chaBotsMX/chaBots-RCJ-IR-2026/Mechanical/Media/GurtV2.PNG

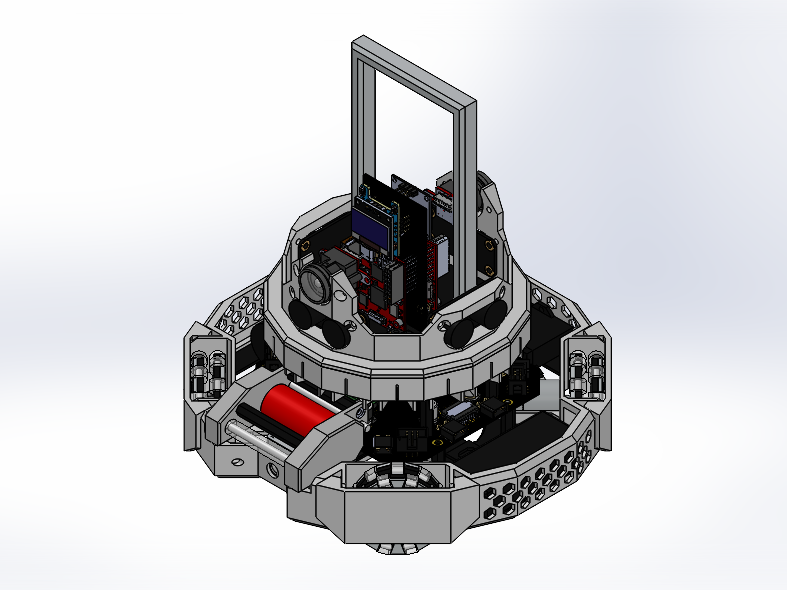
Mechanical/Media/GurtV2.PNG
