chaBotsMX/chaBots-RCJ-IR-2026/Mechanical/Media/GurtV1.PNG

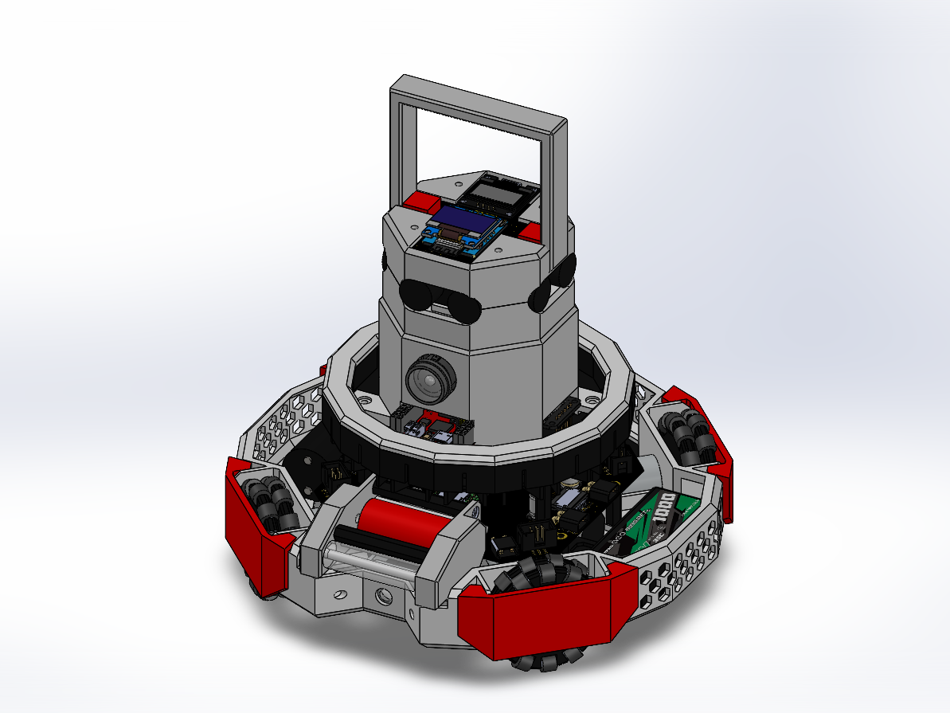
Mechanical/Media/GurtV1.PNG
