chaBotsMX/chaBots-RCJ-IR-2026/Electrical/Media/BallSensor16.png

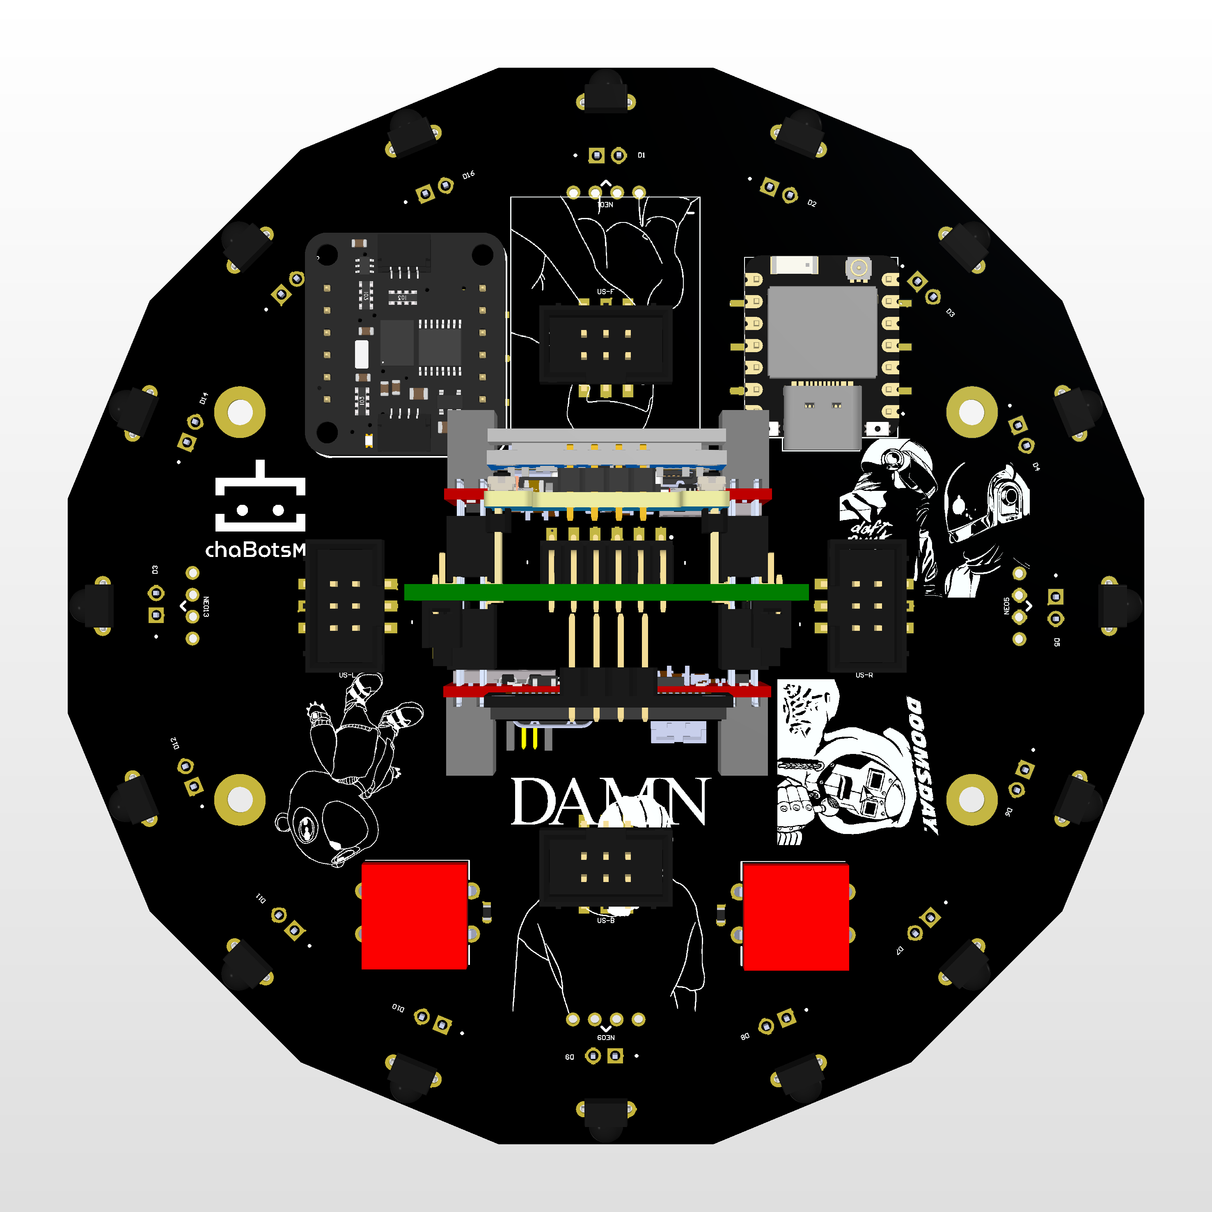
Electrical/Media/BallSensor16.png
