chaBotsMX/chaBots-RCJ-IR-2026/Electrical/Media/LightArray.png

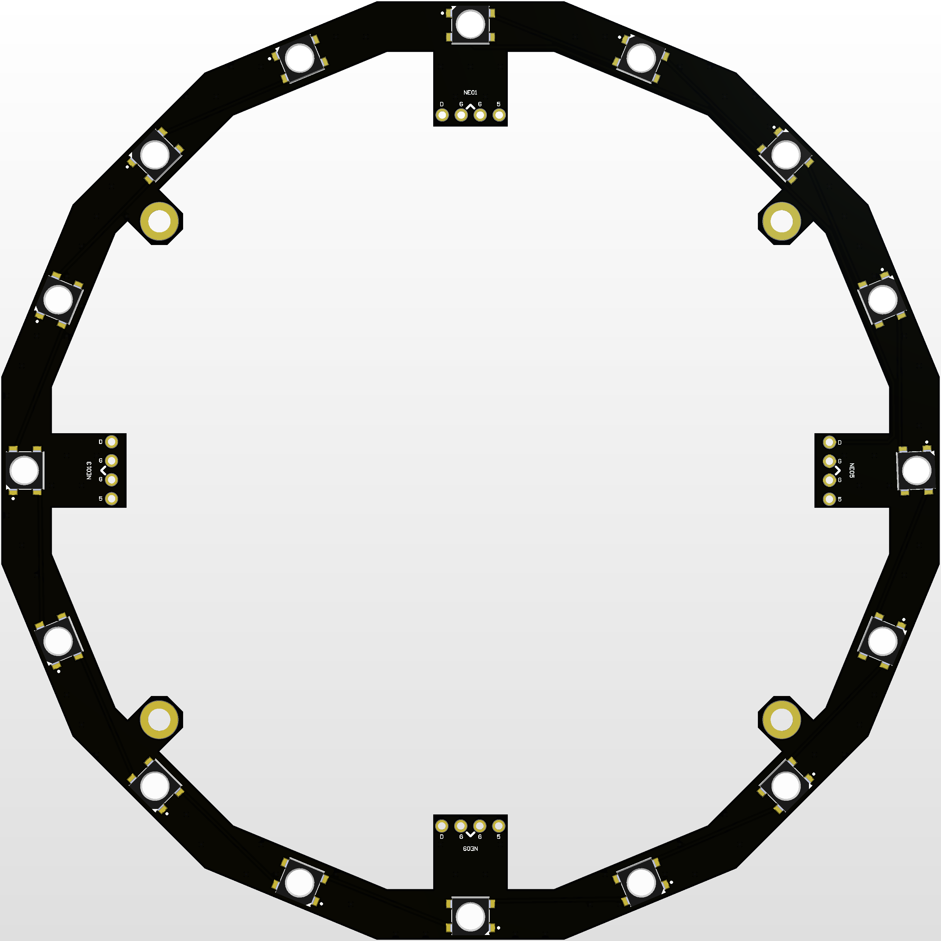
Electrical/Media/LightArray.png
