chaBotsMX/chaBots-RCJ-IR-2026/Electrical/Media/LightBarrier.png

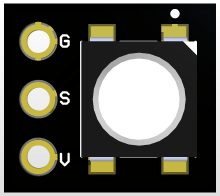
Electrical/Media/LightBarrier.png
