chaBotsMX/chaBots-RCJ-IR-2026/Electrical/Media/LineSensor32.png

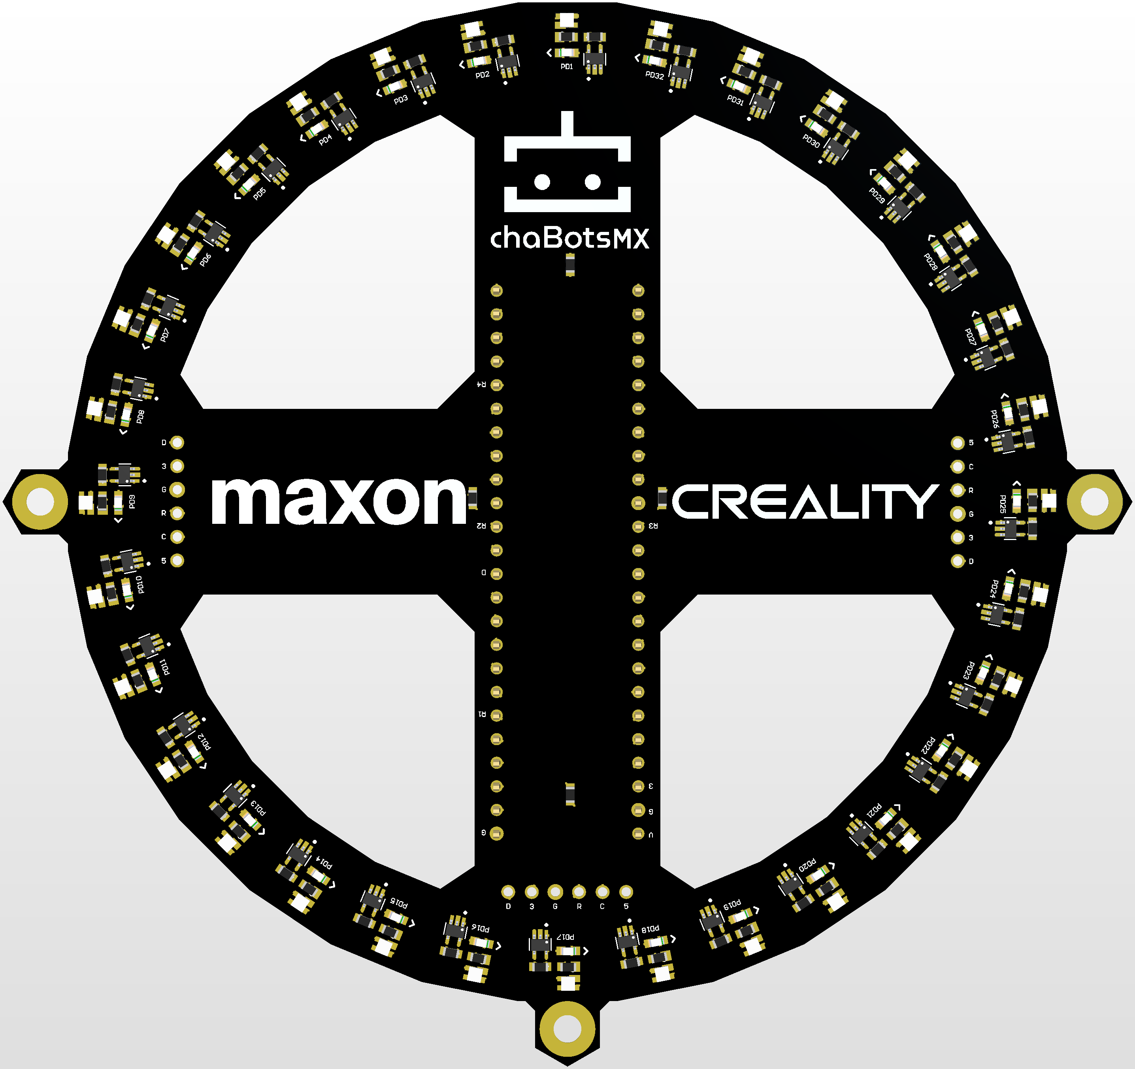
Electrical/Media/LineSensor32.png
