chaBotsMX/chaBots-RCJ-IR-2026/Electrical/Media/MainBoard-16.png

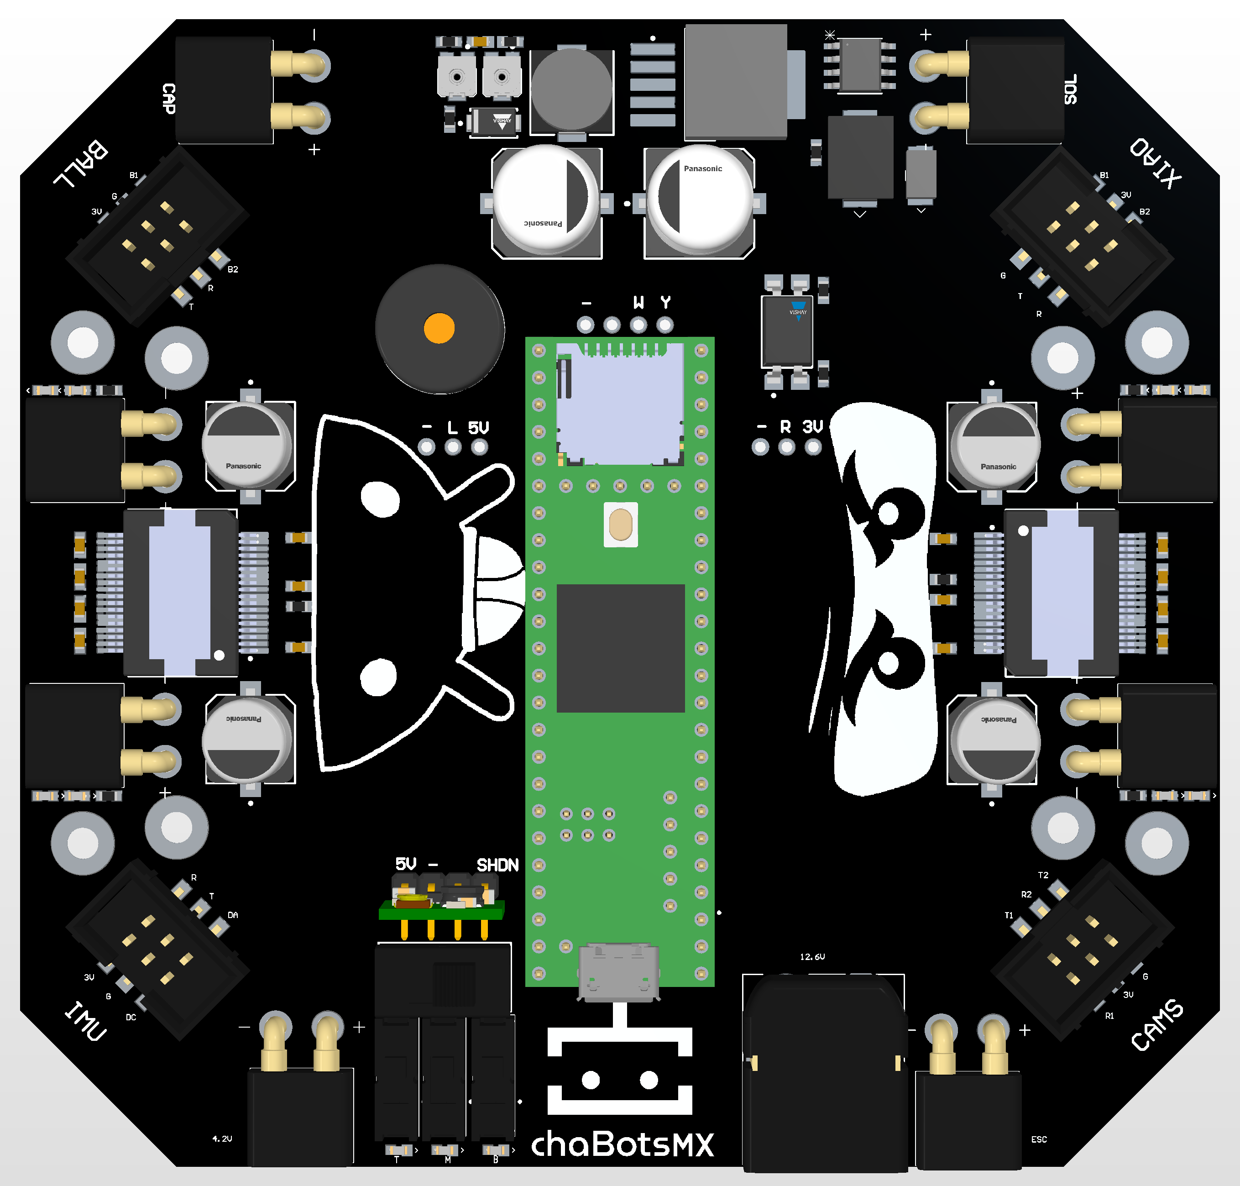
Electrical/Media/MainBoard-16.png
