chaBotsMX/chaBots-RCJ-IR-2026/Electrical/Media/OpenMVMount.png

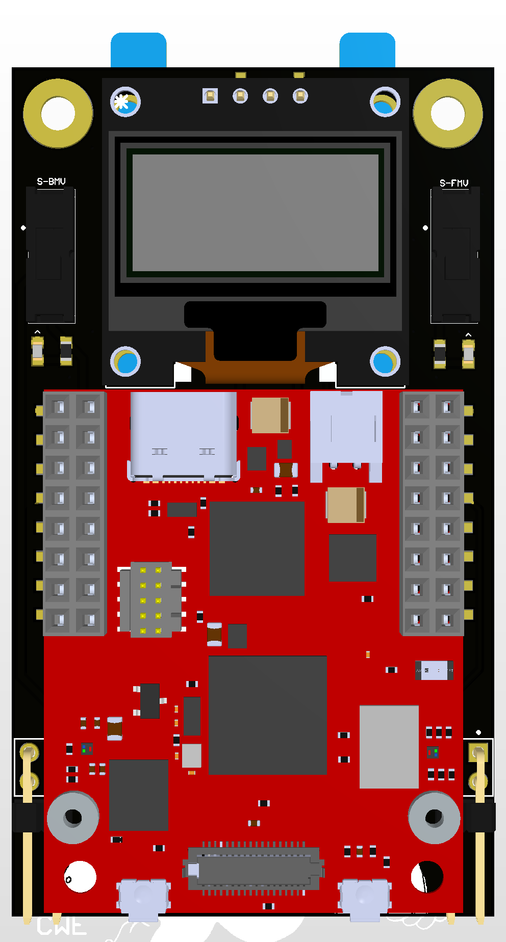
Electrical/Media/OpenMVMount.png
