chaBotsMX/chaBots-RCJ-IR-2026/Electrical/Media/SideLine.png

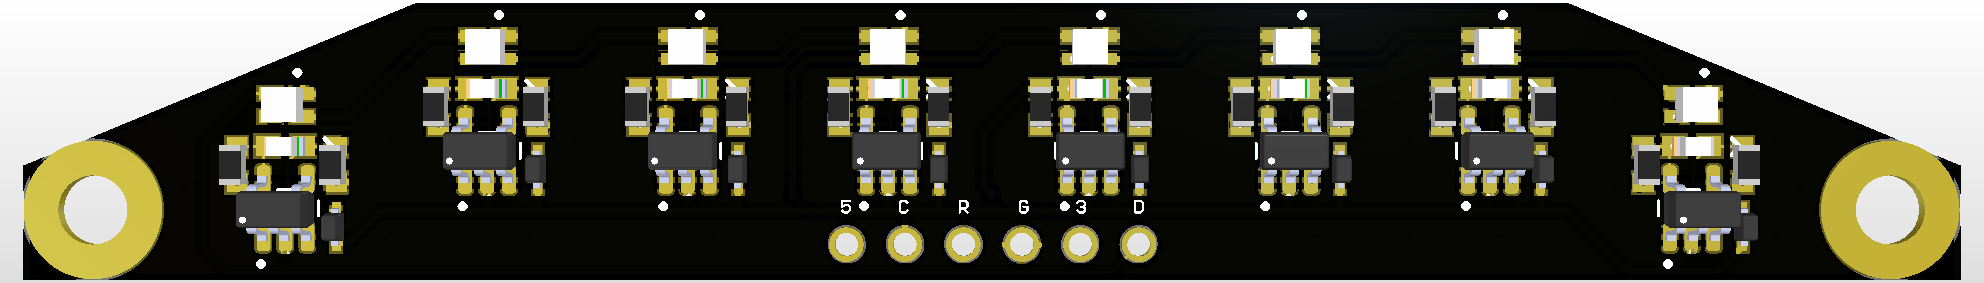
Electrical/Media/SideLine.png
