chaBotsMX/chaBots-RCJ-IR-2026/Mechanical/Media/45mm Wheel.PNG

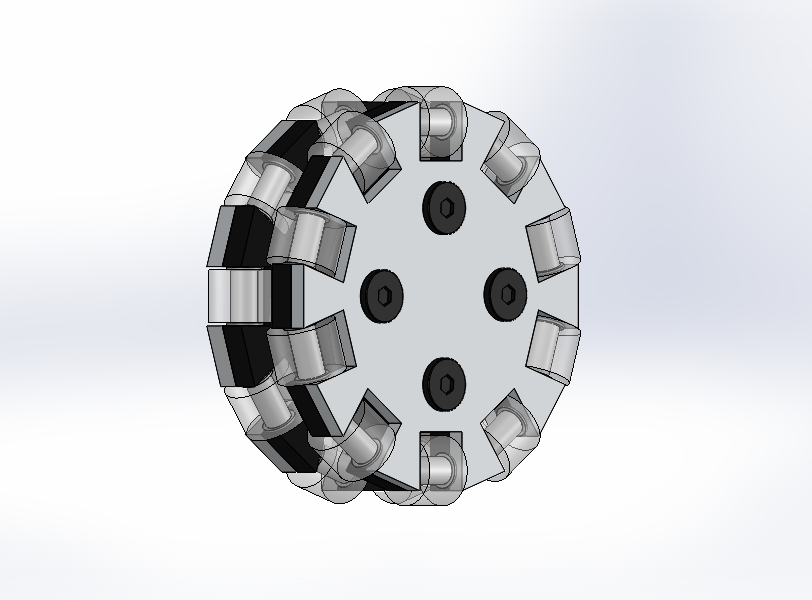
Mechanical/Media/45mm Wheel.PNG
