chaBotsMX/chaBots-RCJ-IR-2026/Mechanical/Media/Dribbler.PNG

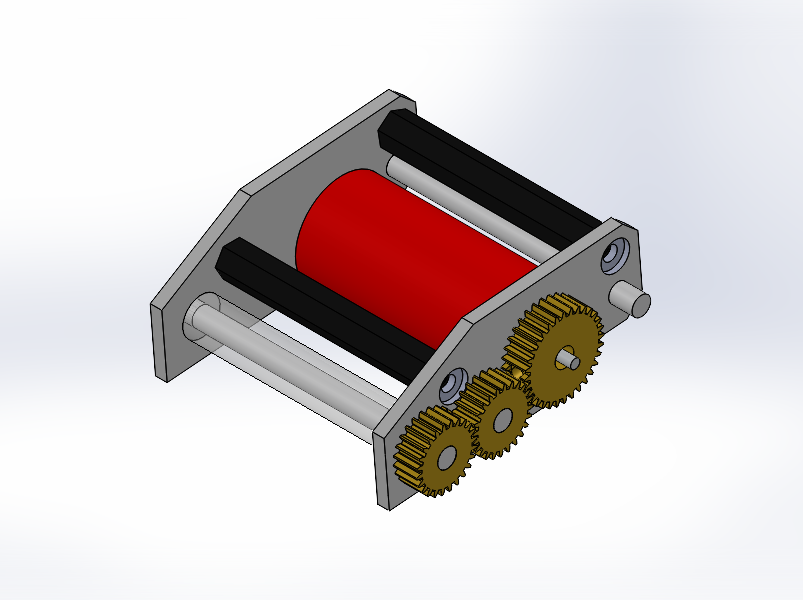
Mechanical/Media/Dribbler.PNG
