chaBotsMX/chaBots-RCJ-IR-2026/Mechanical/Dribbler/Dribbler.SLDASM

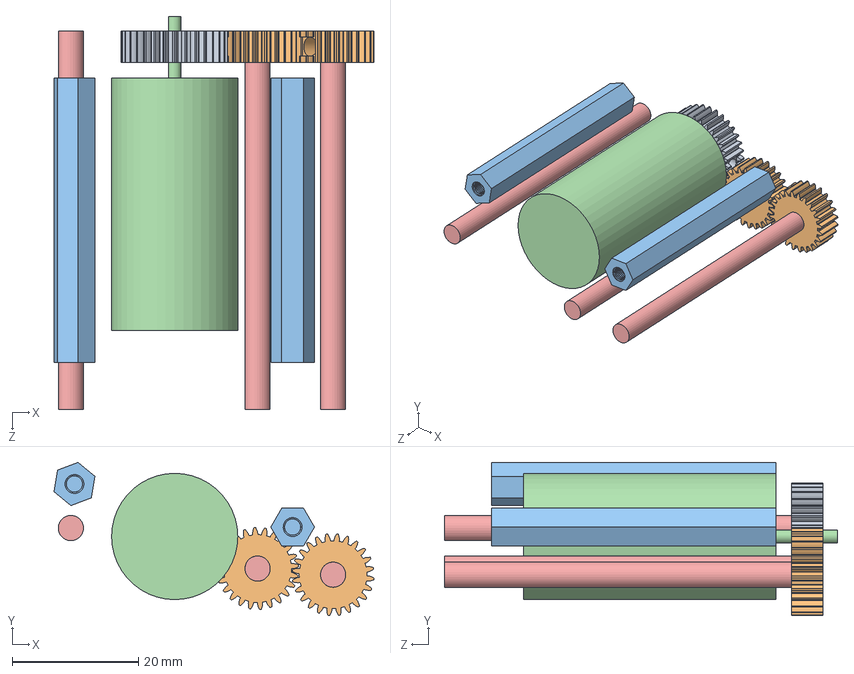
[picture p12: CAD file, 2026-05-15]
Mechanical/Dribbler/Dribbler.SLDASM
50.7 x 24.3 x 62.3 mm
dribbler-rod x 3
Standoff45mmM3 x 2
gear-small x 2
gear-big
