chaBotsMX/chaBots-RCJ-IR-2026/Mechanical/Wheel/wheel.SLDASM

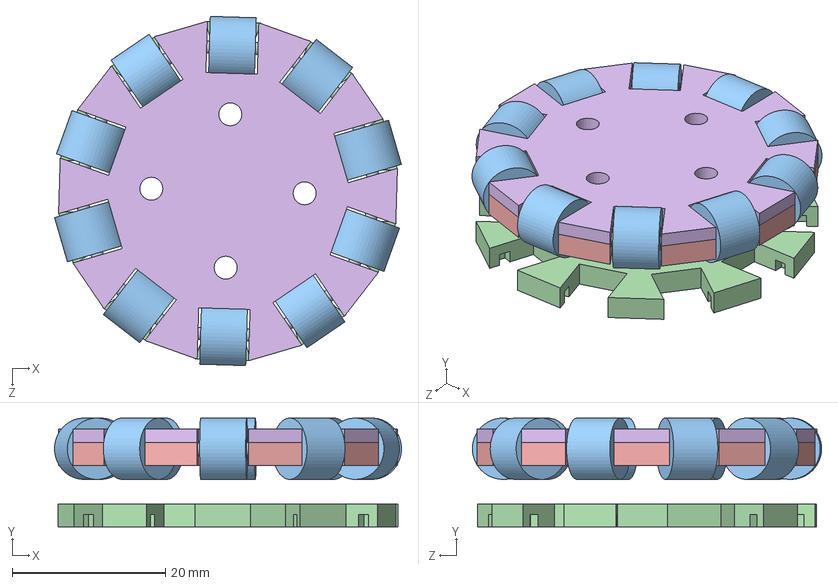
[picture p13: CAD file, 2026-05-15]
Mechanical/Wheel/wheel.SLDASM
45.2 x 14.2 x 45.5 mm
Wheel-10-Front
Wheel-10-Back
Wheel-10-Back-Back
SiliconeRoller8mm x 10
Sleeve x 10
DowelPin9mm-1.5mm x 10
