chaBotsMX/chaBots-RCJ-IR-2026/Mechanical/V2/main-pcb-shape.SLDPRT

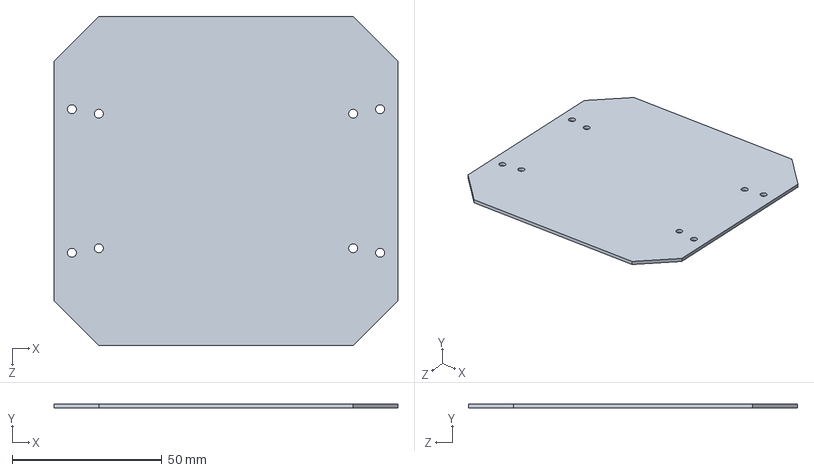
[picture p14: CAD file, 2026-05-15]
Mechanical/V2/main-pcb-shape.SLDPRT
115.0 x 1.50 x 110.0 mm
