chaBotsMX/chaBots-RCJ-IR-2026/Mechanical/Dribbler/gear-small.SLDPRT

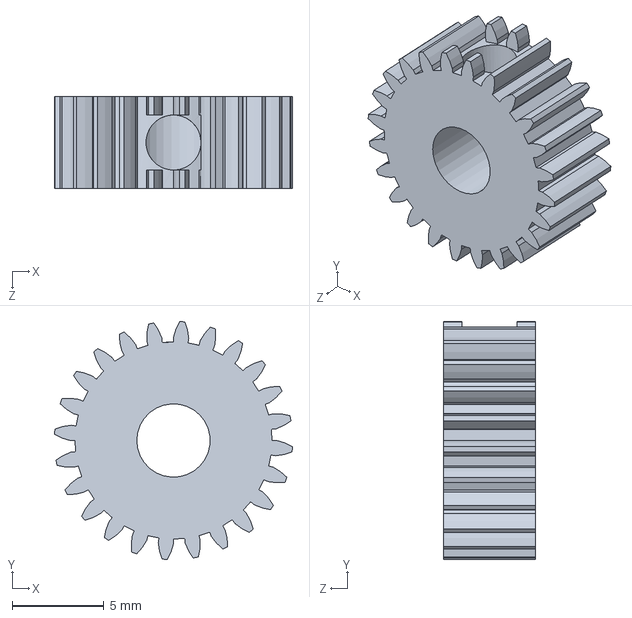
[picture p15: CAD file, 2026-05-15]
Mechanical/Dribbler/gear-small.SLDPRT
13.0 x 13.0 x 5.00 mm
