chaBotsMX/chaBots-RCJ-IR-2026/Mechanical/V2/wheel-guard.SLDPRT

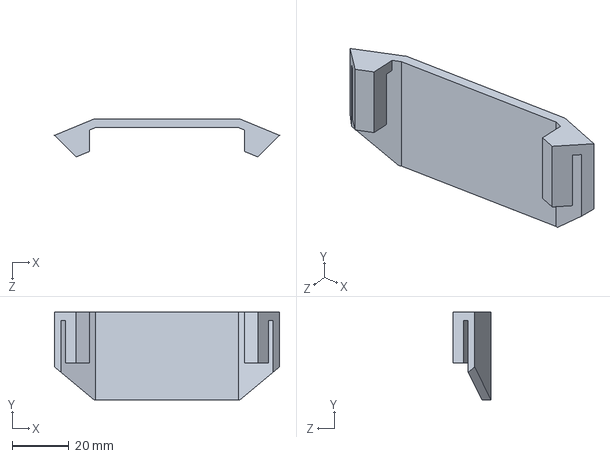
[picture p16: CAD file, 2026-05-15]
Mechanical/V2/wheel-guard.SLDPRT
79.6 x 31.0 x 13.4 mm
