chaBotsMX/chaBots-RCJ-IR-2026/Mechanical/Wheel/SiliconeRoller8mm.SLDPRT

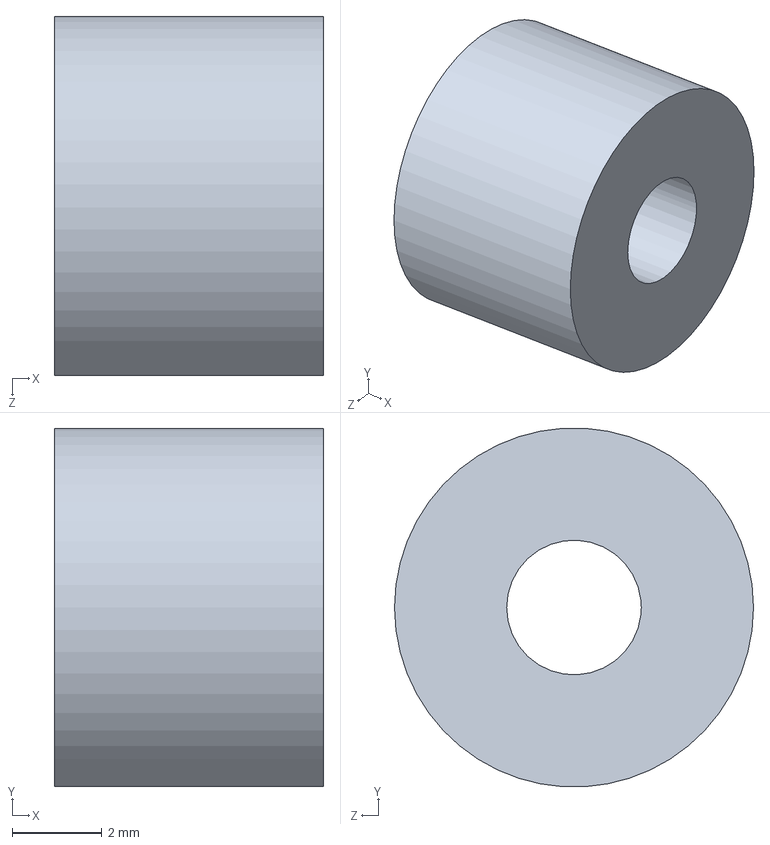
[picture p17: CAD file, 2026-05-15]
Mechanical/Wheel/SiliconeRoller8mm.SLDPRT
6.00 x 7.98 x 8.00 mm
