chaBotsMX/chaBots-RCJ-IR-2026/Mechanical/Dribbler/2040.SLDPRT

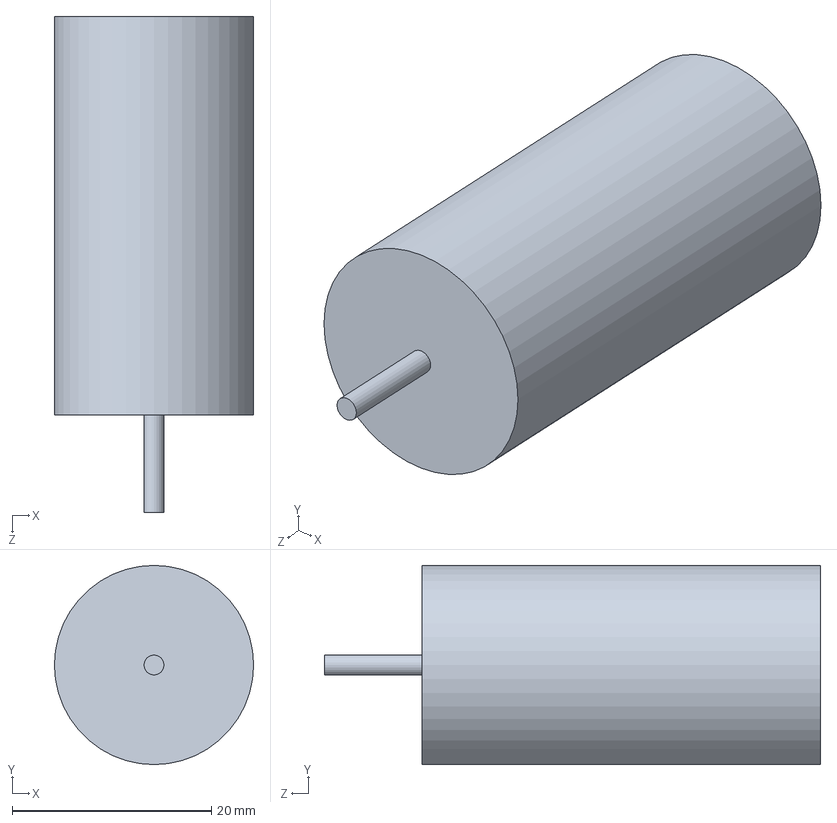
[picture p18: CAD file, 2026-05-15]
Mechanical/Dribbler/2040.SLDPRT
20.0 x 20.0 x 49.8 mm
