chaBotsMX/chaBots-RCJ-IR-2026/Mechanical/V2/3sLipo-1AH.SLDPRT

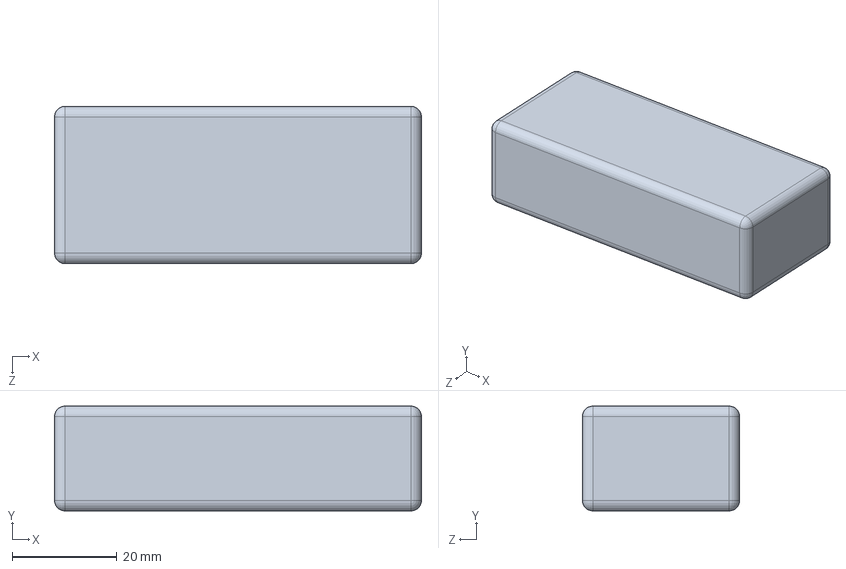
[picture p19: CAD file, 2026-05-15]
Mechanical/V2/3sLipo-1AH.SLDPRT
70.0 x 20.0 x 30.0 mm
