chaBotsMX/chaBots-RCJ-IR-2026/Mechanical/Wheel/wheel-front.SLDPRT

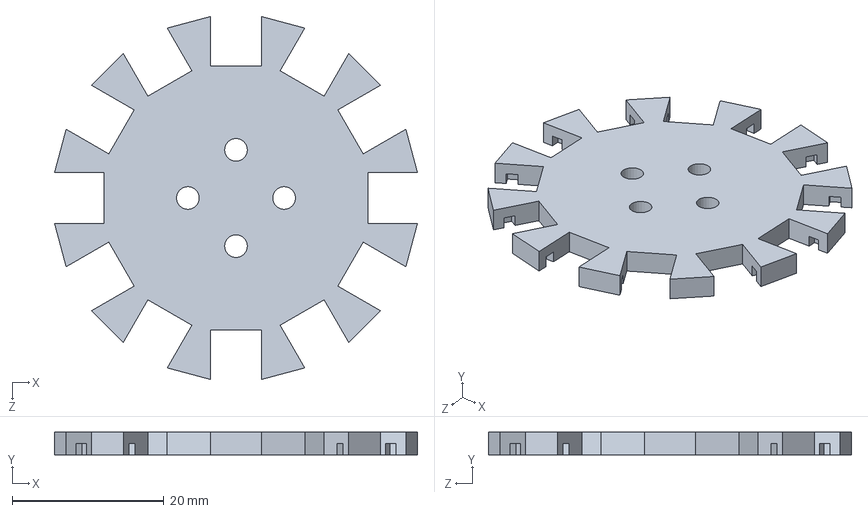
[picture p20: CAD file, 2026-05-15]
Mechanical/Wheel/wheel-front.SLDPRT
47.9 x 3.00 x 47.9 mm
