chaBotsMX/chaBots-RCJ-IR-2026/Mechanical/Dribbler/gear-big.SLDPRT

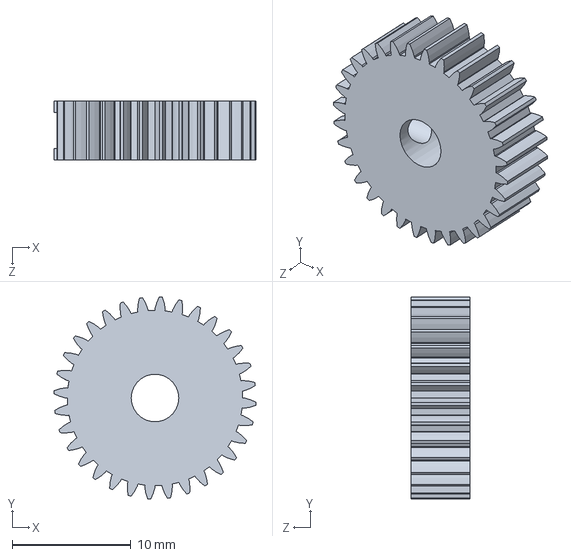
[picture p21: CAD file, 2026-05-15]
Mechanical/Dribbler/gear-big.SLDPRT
17.0 x 17.0 x 5.00 mm
