chaBotsMX/chaBots-RCJ-IR-2026/Mechanical/V2/ultrasonic-holder.SLDPRT

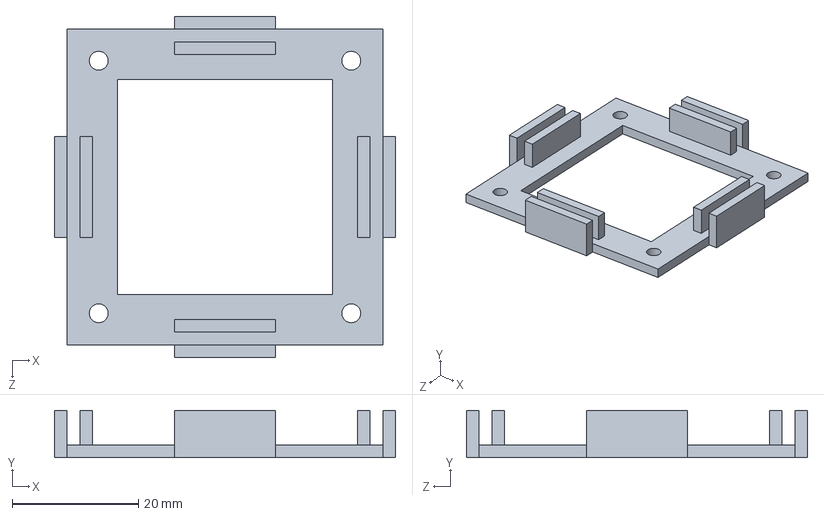
[picture p22: CAD file, 2026-05-15]
Mechanical/V2/ultrasonic-holder.SLDPRT
54.0 x 7.50 x 54.0 mm
