chaBotsMX/chaBots-RCJ-IR-2026/Mechanical/Wheel/Sleeve-.4.STL

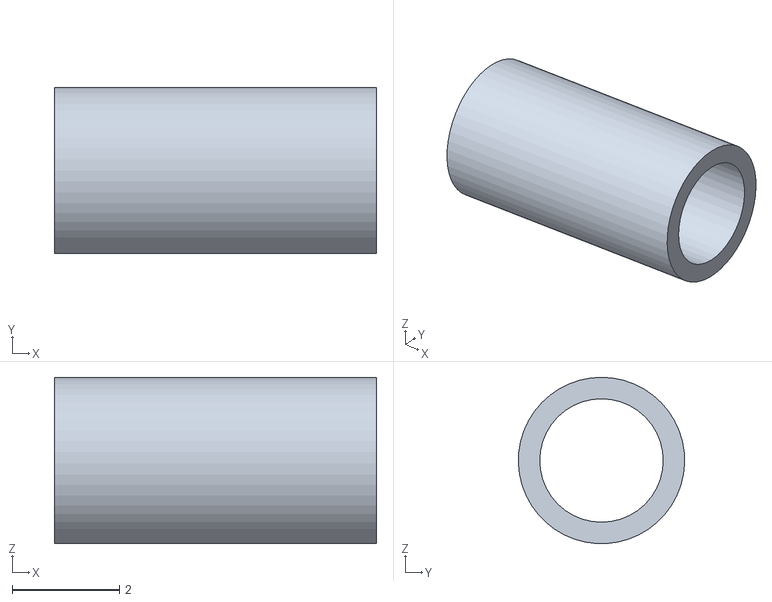
[picture p23: CAD file, 2026-05-15]
Mechanical/Wheel/Sleeve-.4.STL
6.00 x 3.10 x 3.10
