chaBotsMX/chaBots-RCJ-IR-2026/Mechanical/Dribbler/Standoff45mmM3.SLDPRT

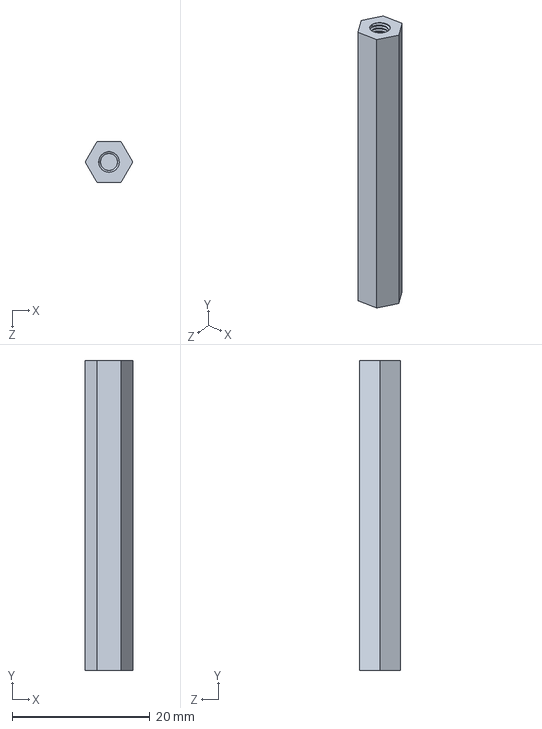
[picture p24: CAD file, 2026-05-15]
Mechanical/Dribbler/Standoff45mmM3.SLDPRT
6.93 x 45.0 x 6.00 mm
