chaBotsMX/chaBots-RCJ-IR-2026/Mechanical/V2/UltraSonicPCB.SLDPRT

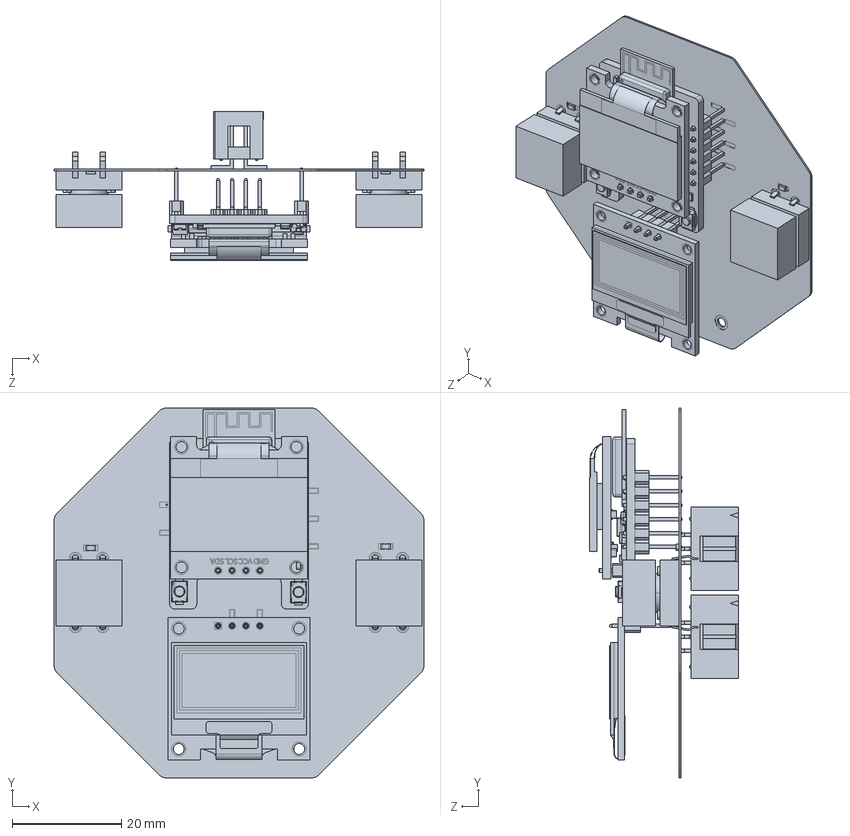
[picture p25: CAD file, 2026-05-15]
Mechanical/V2/UltraSonicPCB.SLDPRT
67.6 x 67.6 x 27.2 mm
