chaBotsMX/chaBots-RCJ-IR-2026/Mechanical/V2/Light-Diffuser-16.SLDPRT

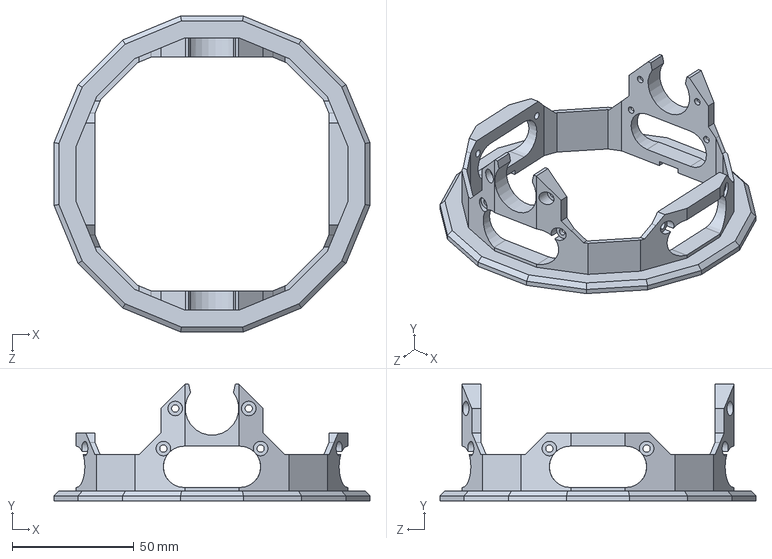
[picture p26: CAD file, 2026-05-15]
Mechanical/V2/Light-Diffuser-16.SLDPRT
130.0 x 48.0 x 130.0 mm
