chaBotsMX/chaBots-RCJ-IR-2026/Mechanical/Wheel/Wheel-10-Back-Back-Back.SLDPRT

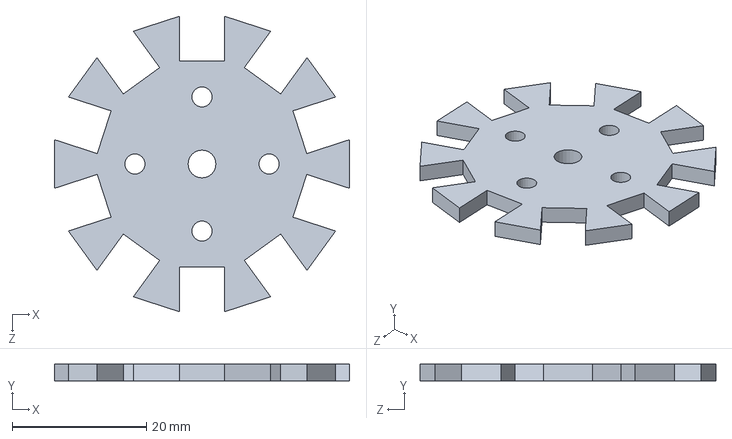
[picture p27: CAD file, 2026-05-15]
Mechanical/Wheel/Wheel-10-Back-Back-Back.SLDPRT
44.0 x 2.50 x 44.1 mm
