chaBotsMX/chaBots-RCJ-IR-2026/Mechanical/Dribbler/dribbler-rod.SLDPRT

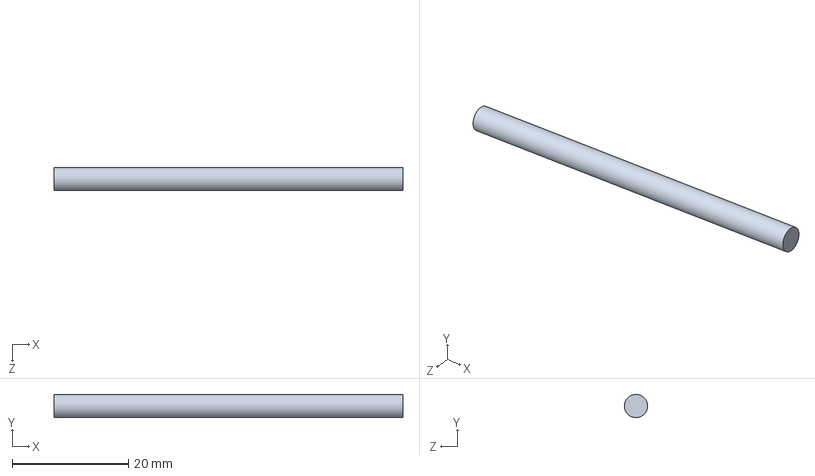
[picture p28: CAD file, 2026-05-15]
Mechanical/Dribbler/dribbler-rod.SLDPRT
60.0 x 3.99 x 4.00 mm
