chaBotsMX/chaBots-RCJ-IR-2026/Mechanical/V2/ChasisV1-16.SLDPRT

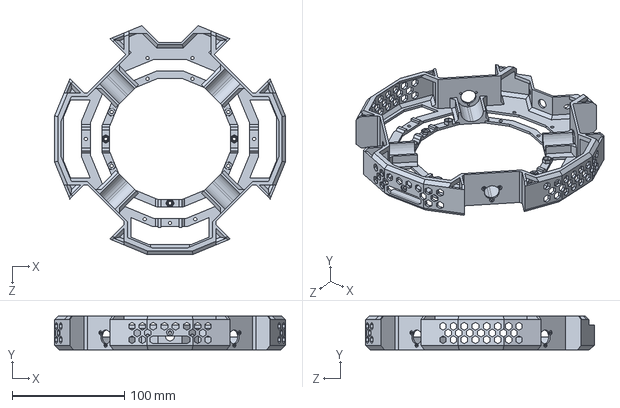
[picture p29: CAD file, 2026-05-15]
Mechanical/V2/ChasisV1-16.SLDPRT
206.0 x 30.0 x 204.1 mm
