chaBotsMX/chaBots-RCJ-IR-2026/Mechanical/Wheel/Sleeve.SLDPRT

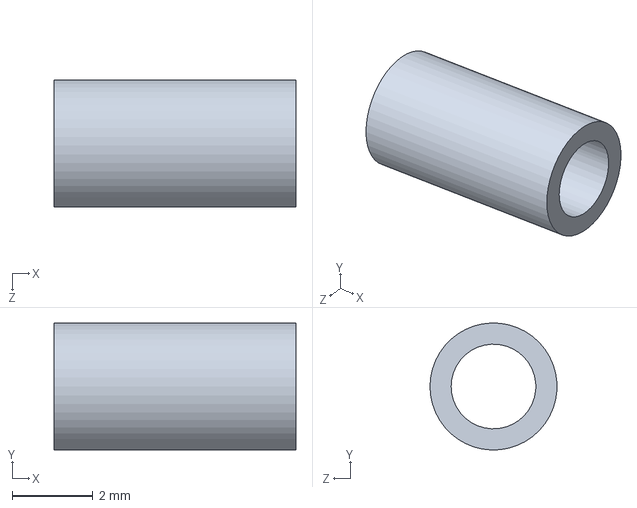
[picture p30: CAD file, 2026-05-15]
Mechanical/Wheel/Sleeve.SLDPRT
6.00 x 3.15 x 3.15 mm
