chaBotsMX/chaBots-RCJ-IR-2026/Mechanical/V2/BallSensor-PCB-16.SLDPRT

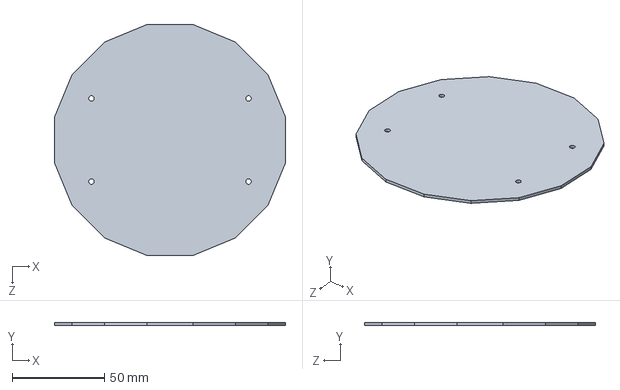
[picture p31: CAD file, 2026-05-15]
Mechanical/V2/BallSensor-PCB-16.SLDPRT
125.0 x 1.60 x 125.0 mm
