chaBotsMX/chaBots-RCJ-IR-2026/Mechanical/Wheel/Wheel-10-Back-Back.SLDPRT

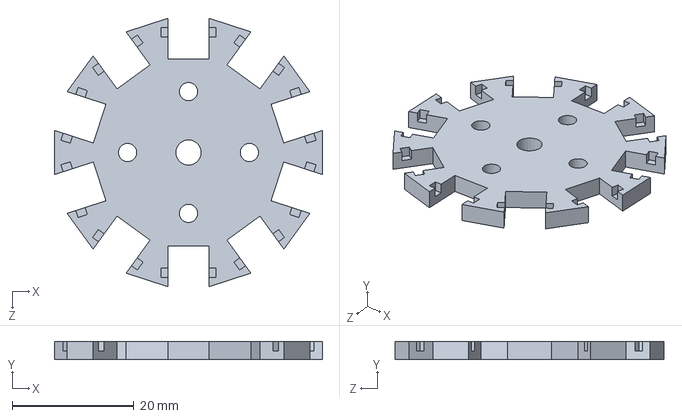
[picture p32: CAD file, 2026-05-15]
Mechanical/Wheel/Wheel-10-Back-Back.SLDPRT
44.0 x 3.00 x 44.1 mm
