chaBotsMX/chaBots-RCJ-IR-2026/Mechanical/V2/TopPCB.SLDPRT

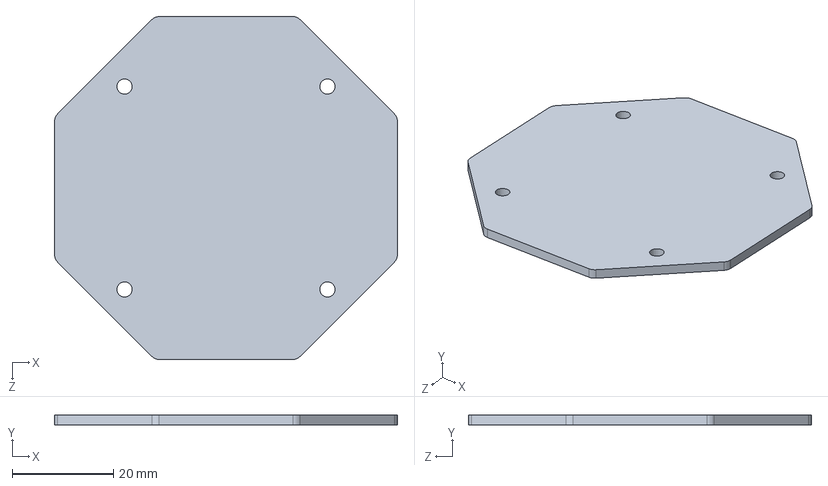
[picture p33: CAD file, 2026-05-15]
Mechanical/V2/TopPCB.SLDPRT
67.6 x 2.00 x 67.6 mm
