chaBotsMX/chaBots-RCJ-IR-2026/Mechanical/Wheel/Tornillo-8-M3.SLDPRT

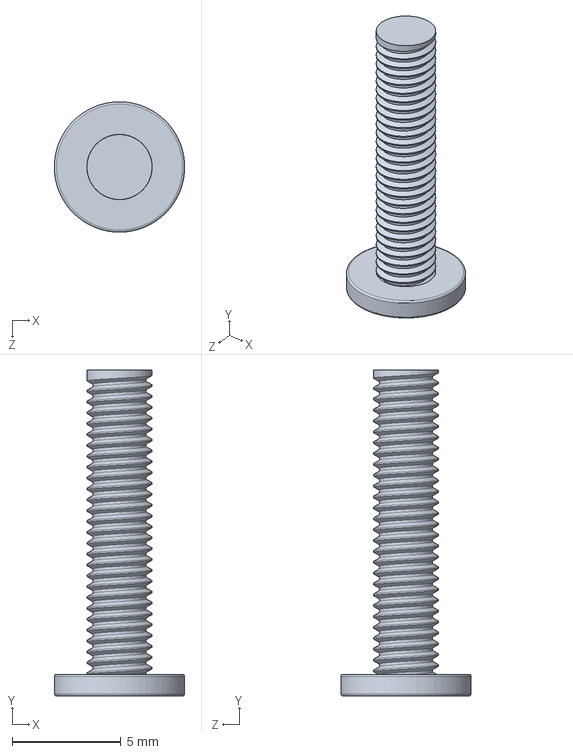
[picture p34: CAD file, 2026-05-15]
Mechanical/Wheel/Tornillo-8-M3.SLDPRT
6.00 x 15.0 x 6.00 mm
