chaBotsMX/chaBots-RCJ-IR-2026/Mechanical/V2/LineSensorSide.SLDPRT

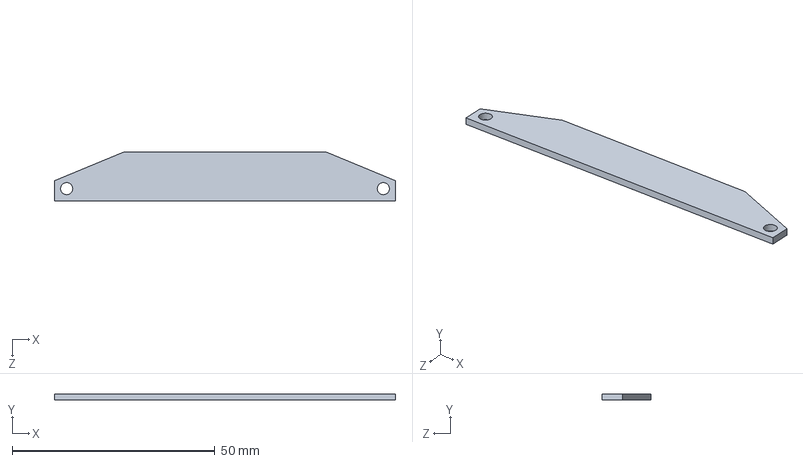
[picture p35: CAD file, 2026-05-15]
Mechanical/V2/LineSensorSide.SLDPRT
84.0 x 1.60 x 12.0 mm
