chaBotsMX/chaBots-RCJ-IR-2026/Mechanical/Wheel/DowelPin9mm-1.5mm.SLDPRT

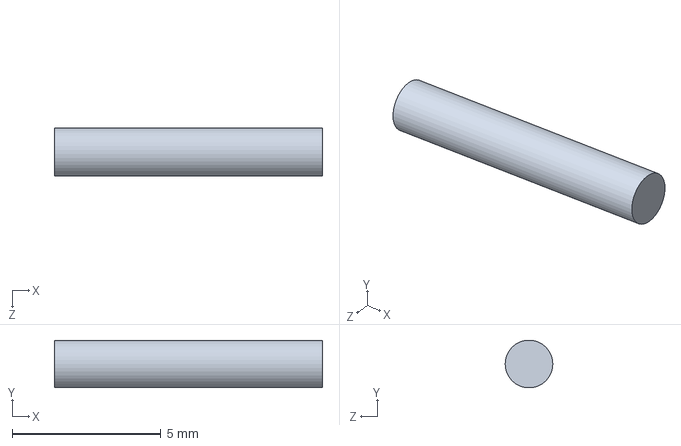
[picture p36: CAD file, 2026-05-15]
Mechanical/Wheel/DowelPin9mm-1.5mm.SLDPRT
9.00 x 1.59 x 1.60 mm
