chaBotsMX/chaBots-RCJ-IR-2026/Mechanical/V2/BNO085-PINS.SLDPRT

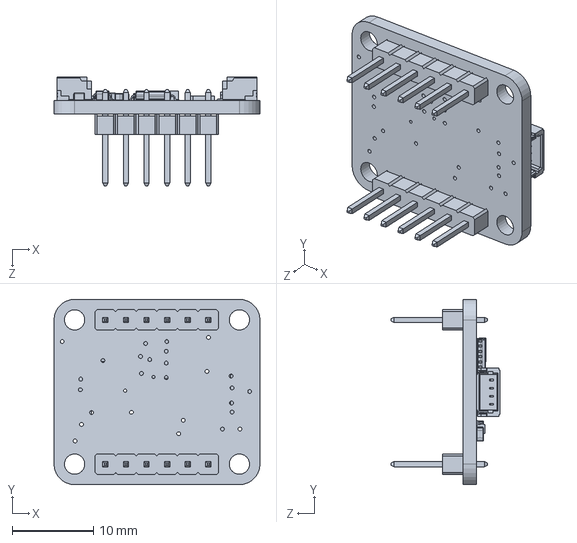
[picture p37: CAD file, 2026-05-15]
Mechanical/V2/BNO085-PINS.SLDPRT
25.4 x 22.9 x 13.5 mm
