chaBotsMX/chaBots-RCJ-IR-2026/Mechanical/Wheel/Wheel-10-Front.SLDPRT

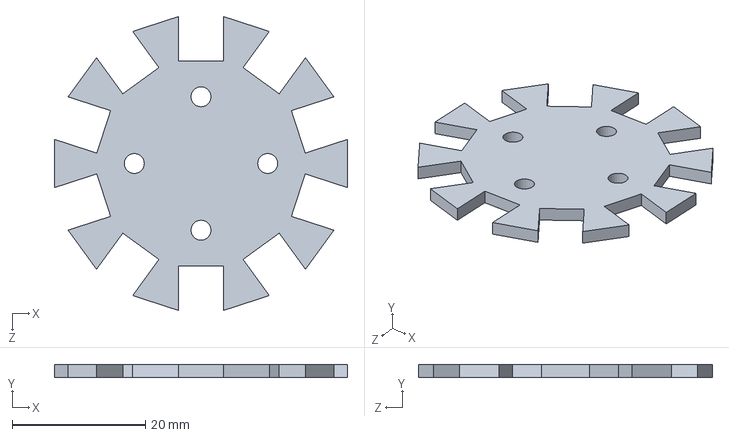
[picture p38: CAD file, 2026-05-15]
Mechanical/Wheel/Wheel-10-Front.SLDPRT
44.0 x 2.00 x 44.1 mm
