chaBotsMX/chaBots-RCJ-IR-2026/Mechanical/V2/LineSensor32Case.SLDPRT

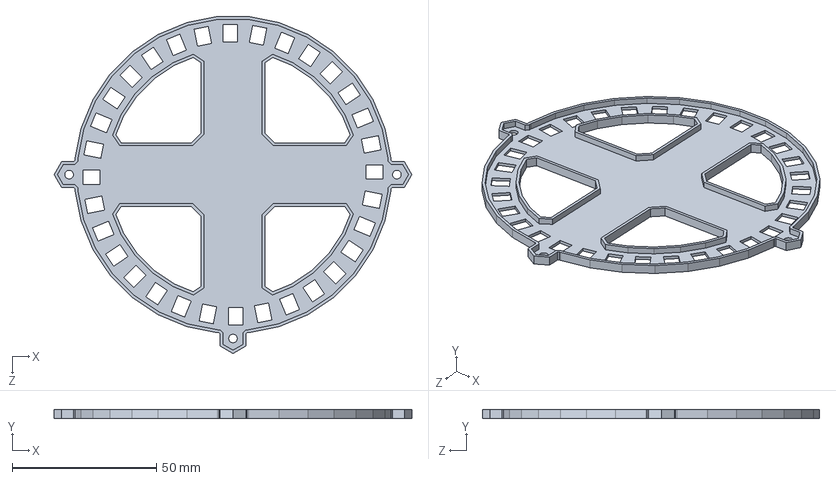
[picture p39: CAD file, 2026-05-15]
Mechanical/V2/LineSensor32Case.SLDPRT
123.9 x 3.00 x 116.7 mm
