chaBotsMX/chaBots-RCJ-IR-2026/Mechanical/V2/step_w_cb1037.SLDPRT

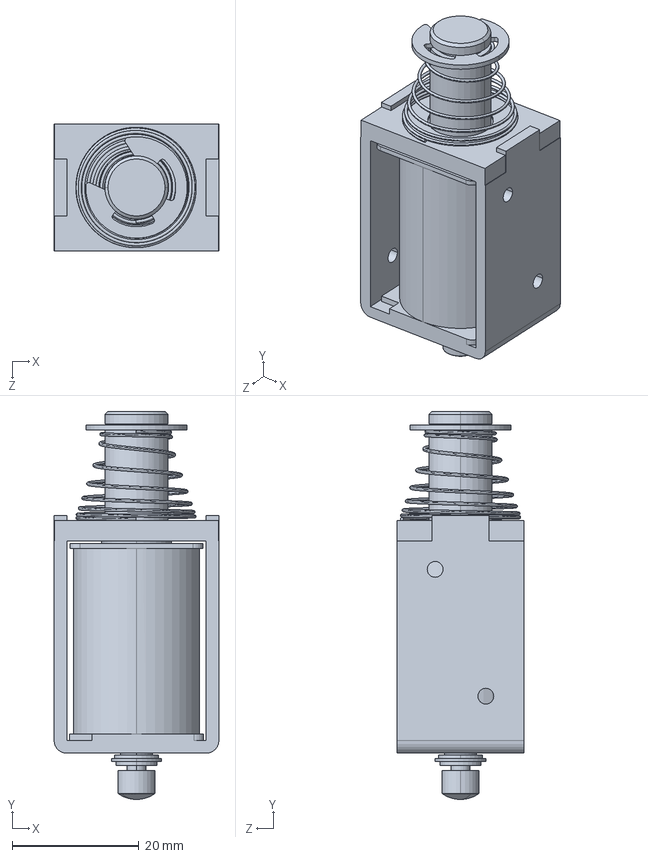
[picture p40: CAD file, 2026-05-15]
Mechanical/V2/step_w_cb1037.SLDPRT
26.0 x 61.2 x 20.0 mm
