chaBotsMX/chaBots-RCJ-IR-2026/Mechanical/V2/towerbottom.SLDPRT

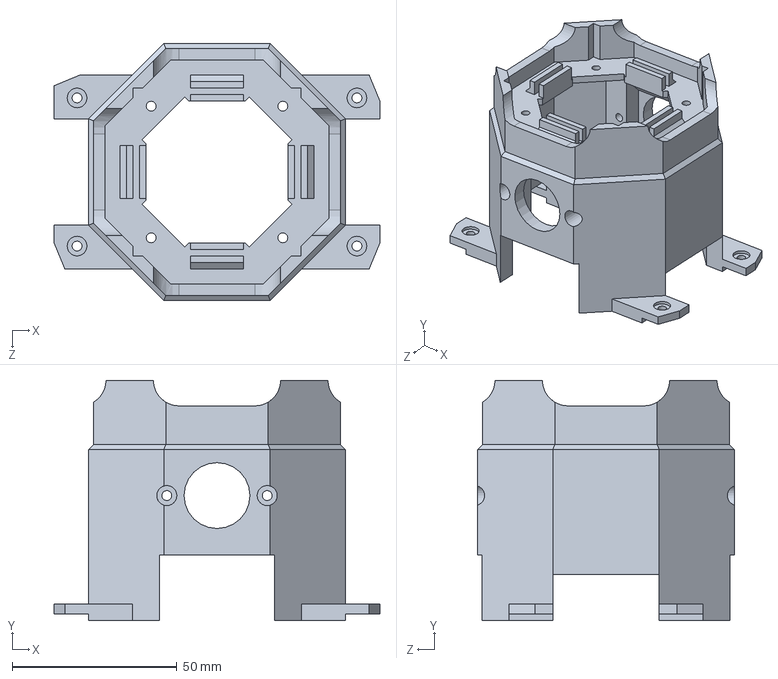
[picture p41: CAD file, 2026-05-15]
Mechanical/V2/towerbottom.SLDPRT
99.0 x 73.0 x 78.0 mm
