chaBotsMX/chaBots-RCJ-IR-2026/Mechanical/V2/BallSensor-Filter-16.SLDPRT

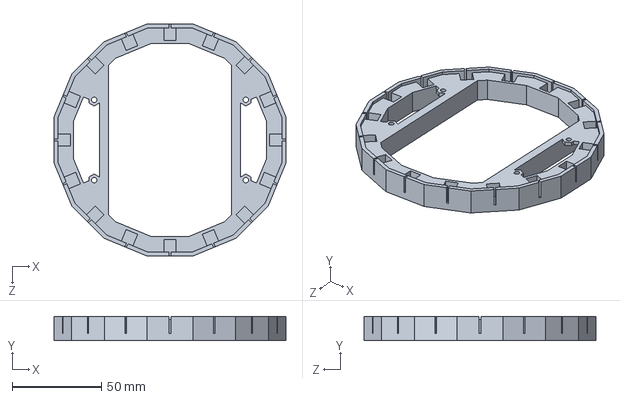
[picture p42: CAD file, 2026-05-15]
Mechanical/V2/BallSensor-Filter-16.SLDPRT
130.0 x 13.5 x 130.0 mm
