chaBotsMX/chaBots-RCJ-IR-2026/Mechanical/V2/capacitor.SLDPRT

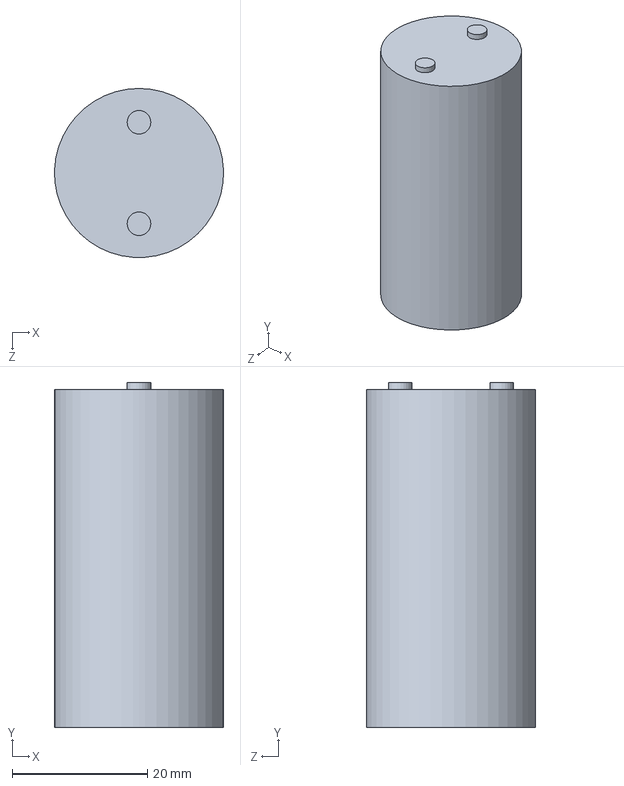
[picture p43: CAD file, 2026-05-15]
Mechanical/V2/capacitor.SLDPRT
25.0 x 51.0 x 25.0 mm
