chaBotsMX/chaBots-RCJ-IR-2026/Mechanical/V2/B3F-4050--3DModel-STEP-273799.SLDPRT

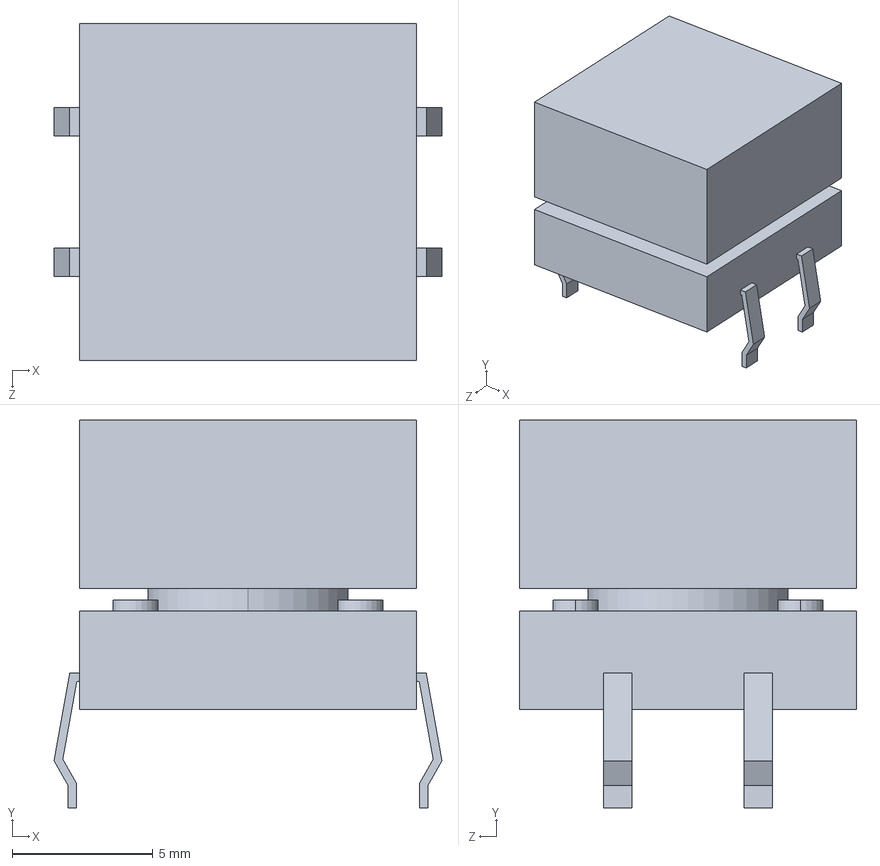
[picture p44: CAD file, 2026-05-15]
Mechanical/V2/B3F-4050--3DModel-STEP-273799.SLDPRT
13.8 x 13.8 x 12.0 mm
