chaBotsMX/chaBots-RCJ-IR-2026/Mechanical/V2/USB-holder.SLDPRT

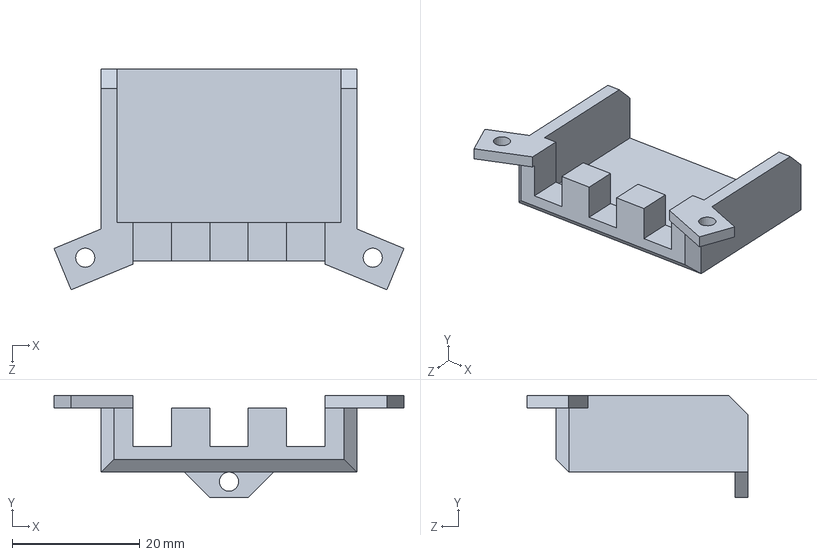
[picture p45: CAD file, 2026-05-15]
Mechanical/V2/USB-holder.SLDPRT
54.8 x 16.0 x 34.5 mm
