chaBotsMX/chaBots-RCJ-IR-2026/Mechanical/V2/OpenMV-WideLens.SLDPRT

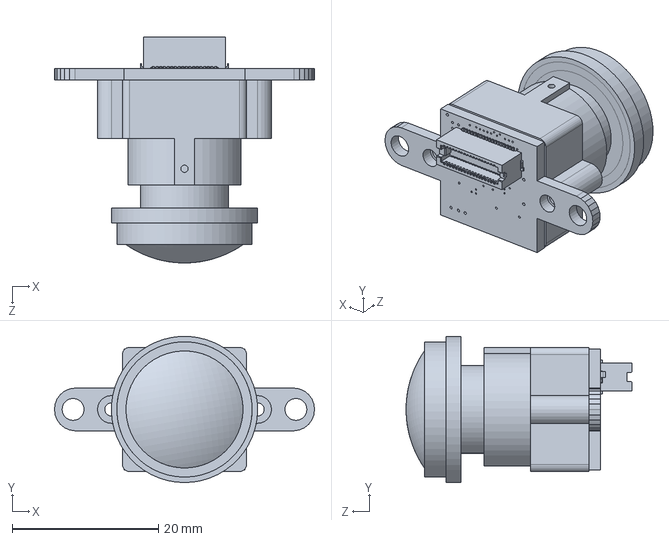
[picture p46: CAD file, 2026-05-15]
Mechanical/V2/OpenMV-WideLens.SLDPRT
35.6 x 20.0 x 30.9 mm
