chaBotsMX/chaBots-RCJ-IR-2026/Mechanical/V2/Standoff40mmM3.SLDPRT

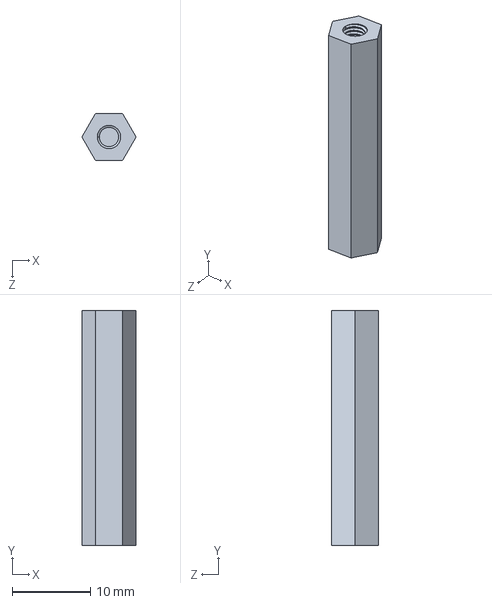
[picture p47: CAD file, 2026-05-15]
Mechanical/V2/Standoff40mmM3.SLDPRT
6.93 x 30.0 x 6.00 mm
