chaBotsMX/chaBots-RCJ-IR-2026/Mechanical/V2/kicker-bracket.SLDPRT

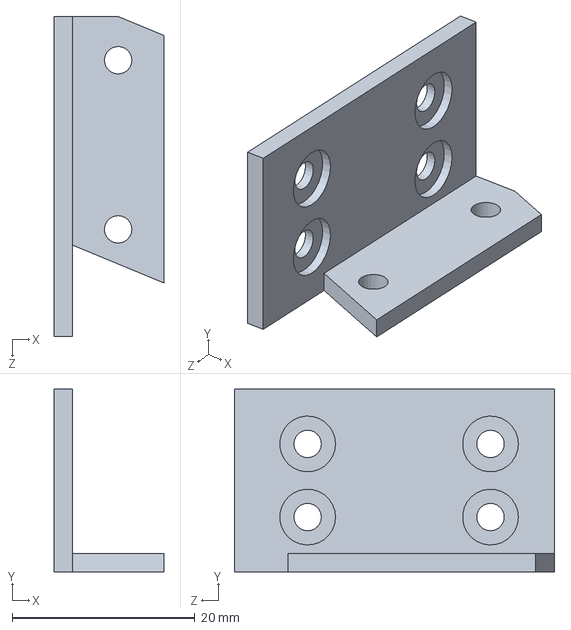
[picture p48: CAD file, 2026-05-15]
Mechanical/V2/kicker-bracket.SLDPRT
12.0 x 20.0 x 35.0 mm
