chaBotsMX/chaBots-RCJ-IR-2026/Mechanical/V2/modul_v3.SLDPRT

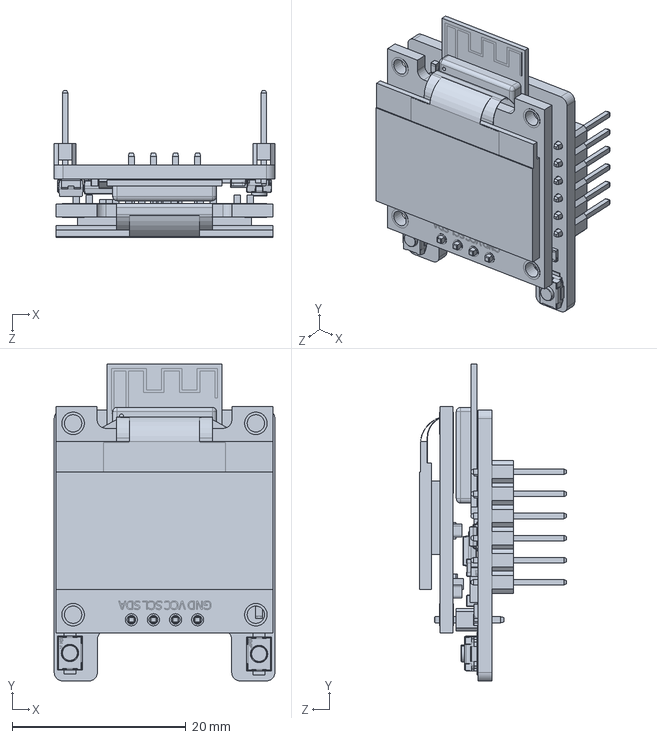
[picture p49: CAD file, 2026-05-15]
Mechanical/V2/modul_v3.SLDPRT
25.4 x 36.4 x 16.9 mm
