chaBotsMX/chaBots-RCJ-IR-2026/Mechanical/V2/DM-OLED096-636--3DModel-STEP-56544.SLDPRT

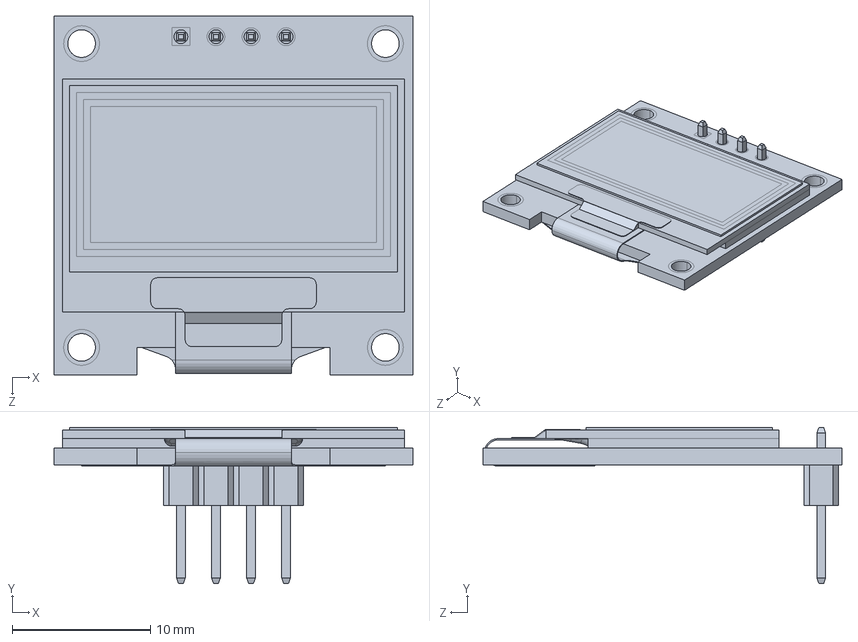
[picture p51: CAD file, 2026-05-15]
Mechanical/V2/DM-OLED096-636--3DModel-STEP-56544.SLDPRT
26.0 x 11.3 x 26.0 mm
