chaBotsMX/chaBots-RCJ-IR-2026/Mechanical/V2/LightArray.SLDPRT

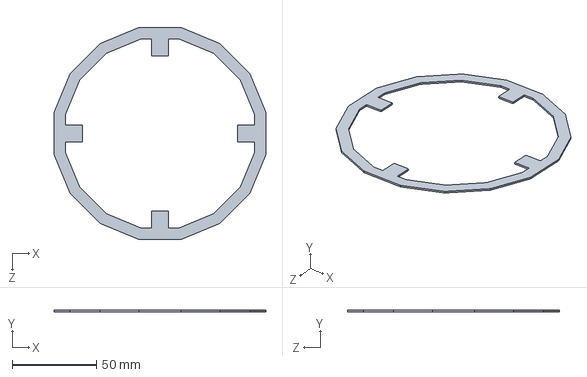
[picture p52: CAD file, 2026-05-15]
Mechanical/V2/LightArray.SLDPRT
125.5 x 1.00 x 125.5 mm
