chaBotsMX/chaBots-RCJ-IR-2026/Mechanical/V2/handle.SLDPRT

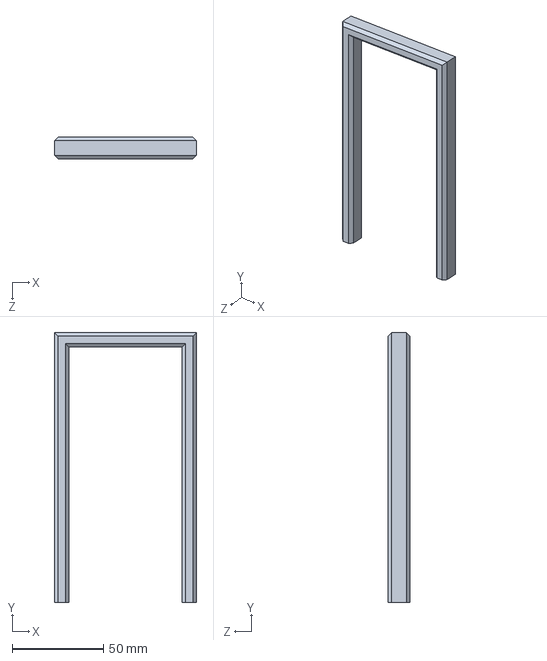
[picture p53: CAD file, 2026-05-15]
Mechanical/V2/handle.SLDPRT
78.0 x 148.0 x 12.0 mm
