chaBotsMX/chaBots-RCJ-IR-2026/Mechanical/V2/C2822 1400kv.SLDPRT

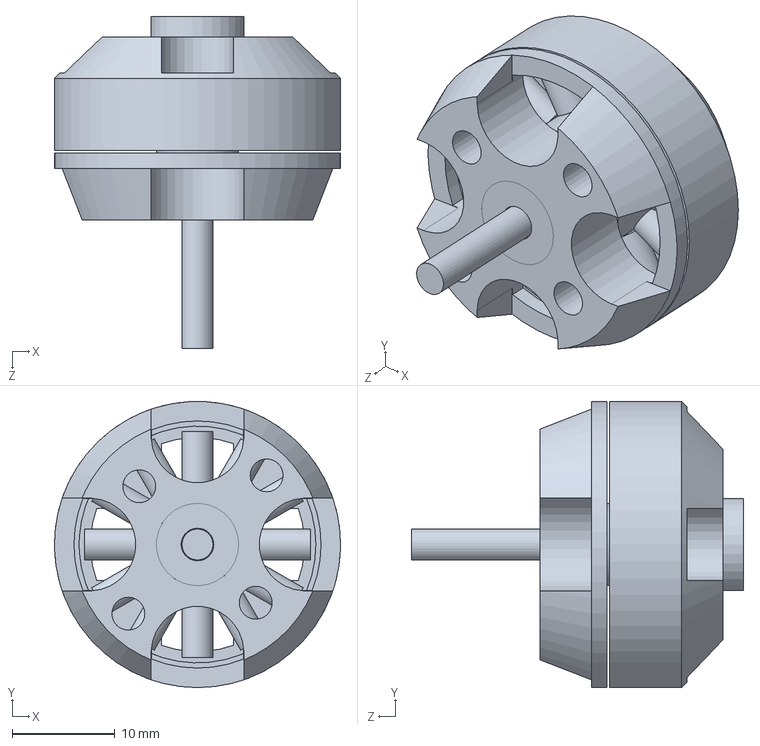
[picture p54: CAD file, 2026-05-15]
Mechanical/V2/C2822 1400kv.SLDPRT
27.8 x 27.8 x 32.2 mm
