chaBotsMX/chaBots-RCJ-IR-2026/Mechanical/V2/Standoff25mmM3.SLDPRT

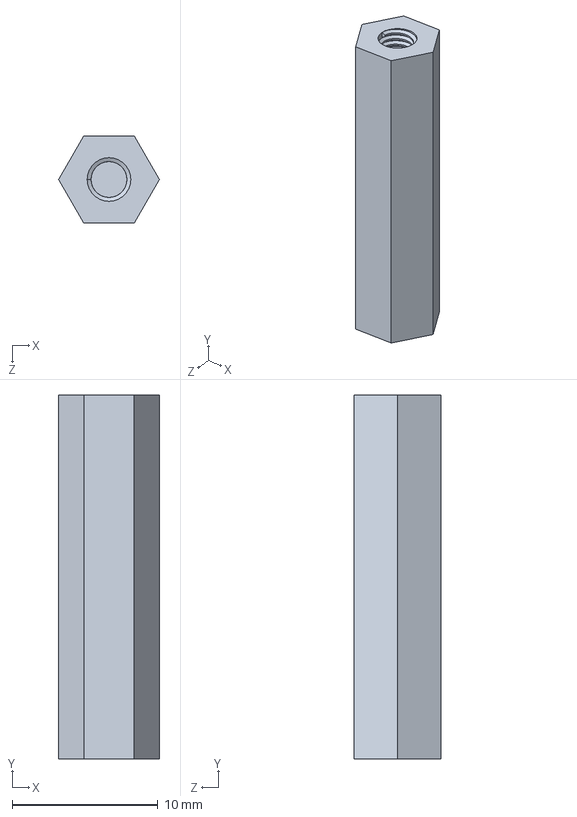
[picture p55: CAD file, 2026-05-15]
Mechanical/V2/Standoff25mmM3.SLDPRT
6.93 x 25.0 x 6.00 mm
