chaBotsMX/chaBots-RCJ-IR-2026/Mechanical/V2/42mmBall.SLDPRT

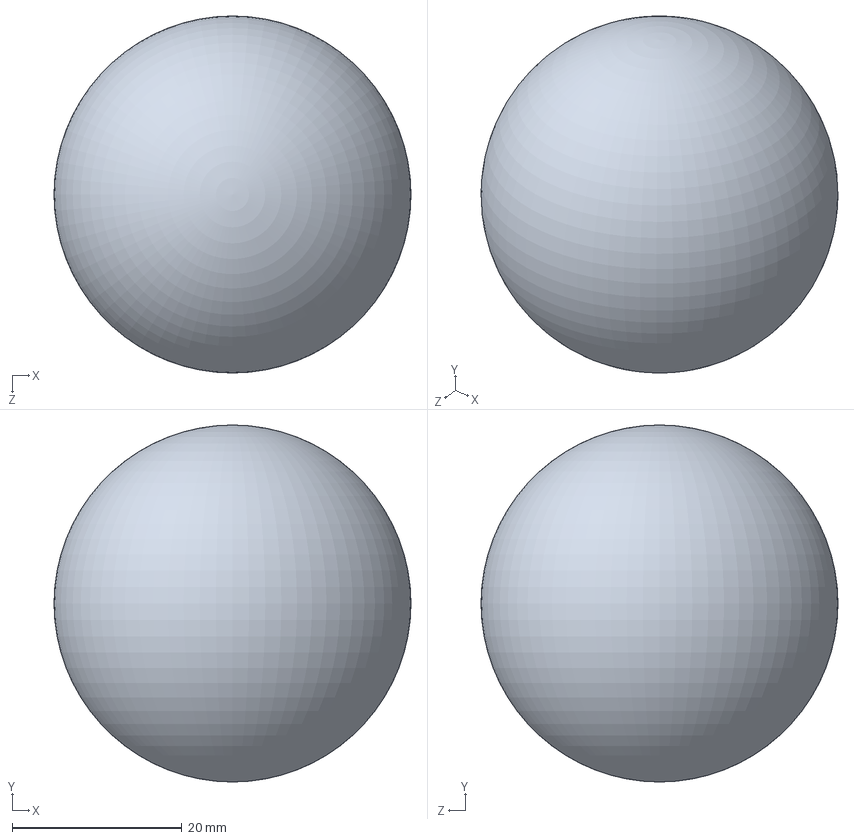
[picture p56: CAD file, 2026-05-15]
Mechanical/V2/42mmBall.SLDPRT
42.0 x 42.0 x 42.0 mm
