chaBotsMX/chaBots-RCJ-IR-2026/Mechanical/V2/PhotodiodeFilter16.SLDPRT

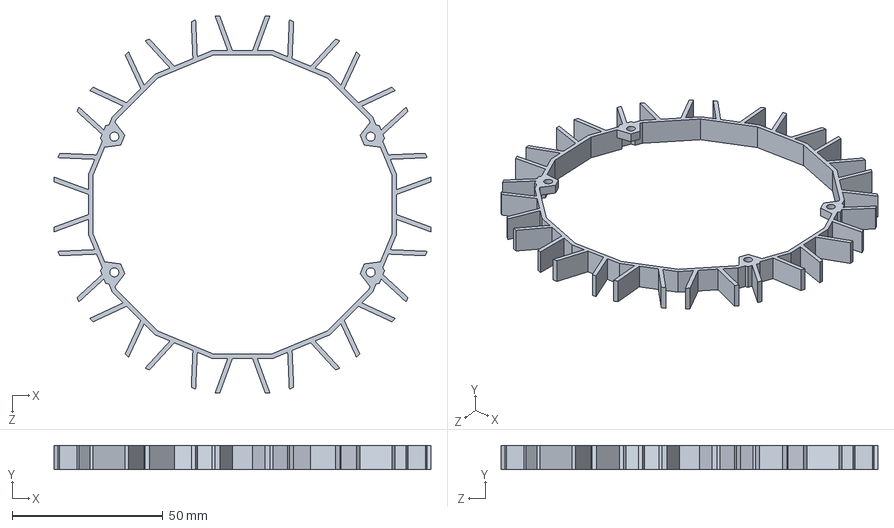
[picture p57: CAD file, 2026-05-15]
Mechanical/V2/PhotodiodeFilter16.SLDPRT
125.0 x 8.00 x 125.0 mm
