chaBotsMX/chaBots-RCJ-IR-2026/Mechanical/V2/URM09.SLDPRT

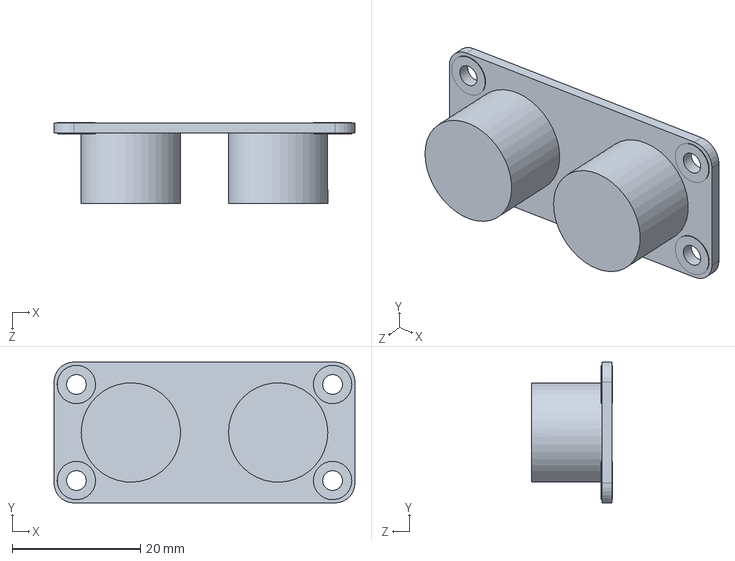
[picture p58: CAD file, 2026-05-15]
Mechanical/V2/URM09.SLDPRT
47.0 x 22.0 x 12.7 mm
