chaBotsMX/chaBots-RCJ-IR-2026/Mechanical/V2/LineSensorConector.SLDPRT

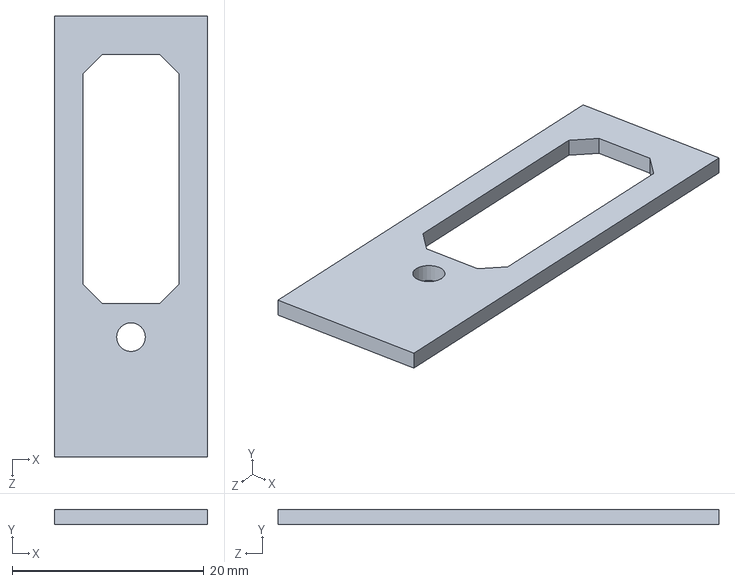
[picture p59: CAD file, 2026-05-15]
Mechanical/V2/LineSensorConector.SLDPRT
16.0 x 1.60 x 46.0 mm
