chaBotsMX/chaBots-RCJ-IR-2026/Mechanical/V2/tower-top.SLDPRT

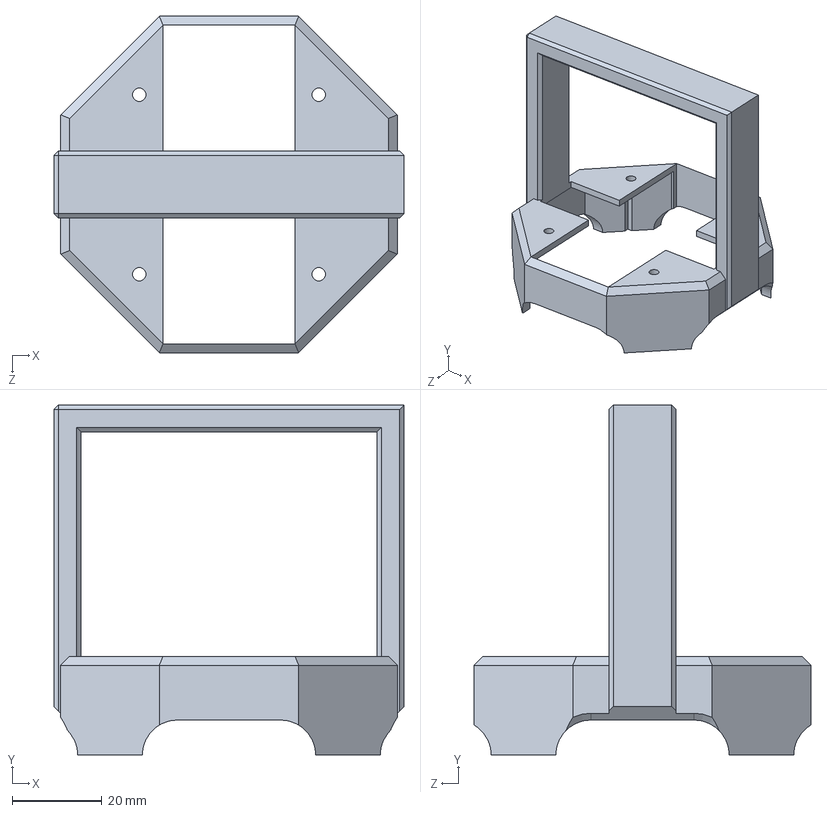
[picture p60: CAD file, 2026-05-15]
Mechanical/V2/tower-top.SLDPRT
78.0 x 78.0 x 75.0 mm
