chaBotsMX/chaBots-RCJ-IR-2026/Mechanical/V2/Maxon.SLDPRT

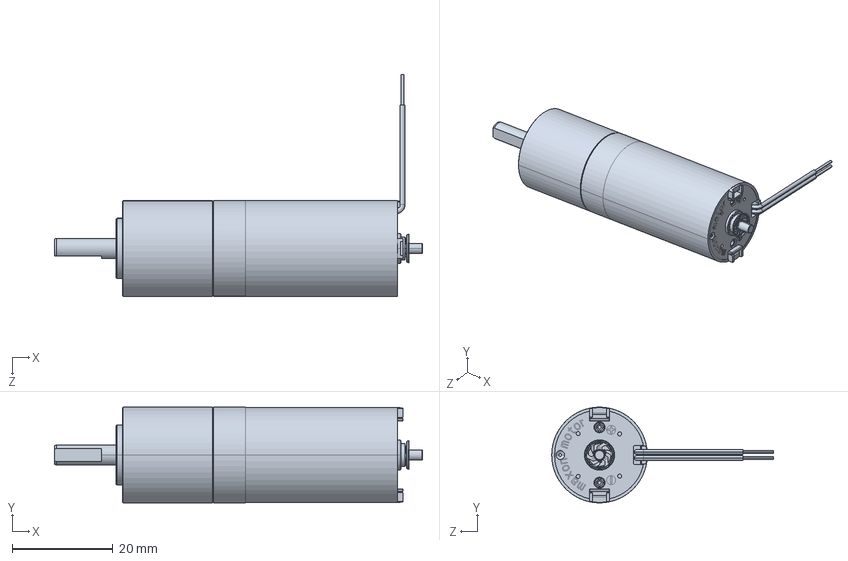
[picture p61: CAD file, 2026-05-15]
Mechanical/V2/Maxon.SLDPRT
73.0 x 19.0 x 44.0 mm
