chaBotsMX/chaBots-RCJ-IR-2026/Mechanical/V2/PhotodiodeFilter16-large.SLDPRT

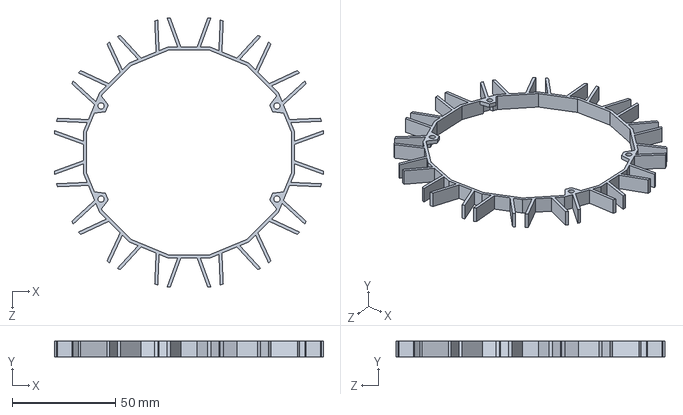
[picture p62: CAD file, 2026-05-15]
Mechanical/V2/PhotodiodeFilter16-large.SLDPRT
130.0 x 7.50 x 130.0 mm
