chaBotsMX/chaBots-RCJ-IR-2026/Mechanical/V2/Mario.SLDPRT

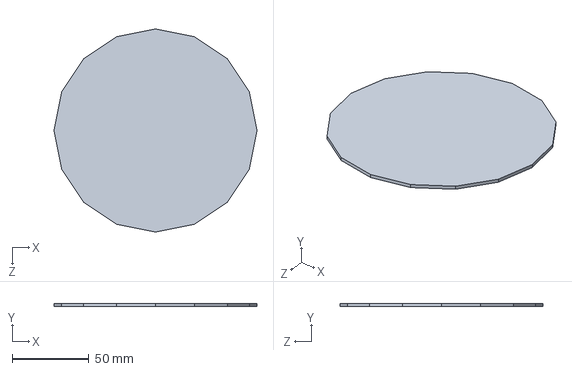
[picture p63: CAD file, 2026-05-15]
Mechanical/V2/Mario.SLDPRT
132.5 x 2.00 x 132.5 mm
