chaBotsMX/chaBots-RCJ-IR-2026/Mechanical/V2/LineSensor32.SLDPRT

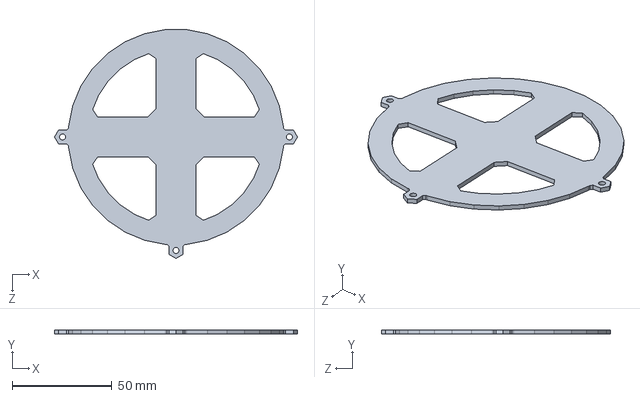
[picture p64: CAD file, 2026-05-15]
Mechanical/V2/LineSensor32.SLDPRT
121.6 x 2.00 x 114.5 mm
