chaBotsMX/chaBots-RCJ-IR-2026/Mechanical/Wheel/45mm Wheel.SLDASM

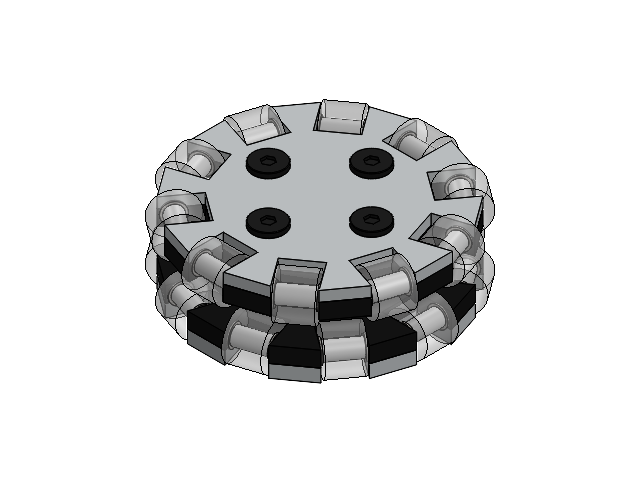
[picture p65: CAD file, 2026-05-15]
Mechanical/Wheel/45mm Wheel.SLDASM
Wheel-10-Front
Wheel-10-Back
Wheel-10-Back-Back
Wheel-10-Back-Back-Back
ShaftCoupling
DowelPin9mm-1.5mm
Sleeve x 20
SiliconeRoller8mm x 20
Washer4mm-1.6mm x 40
Tornillo-8-M3 x 4
