chaBotsMX/chaBots-RCJ-IR-2026/Mechanical/V2/top-tower.SLDASM

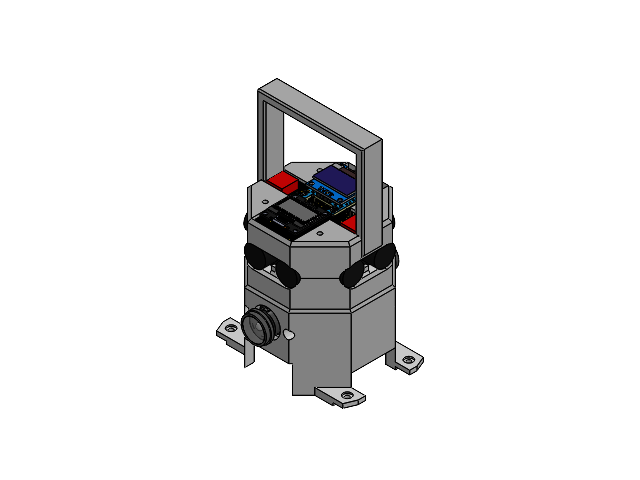
[picture p66: CAD file, 2026-05-15]
Mechanical/V2/top-tower.SLDASM
tower-top
UltraSonicPCB
URM09 x 4
Standoff25mmM3 x 4
towerbottom
OpenMV-WideLens x 2
