chaBotsMX/chaBots-RCJ-IR-2026/(list of files, cad)

Other CAD files:
Mechanical/Wheel/Wheel-10-Back.SLDPRT
Mechanical/V2/kicker-bracket-alt.SLDPRT
Electrical/LineSensor32/PCB2-EDM/5PIN_5PIN.x_t
Electrical/LineSensor32/PCB2-EDM/6PIN-SMD_6PIN-SMD.x_t
Electrical/LineSensor32/PCB2-EDM/ALS-PT19_ALS-PT19.x_t
Electrical/LineSensor32/PCB2-EDM/CAP_0603_CAP_0603.x_t
Electrical/LineSensor32/PCB2-EDM/LED1515_LED1515.x_t
Electrical/LineSensor32/PCB2-EDM/LMV331_LMV331.x_t
Electrical/LineSensor32/PCB2-EDM/RES_0603_RES_0603.x_t
Electrical/LineSensor32/PCB2-EDM/TEENSY-4.1-TH_Teensy-4.1-TH.x_t
Electrical/Main-2026/PCB2-EDM/BOUR-TC33X-2_V_CMP-2100-03695-1.x_t
Electrical/Main-2026/PCB2-EDM/CAP_0603_CAP_0603.x_t
Electrical/Main-2026/PCB2-EDM/DRV8432_DRV8432.x_t
Electrical/Main-2026/PCB2-EDM/EG1218_EG1218.x_t
Electrical/Main-2026/PCB2-EDM/FP-95400-MFG_CMP-02539-000035-1.x_t
Electrical/Main-2026/PCB2-EDM/FP-FTF-MFG_CMP-05427-000040-1.x_t
Electrical/Main-2026/PCB2-EDM/FP-HDG-MFG_CMP-00287-42869300-1.x_t
Electrical/Main-2026/PCB2-EDM/FP-TGG-MFG_CMP-05427-002169-1.x_t
Electrical/Main-2026/PCB2-EDM/IDC-6PIN-SMT-2.54_IDC-6PIN-SMT-2.54_1.x_t
Electrical/Main-2026/PCB2-EDM/IND_BOOST_Boost_Inductor.x_t
Electrical/Main-2026/PCB2-EDM/KTT0005B_N_CMP-0069-00069-3.x_t
Electrical/Main-2026/PCB2-EDM/LED_0603_LED_0603.x_t
Electrical/Main-2026/PCB2-EDM/RES_0603_RES_0603.x_t
Electrical/Main-2026/PCB2-EDM/SLIDE_SWITCH_6A.x_t
Electrical/Main-2026/PCB2-EDM/SQ4470EY-T1_GE3_SQ4470EY-T1_GE3.x_t
Electrical/Main-2026/PCB2-EDM/TEENSY-4.1_Teensy-4.1.x_t
Electrical/Main-2026/PCB2-EDM/XT30_PW_M_XT30_PW_M.x_t
Electrical/Main-2026/PCB2-EDM/XT60PW.x_t
Mechanical/Dribbler/dribbler.SLDPRT
Mechanical/V1/2040.SLDPRT
Mechanical/V1/3sLipo-1AH.SLDPRT
Mechanical/V1/BNO085-PINS.SLDPRT
Mechanical/V1/BallSensor-Filter-16.SLDPRT
Mechanical/V1/BallSensor-PCB-16.SLDPRT
Mechanical/V1/ChasisV1-16.SLDPRT
Mechanical/V1/Dribbler.SLDASM
Mechanical/V1/Light-Diffuser-16.SLDPRT
Mechanical/V1/LightArray.SLDPRT
Mechanical/V1/LineSensor32-Board.SLDPRT
Mechanical/V1/LineSensor32.SLDPRT
Mechanical/V1/LineSensorConector.SLDPRT
Mechanical/V1/LineSensorSide.SLDPRT
Mechanical/V1/Maxon.SLDPRT
Mechanical/V1/OpenMV-WideLens.SLDPRT
Mechanical/V1/PhotodiodeFilter16.SLDPRT
Mechanical/V1/Standoff25mmM3.SLDPRT
Mechanical/V1/Standoff30mmM3.SLDPRT
Mechanical/V1/Standoff40mmM3.SLDPRT
Mechanical/V1/Standoff45mmM3.SLDPRT
Mechanical/V1/URM09.SLDPRT
Mechanical/V1/USB-holder.SLDPRT
Mechanical/V1/UltraSonicPCB.SLDPRT
Mechanical/V1/UltraSonicPCB_BOARD.SLDPRT
Mechanical/V1/capacitor.SLDPRT
Mechanical/V1/dribbler-rod.SLDPRT
Mechanical/V1/dribbler.SLDPRT
Mechanical/V1/gear-big.SLDPRT
Mechanical/V1/gear-small.SLDPRT
Mechanical/V1/gear-template.SLDPRT
Mechanical/V1/pcb-line-teensy.SLDPRT
Mechanical/V1/pcb-main-placeholder.SLDPRT
Mechanical/V1/pcbtop.SLDPRT
Mechanical/V1/step_w_cb1037.SLDPRT
Mechanical/V1/top PCB.SLDPRT
Mechanical/V1/top-tower.SLDASM
Mechanical/V1/tower-16.SLDPRT
Mechanical/V1/tower-short.SLDPRT
Mechanical/V1/tower-top.SLDPRT
Mechanical/V1/tower.SLDPRT
Mechanical/V1/towerbottom.SLDPRT
Mechanical/V1/ultrasonic-holder.SLDPRT
Mechanical/V1/wheel-guard.SLDPRT
Mechanical/V1/wheel-new.SLDPRT
Mechanical/Wheel/45mm Wheel.SLDPRT
Mechanical/Wheel/Washer4mm-1.6mm.SLDPRT
Mechanical/Wheel/Wheel-10-Back-Back-Back.STL
Mechanical/Wheel/Wheel-10-Back-Back.STL
Mechanical/Wheel/Wheel-10-Back.STL
Mechanical/Wheel/Wheel-10-Front.STL
