chaBotsMX/chaBots-RCJ-IR-2026/Mechanical/Media/45mm Wheel.pdf

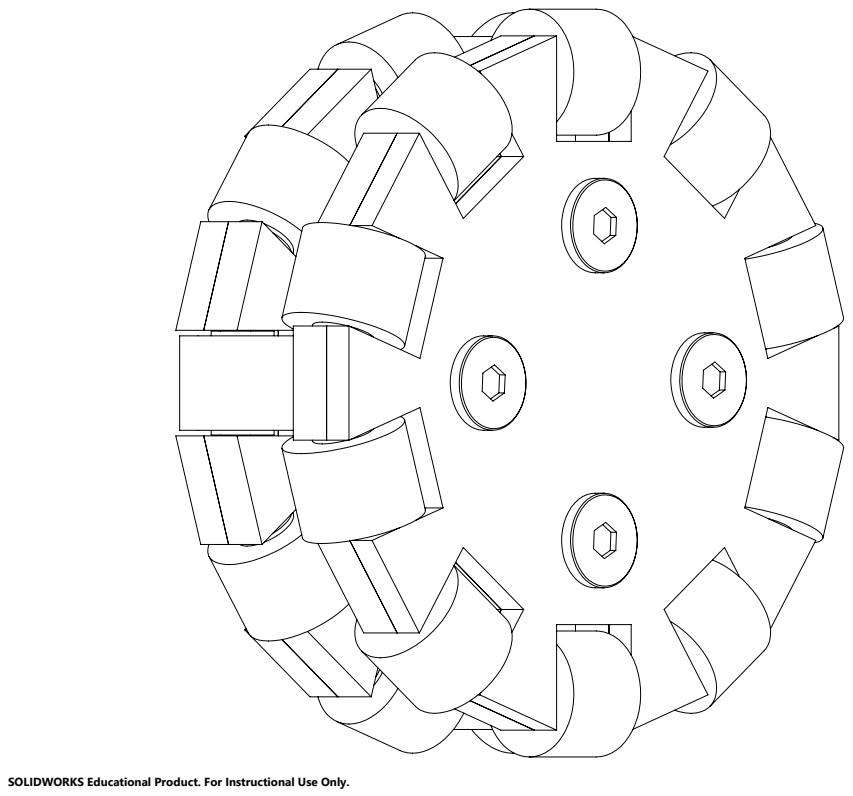
[picture p67: page 1]

SOLIDWORKS Educational Product. For Instructional Use Only.
