chaBotsMX/chaBots-RCJ-IR-2026/Mechanical/Media/Dribbler.pdf

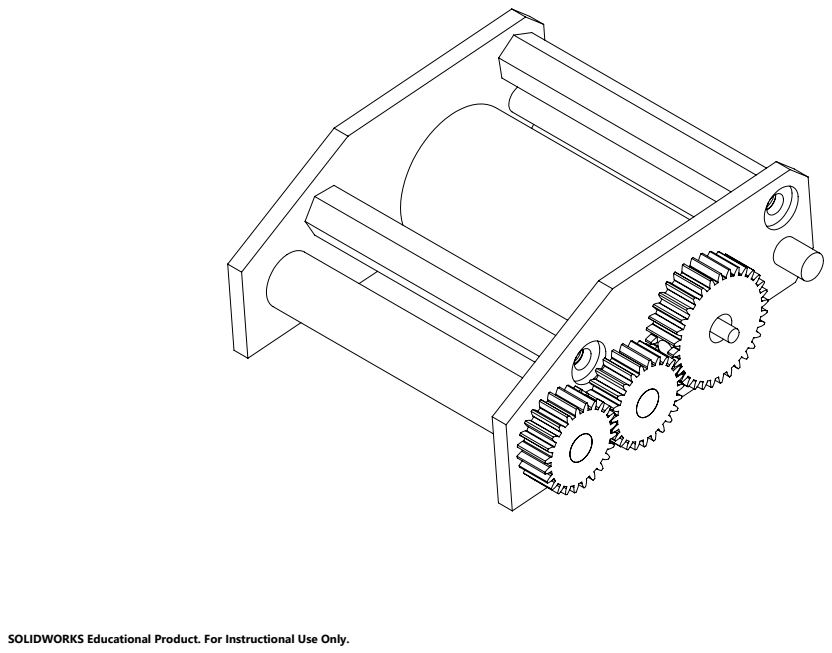
[picture p68: page 1]

SOLIDWORKS Educational Product. For Instructional Use Only.
