chaBotsMX/chaBots-RCJ-IR-2026/Mechanical/Media/GurtV2.PDF

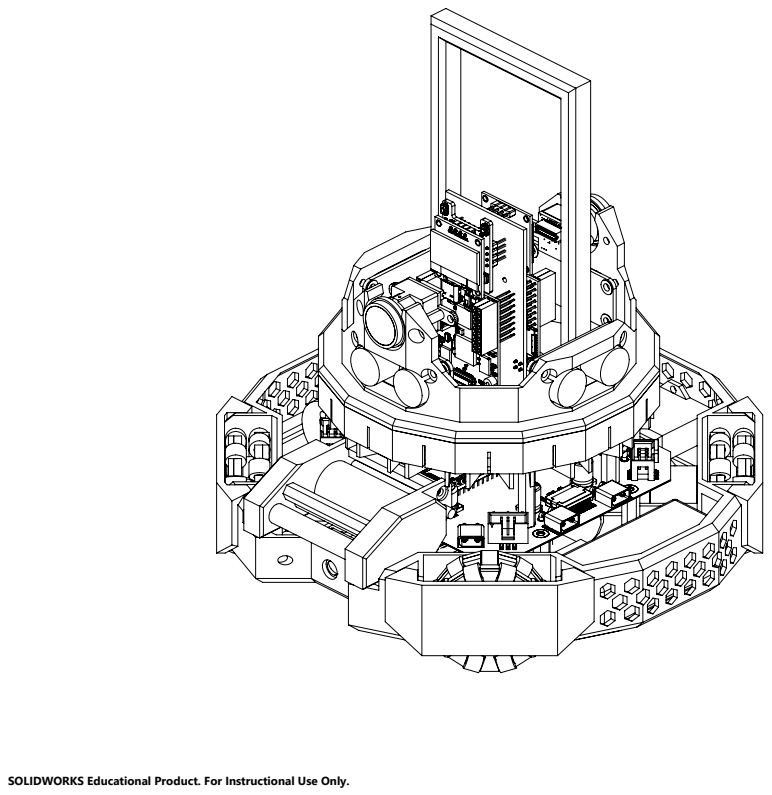
[picture p69: page 1]

SOLIDWORKS Educational Product. For Instructional Use Only.
