chaBotsMX/chaBots-RCJ-IR-2026/Electrical/Media/BallSensor16PCB.pdf

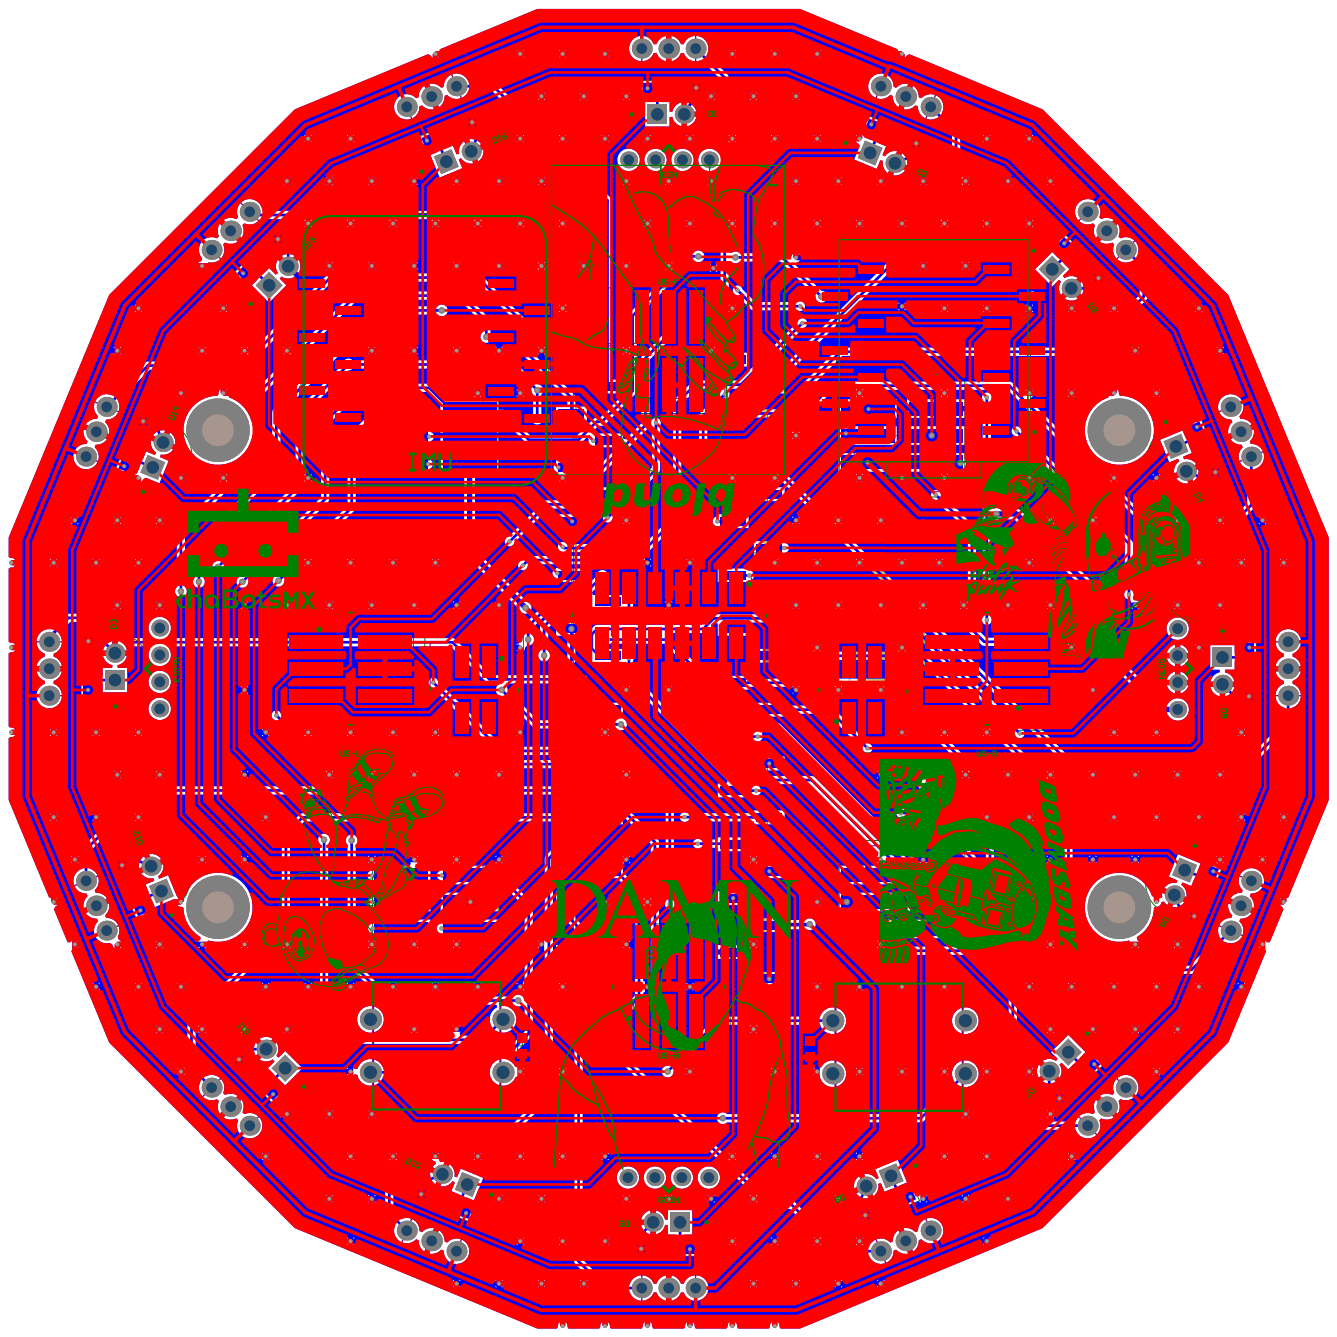
[picture p70: page 1]
