chaBotsMX/chaBots-RCJ-IR-2026/Electrical/Media/BallSensor16SCH.pdf

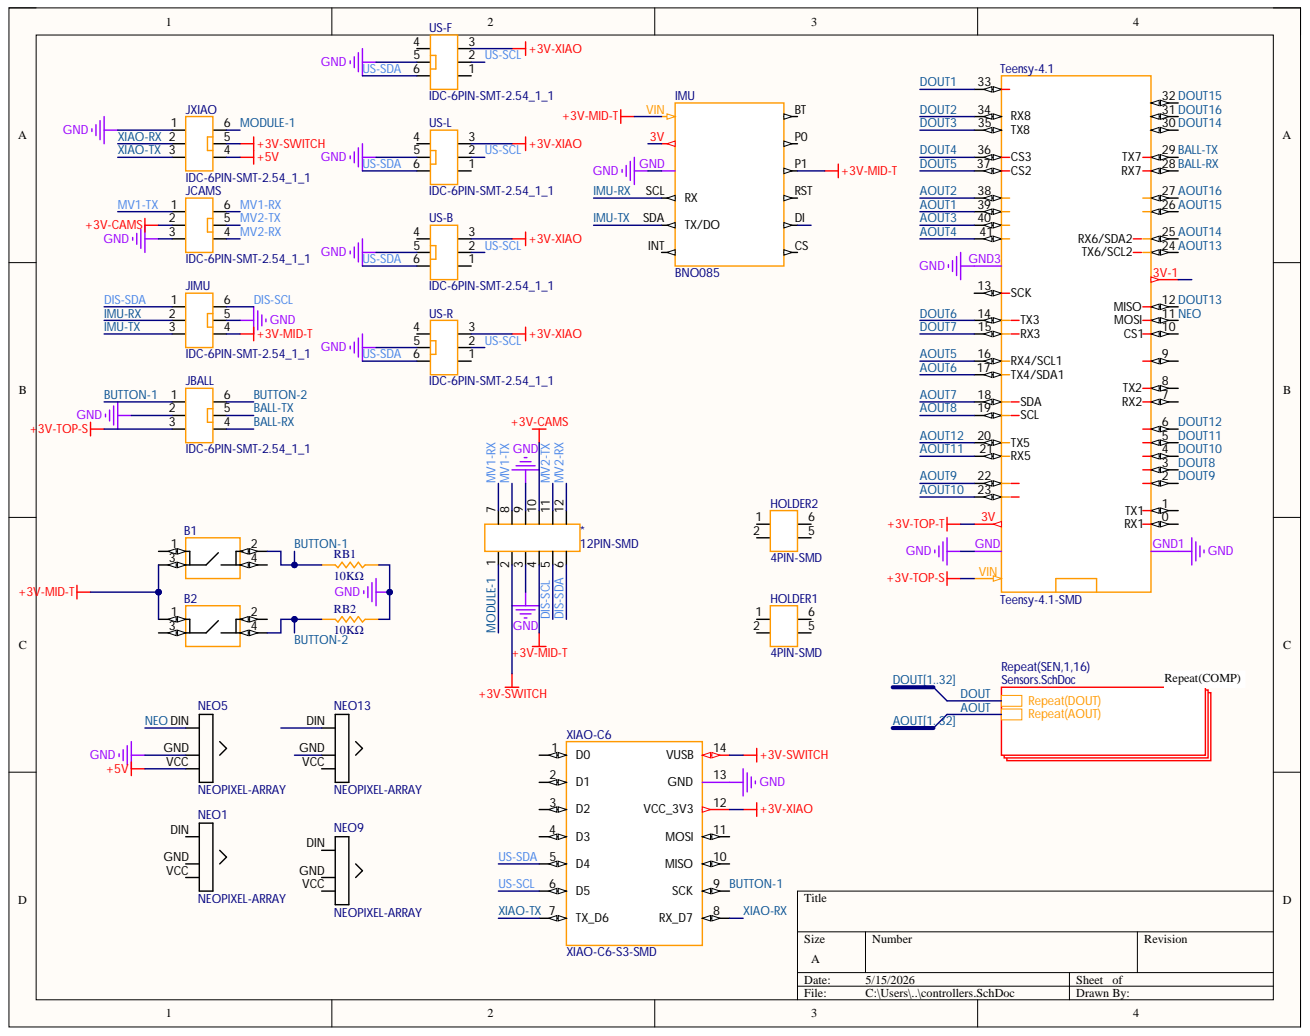
[picture p71: page 1]

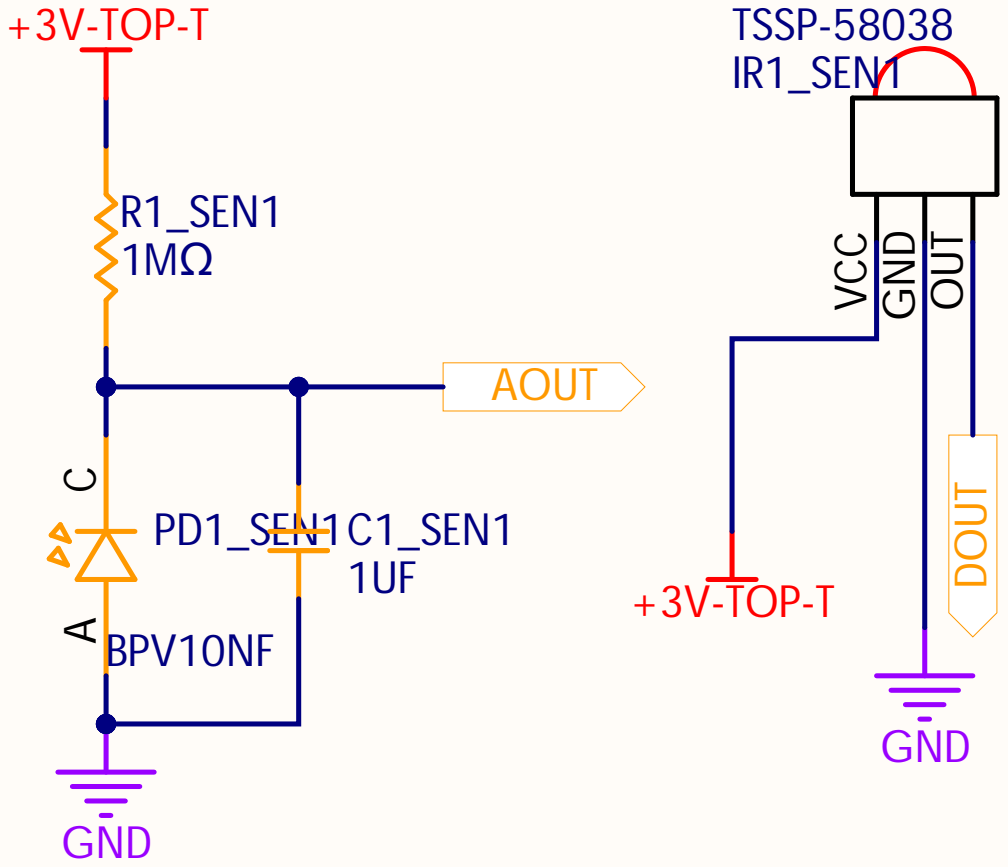
[picture p72: page 2]

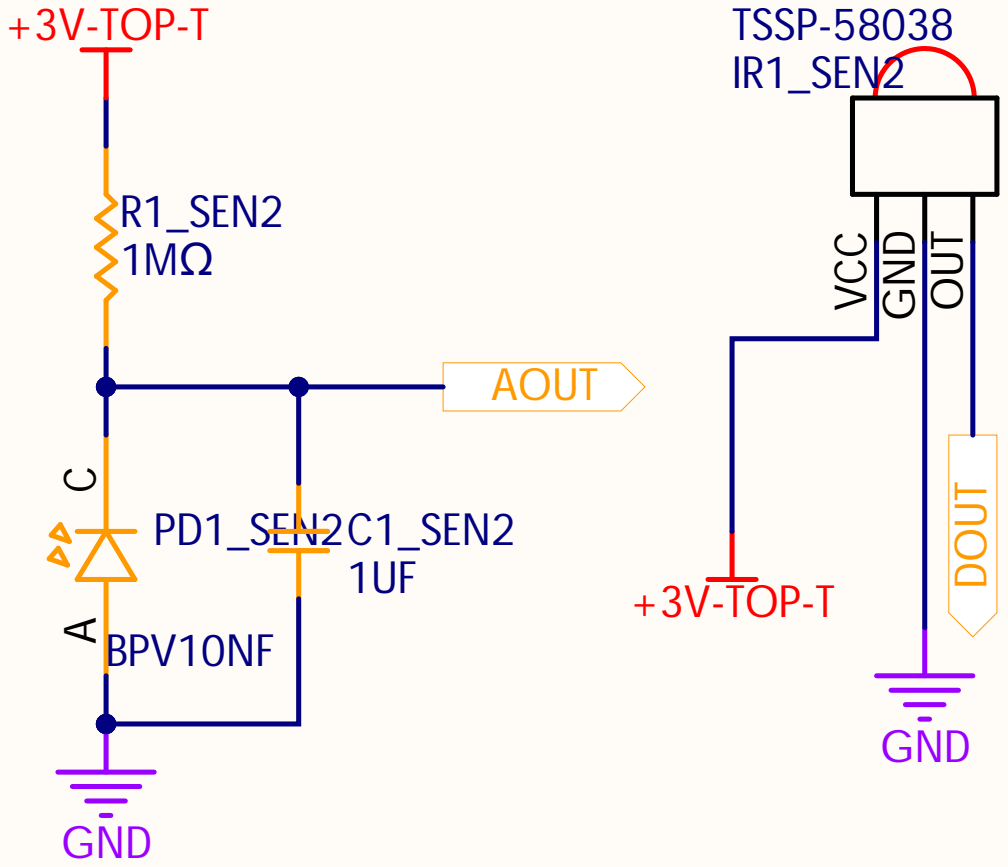
[picture p73: page 3]

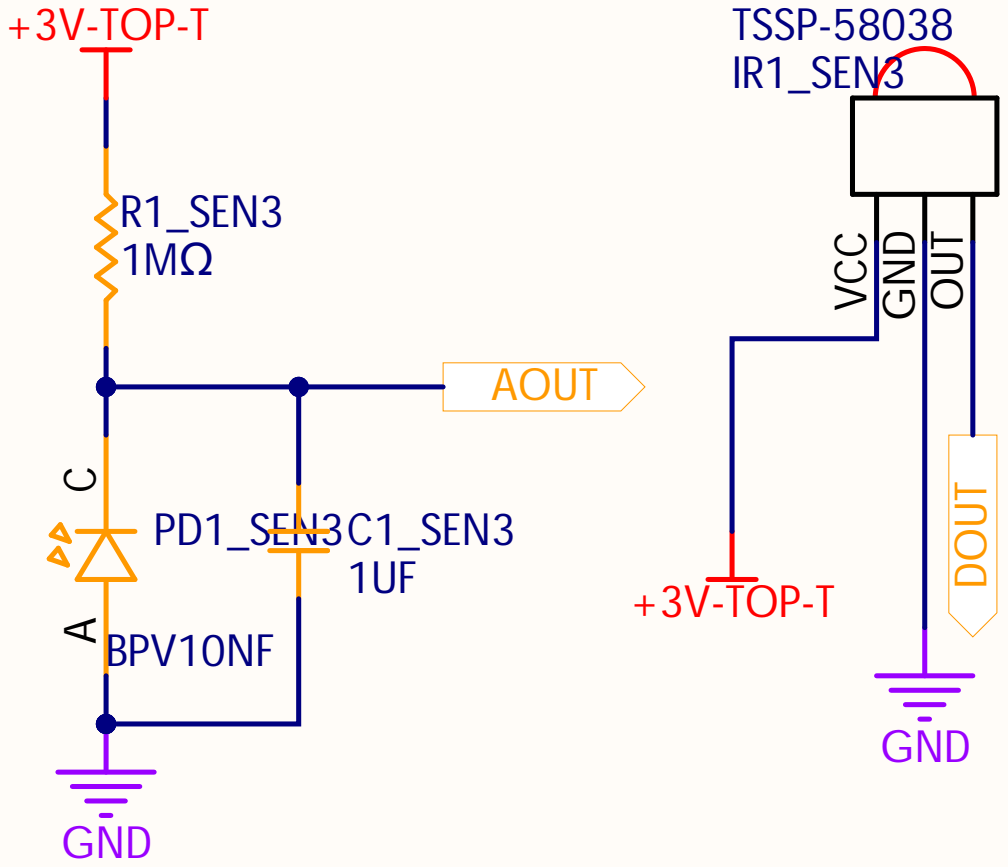
[picture p74: page 4]

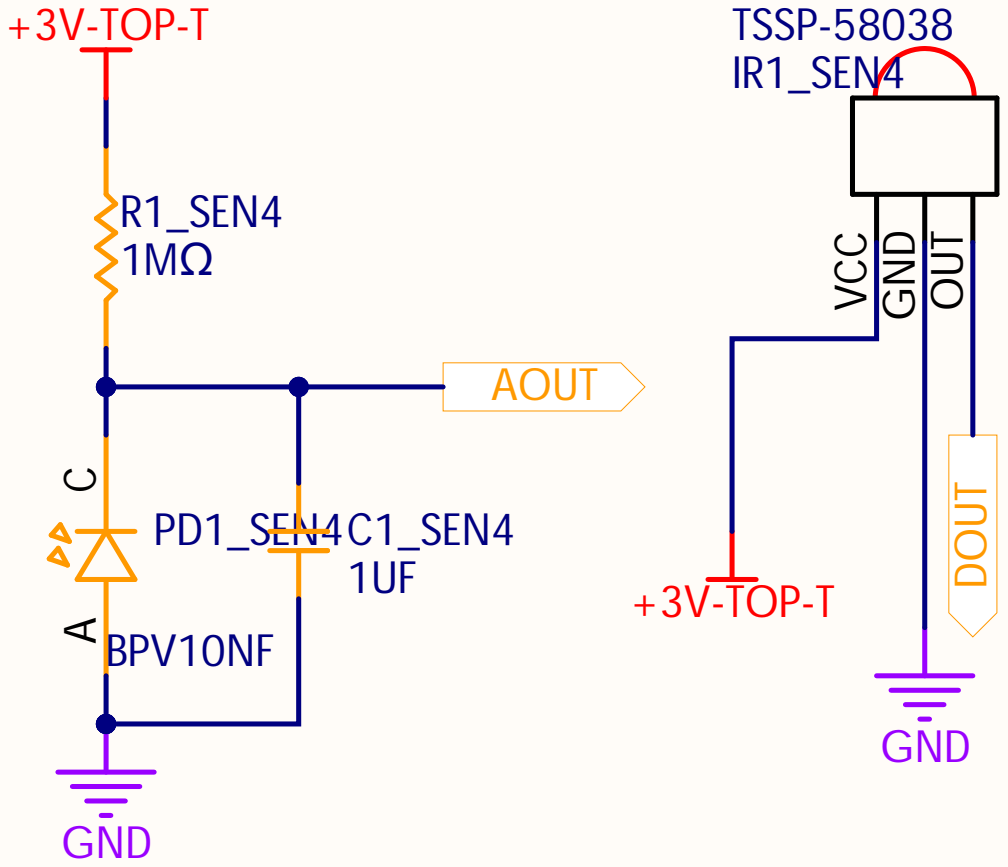
[picture p75: page 5]

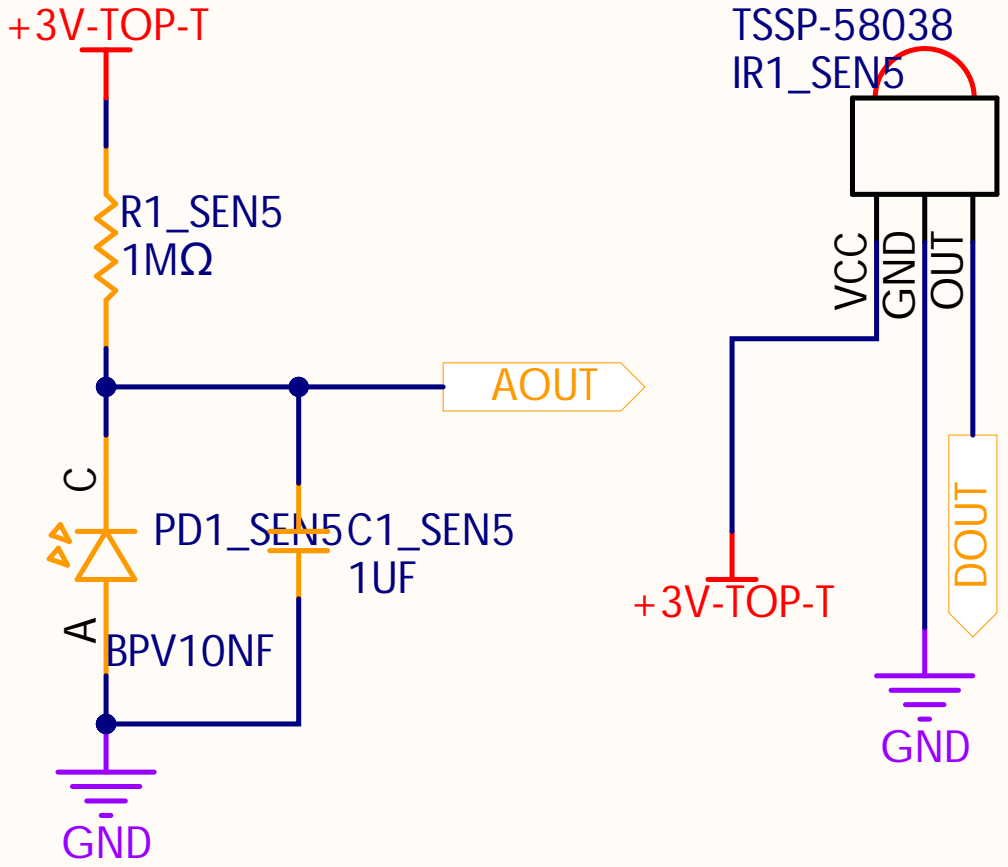
[picture p76: page 6]

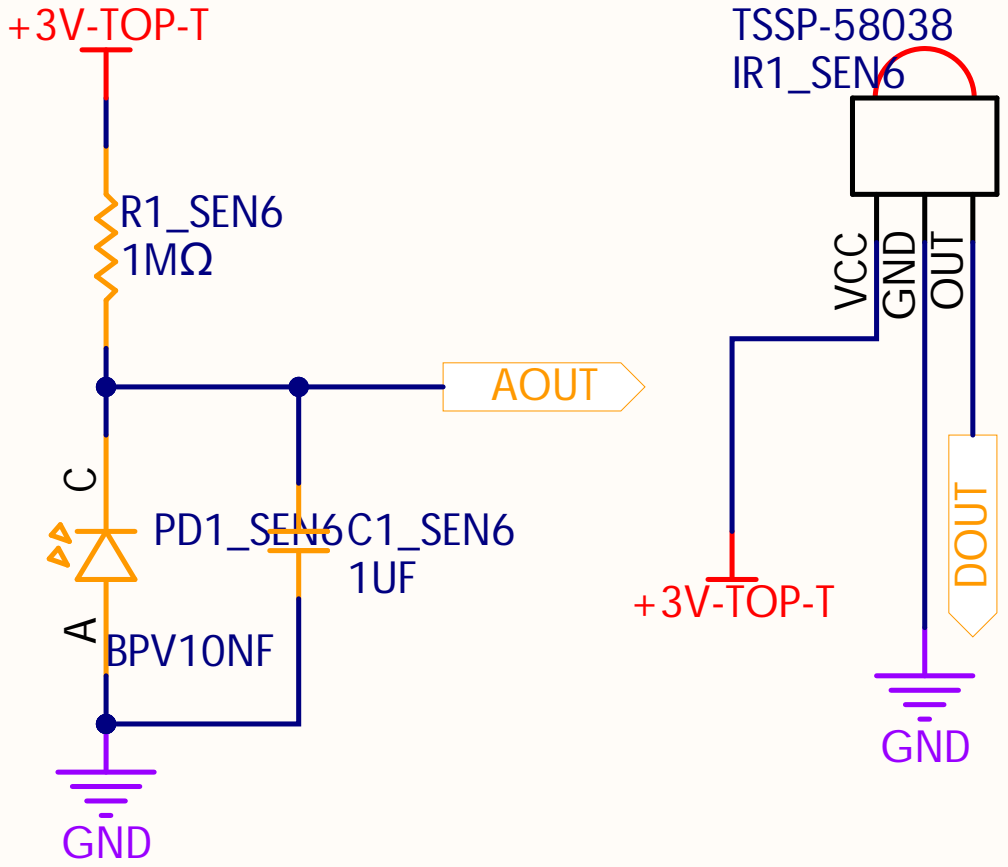
[picture p77: page 7]

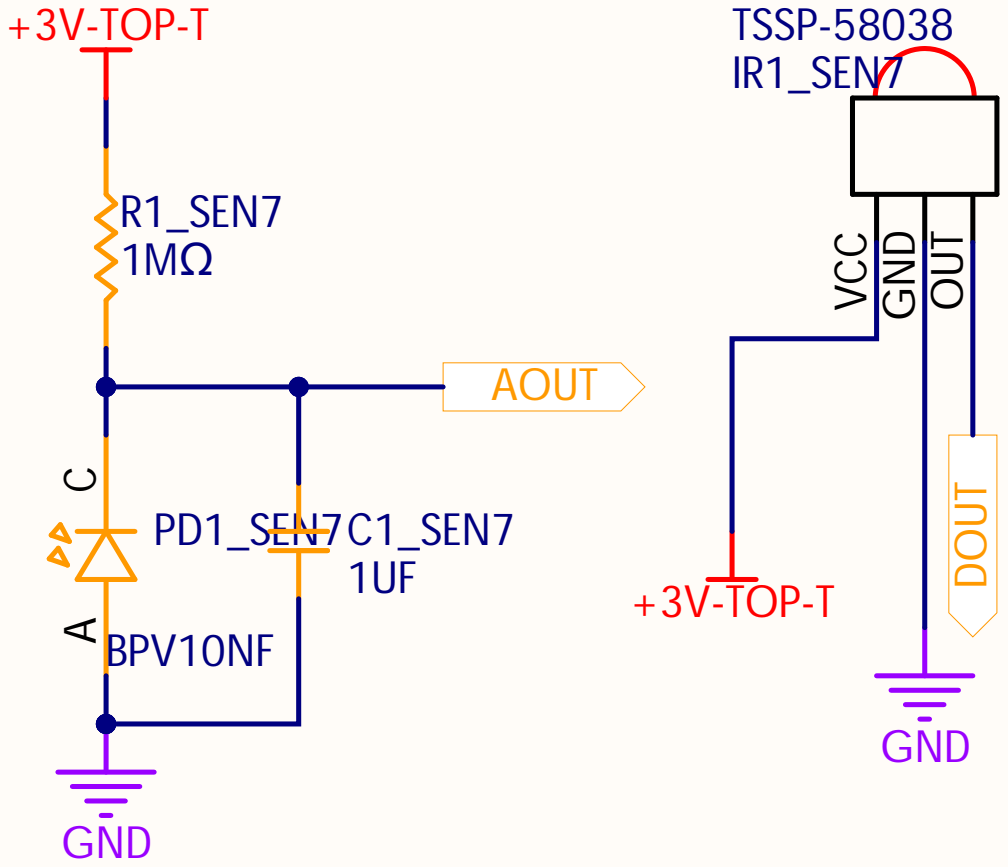
[picture p78: page 8]

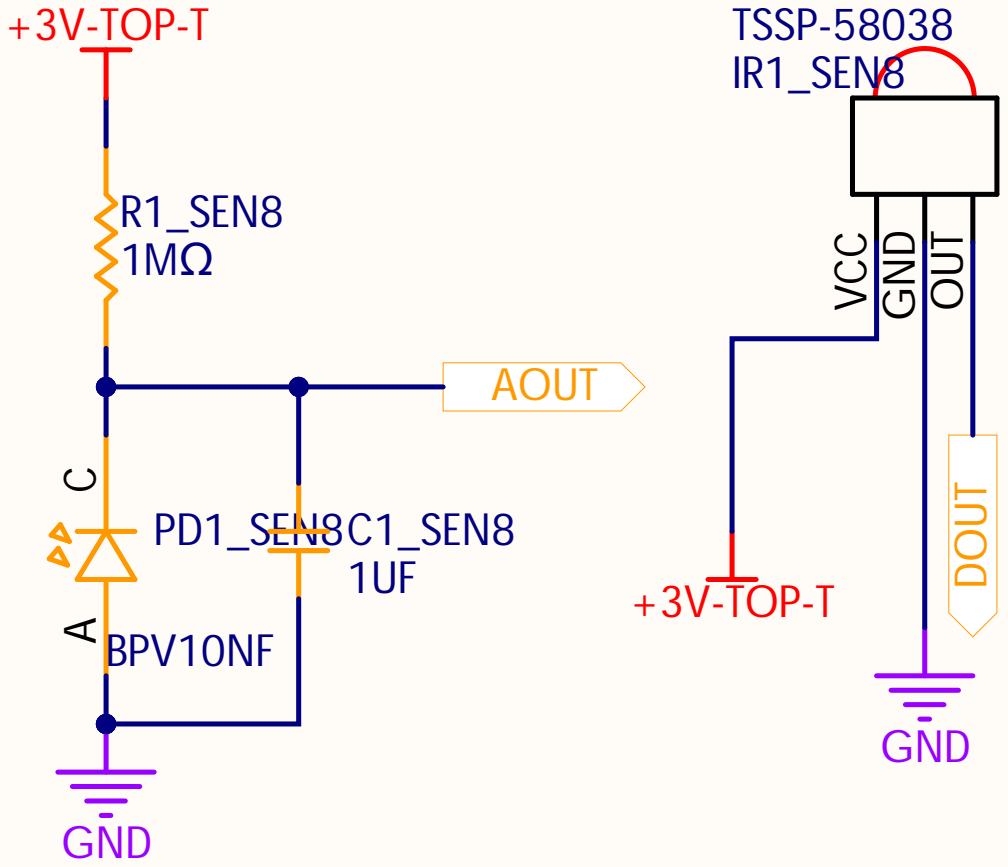
[picture p79: page 9]

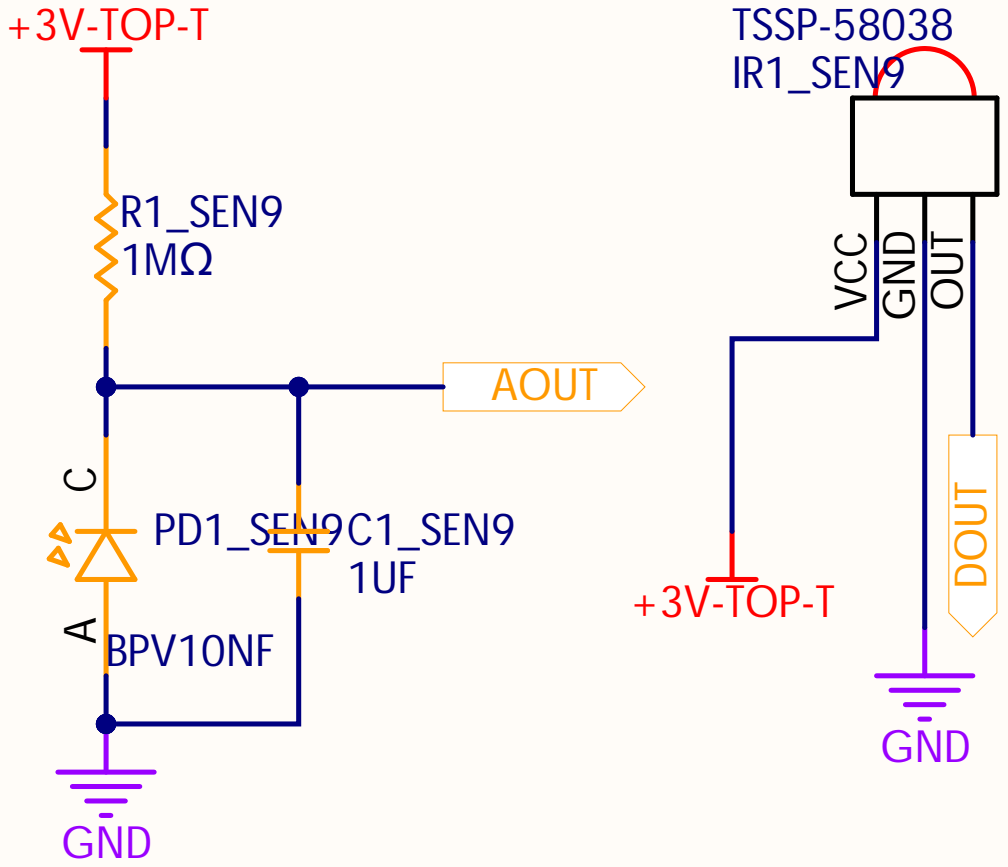
[picture p80: page 10]

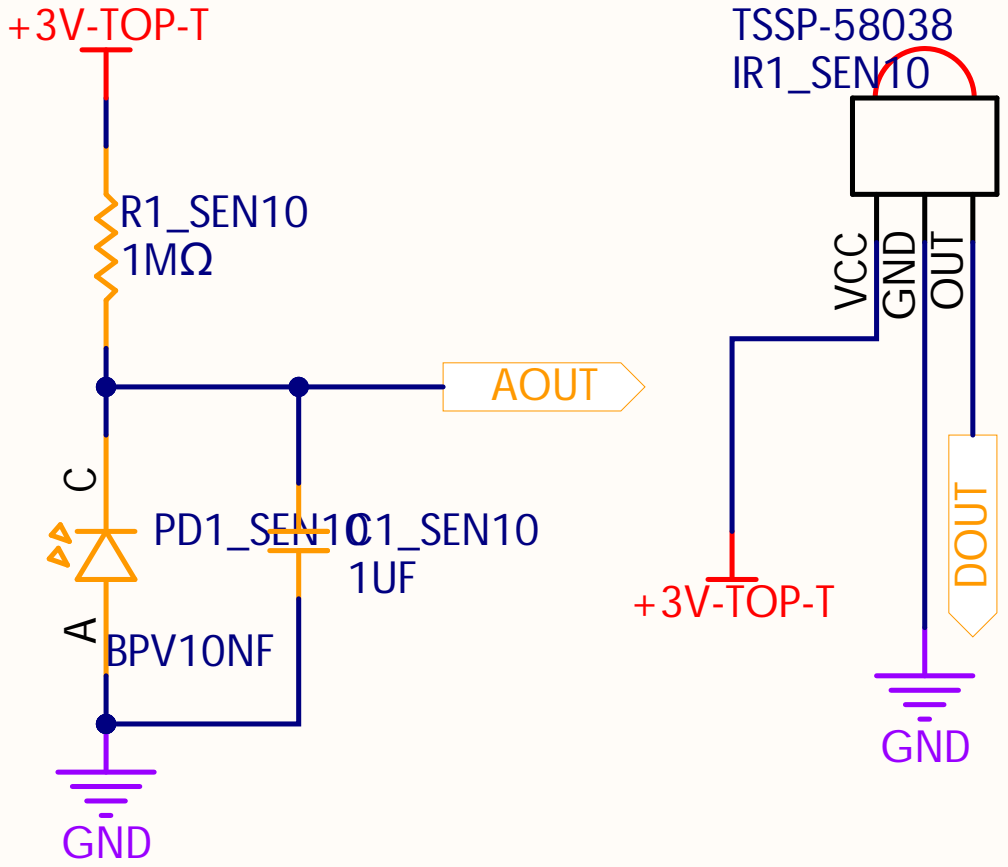
[picture p81: page 11]

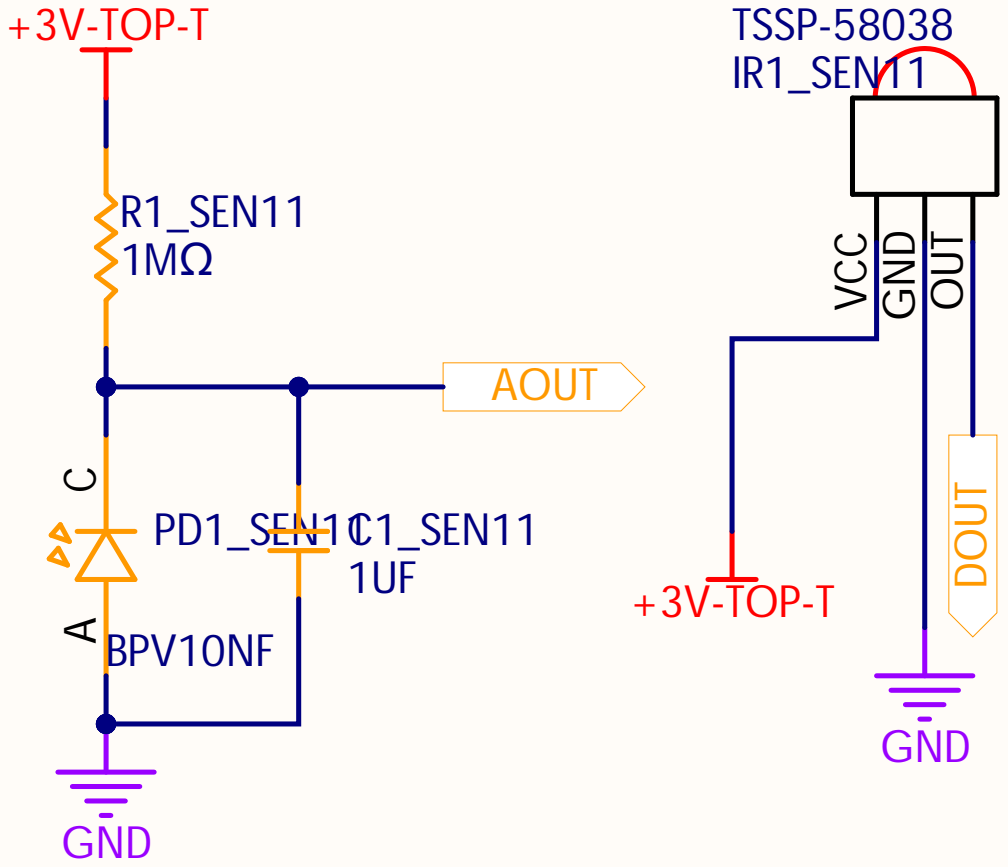
[picture p82: page 12]

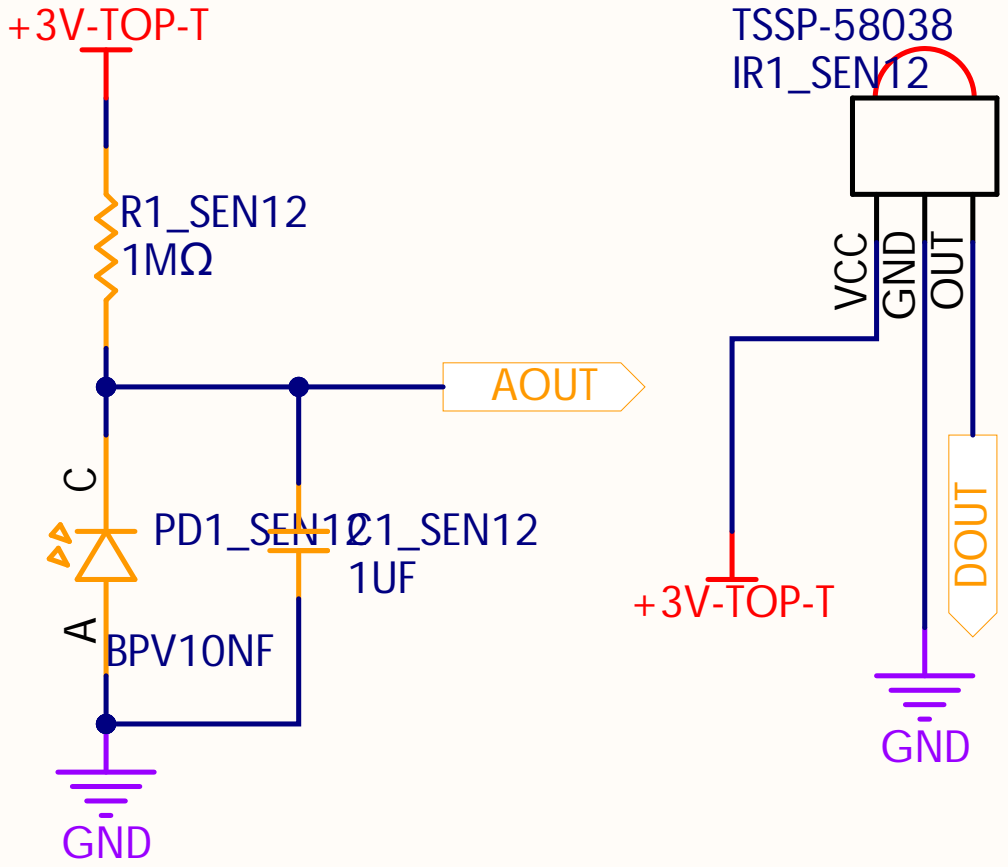
[picture p83: page 13]

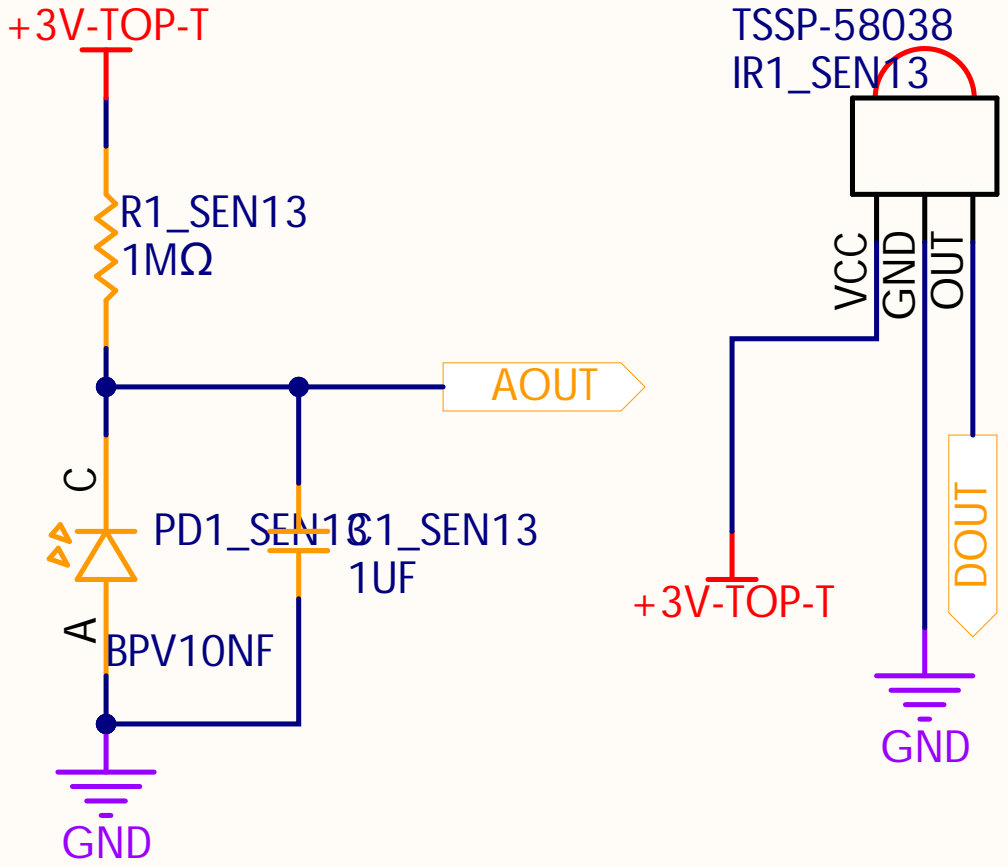
[picture p84: page 14]

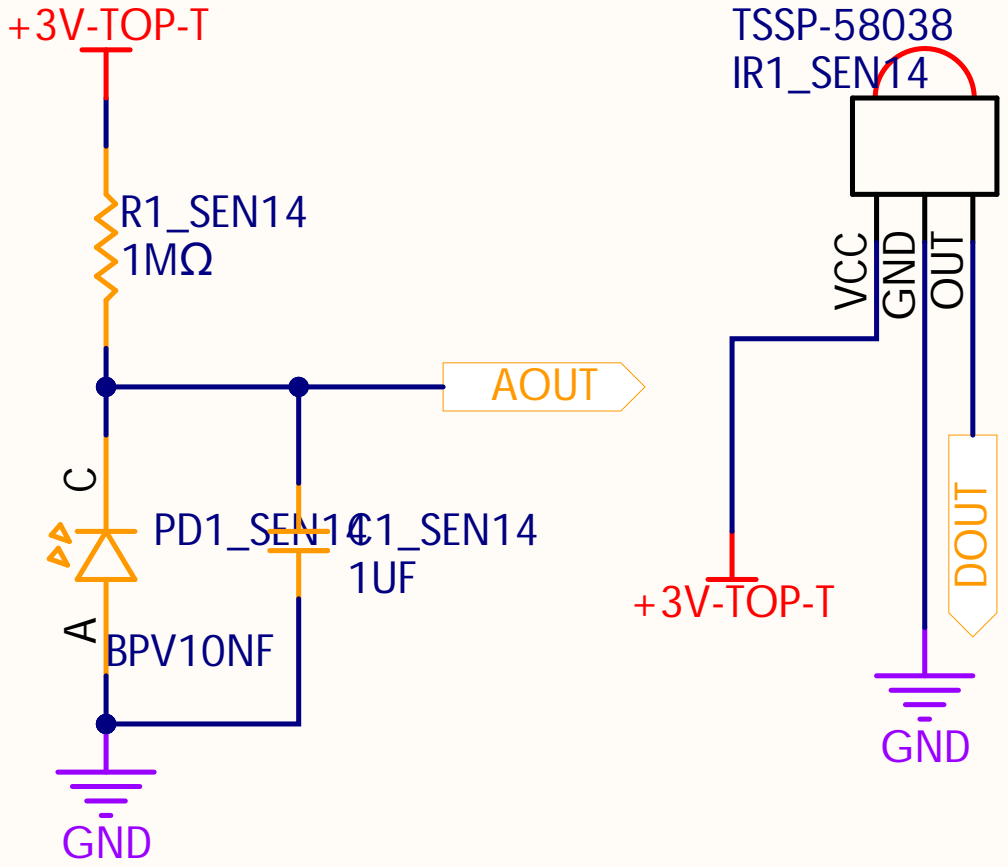
[picture p85: page 15]

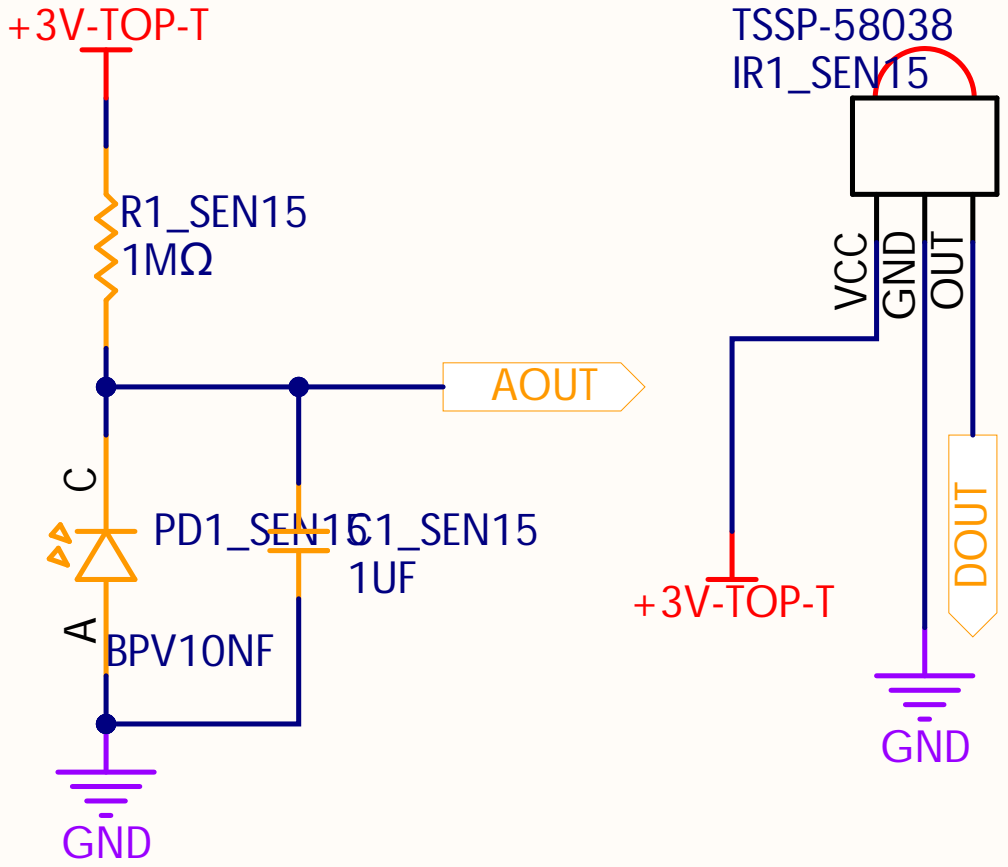
[picture p86: page 16]

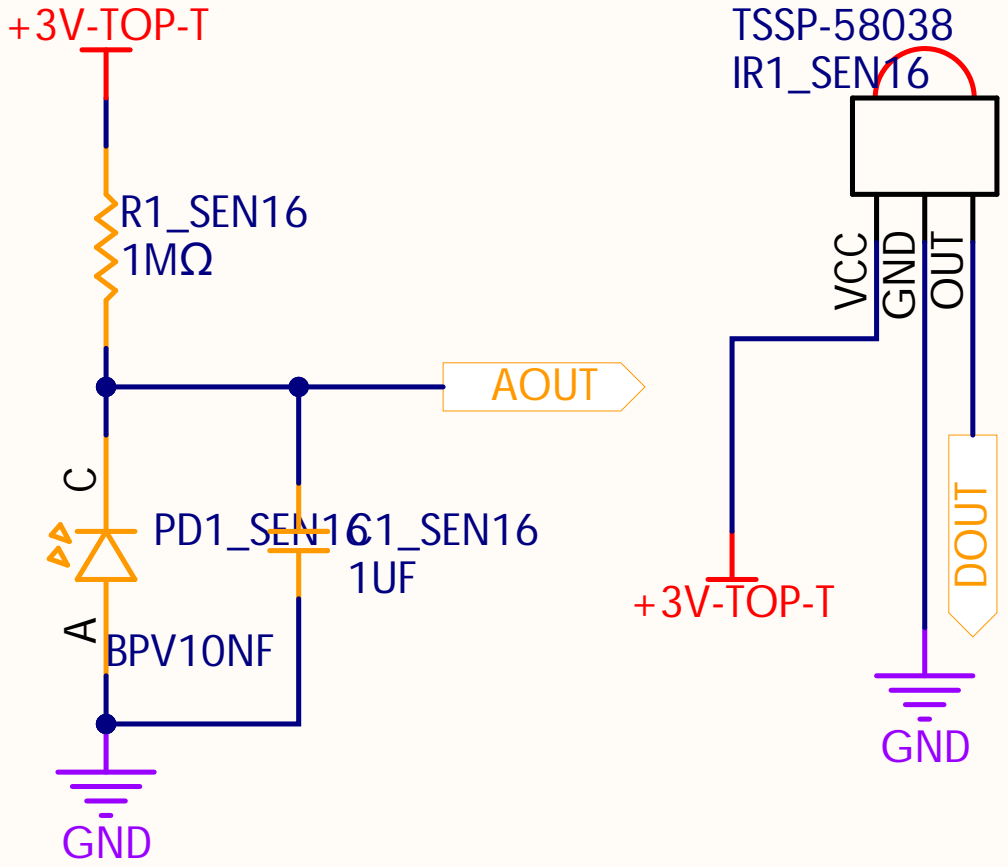
[picture p87: page 17]
