chaBotsMX/chaBots-RCJ-IR-2026/Electrical/Media/LightArray16PCB.pdf

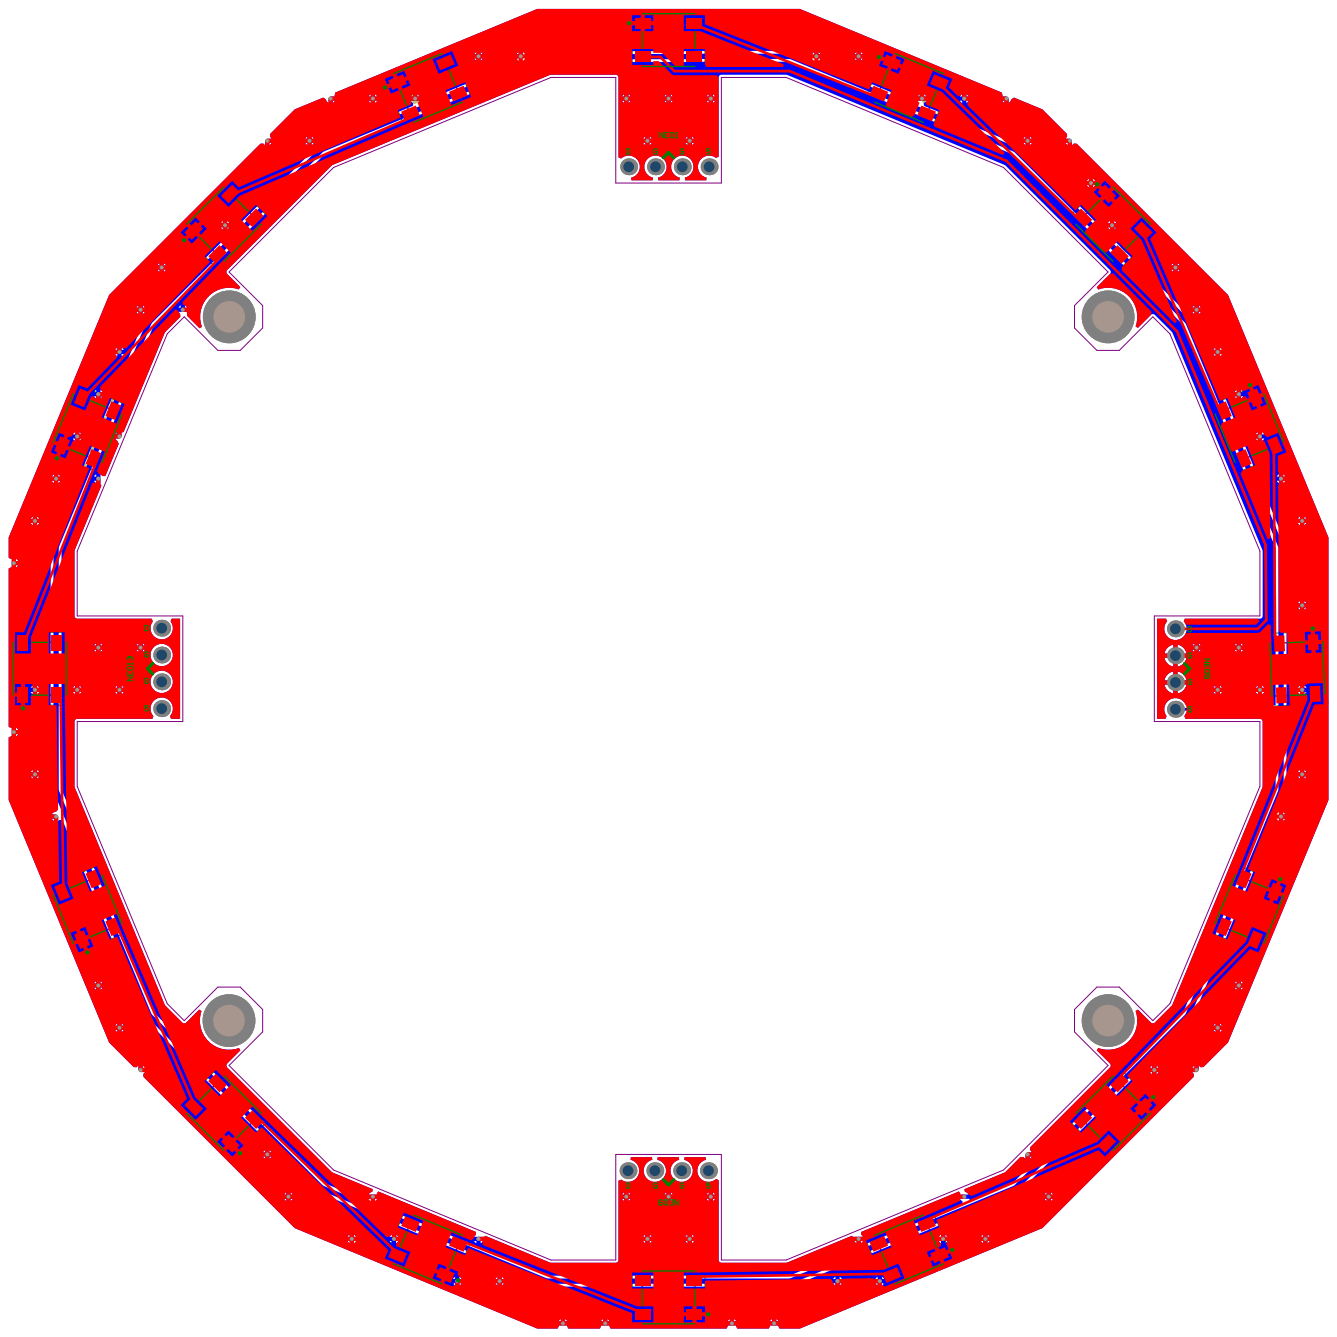
[picture p88: page 1]
