chaBotsMX/chaBots-RCJ-IR-2026/Electrical/Media/LightArray16SCH.pdf

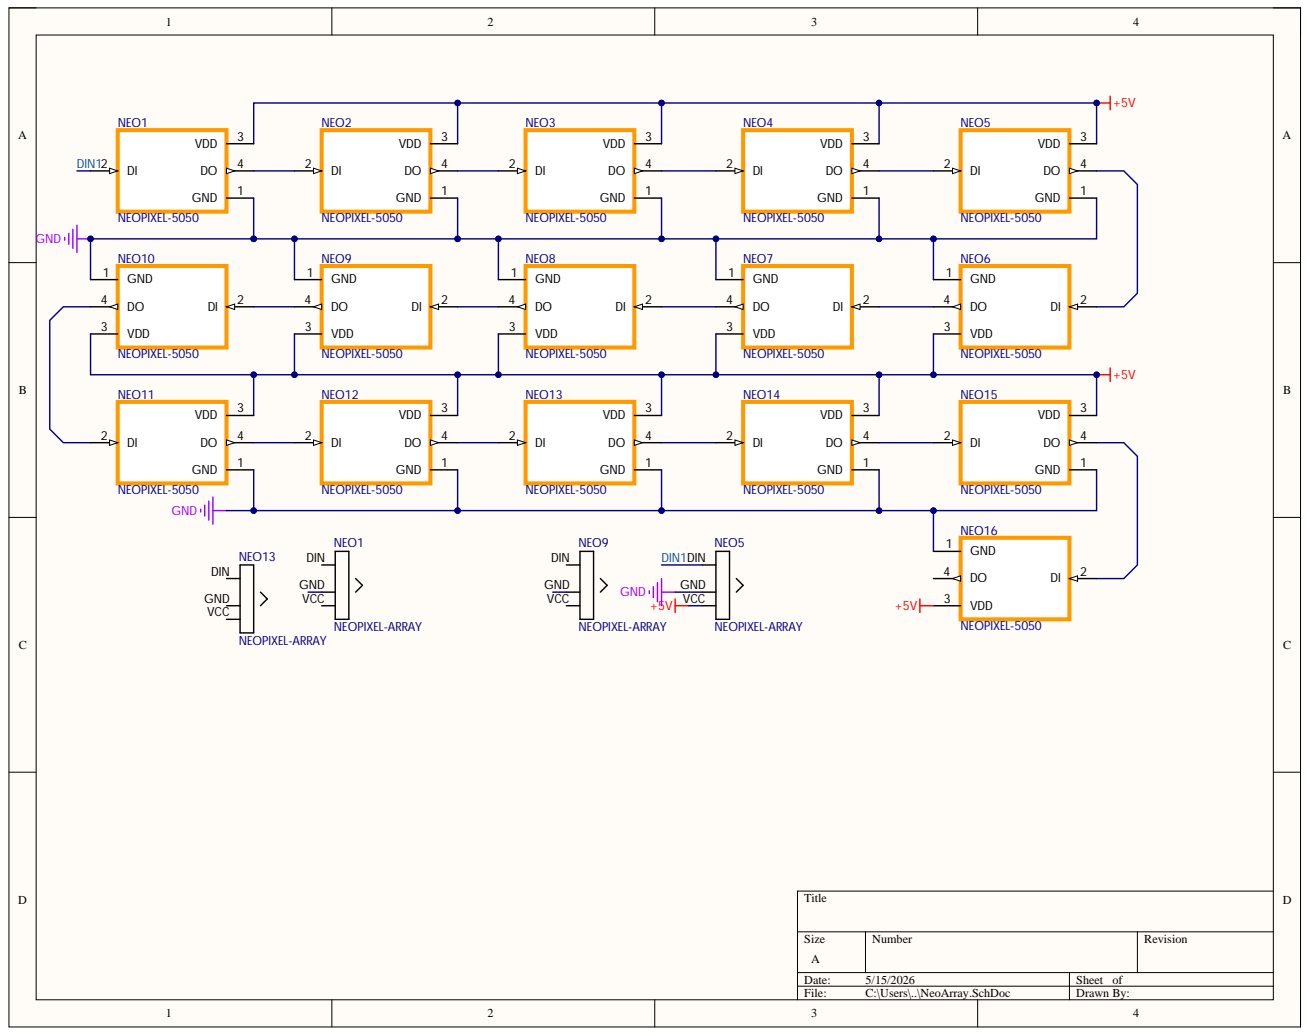
[picture p89: page 1]
