chaBotsMX/chaBots-RCJ-IR-2026/Electrical/Media/LightBarrierPCB.pdf

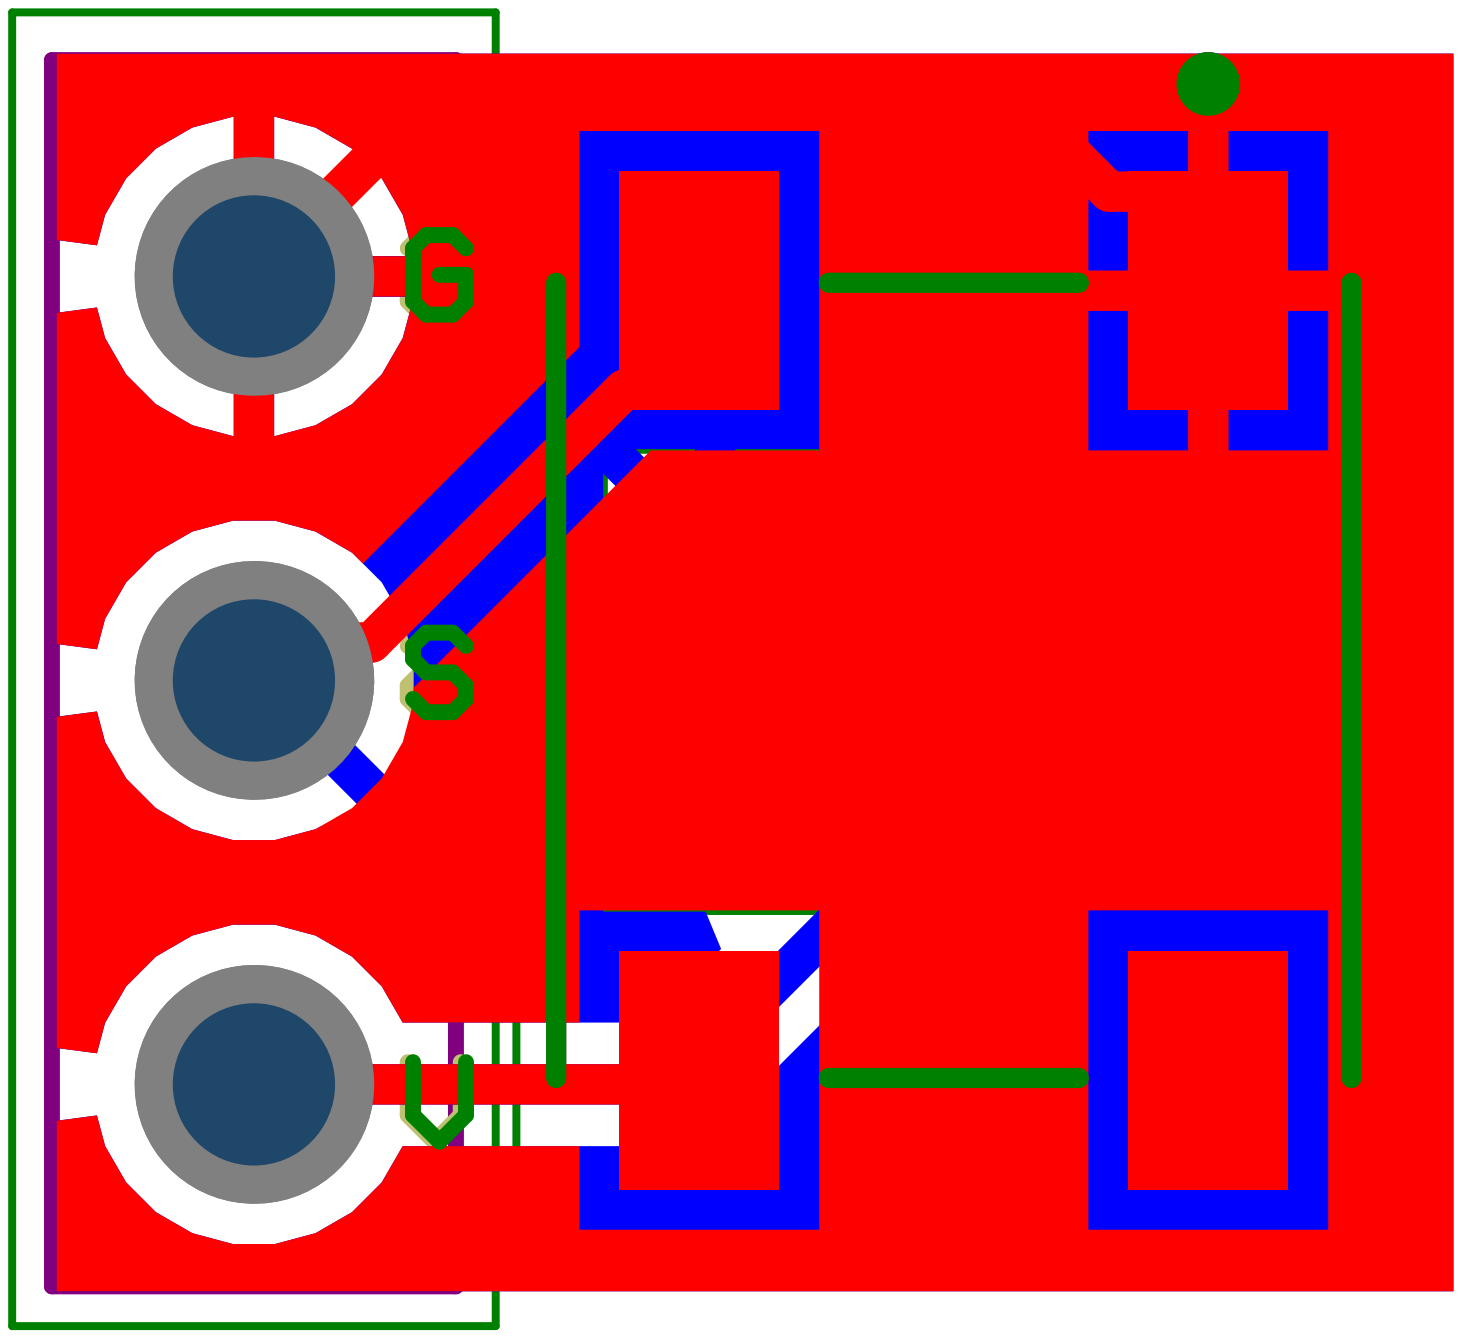
[picture p90: page 1]
