chaBotsMX/chaBots-RCJ-IR-2026/Electrical/Media/LightBarrierSCH.pdf

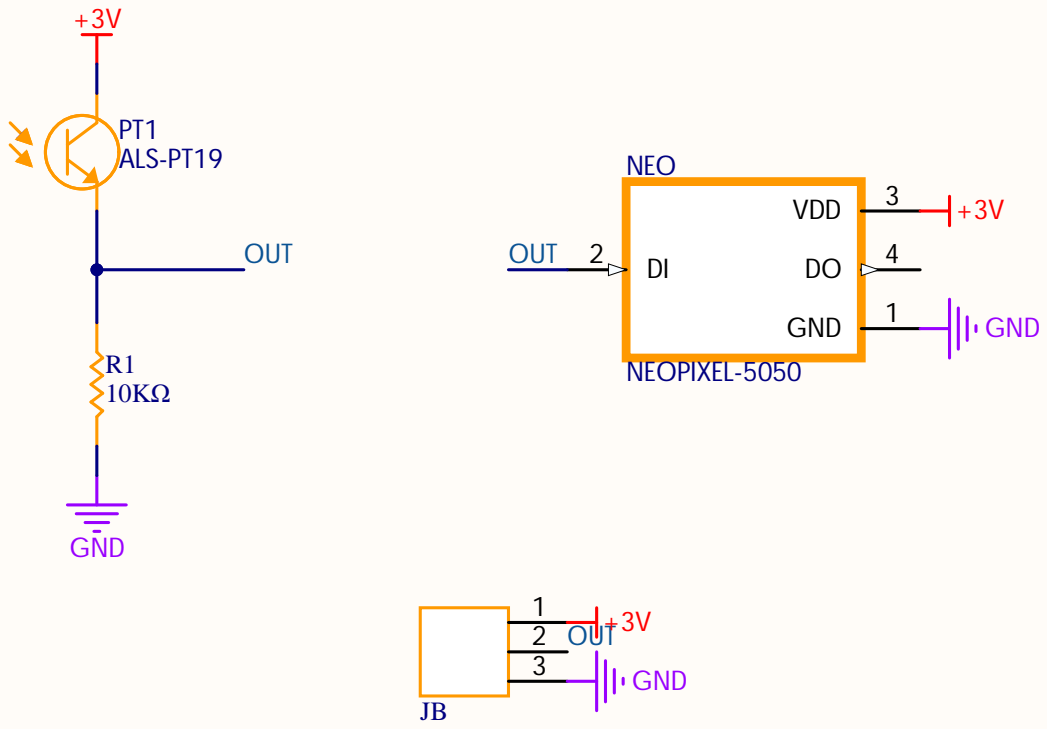
[picture p91: page 1]
