chaBotsMX/chaBots-RCJ-IR-2026/Electrical/Media/LineConectorPCB.pdf

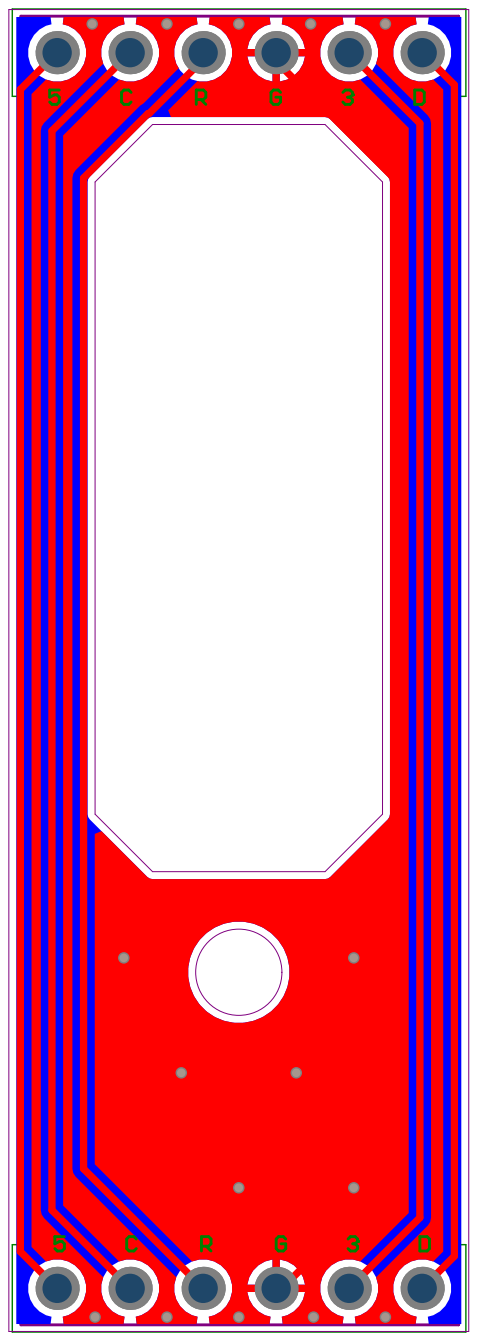
[picture p92: page 1]
