chaBotsMX/chaBots-RCJ-IR-2026/Electrical/Media/LineConectorSCH.pdf

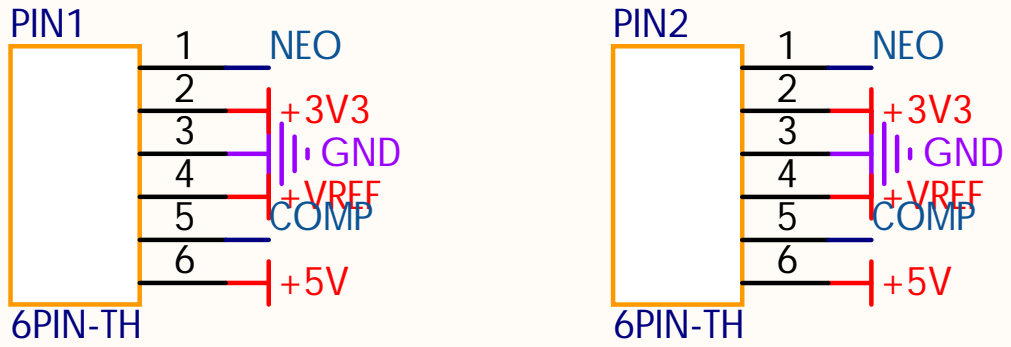
[picture p93: page 1]
