chaBotsMX/chaBots-RCJ-IR-2026/Electrical/Media/LineSensor32PCB.pdf

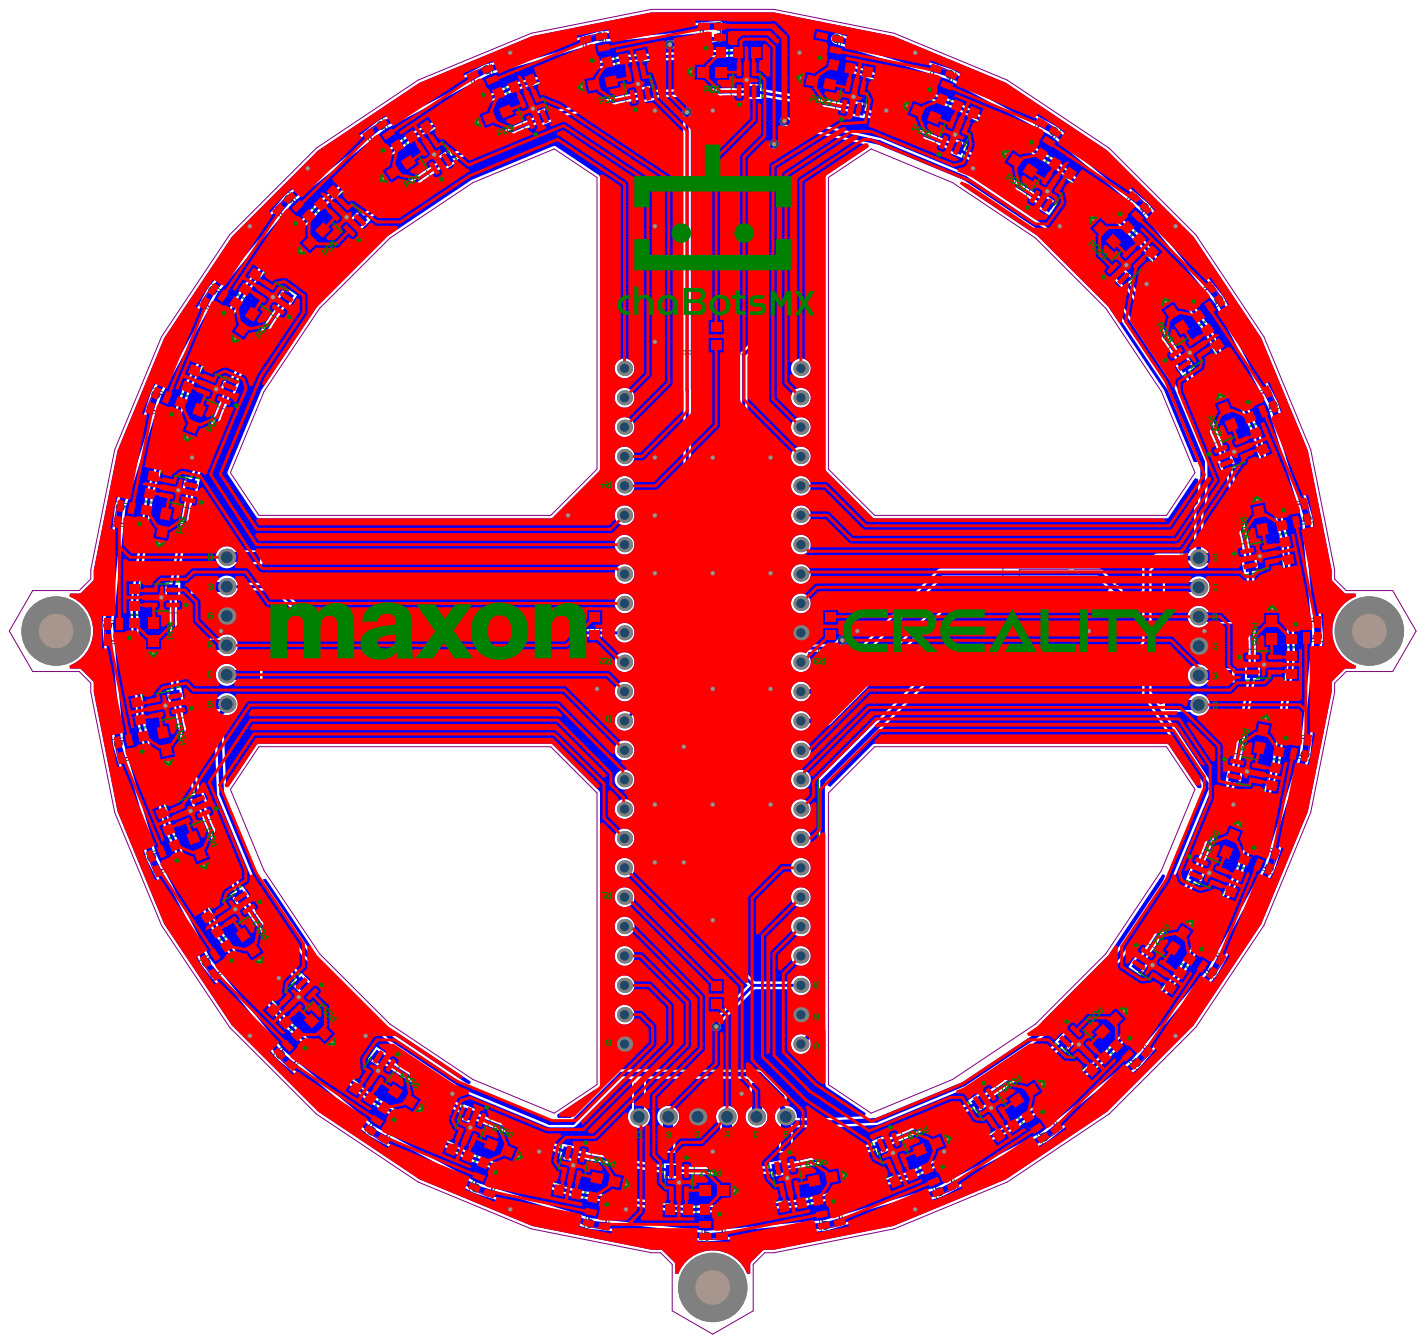
[picture p94: page 1]
