chaBotsMX/chaBots-RCJ-IR-2026/Electrical/Media/LineSensor32SCH.pdf

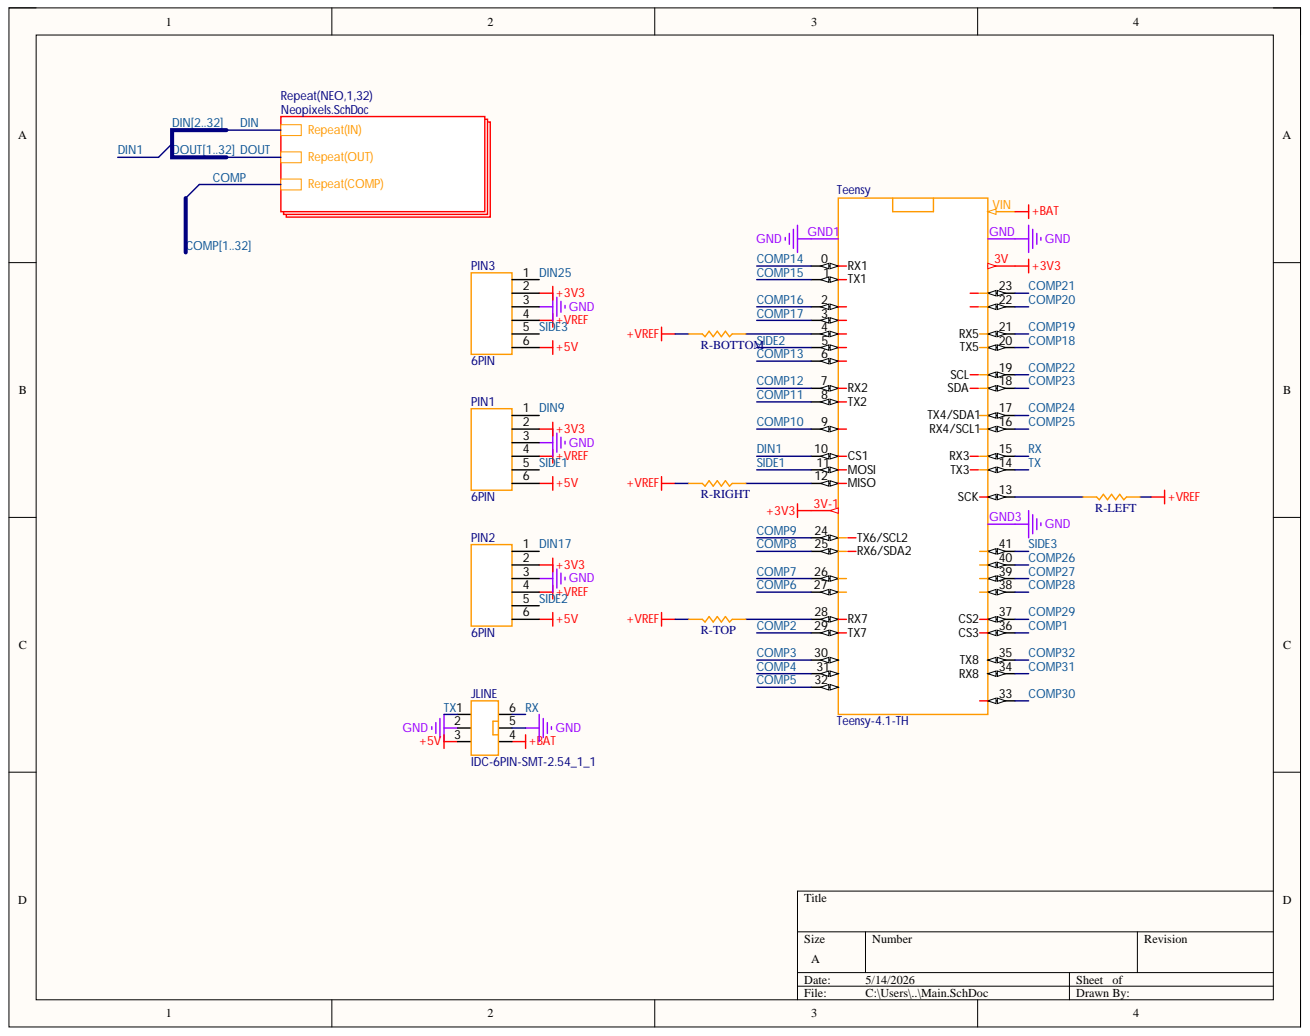
[picture p95: page 1]

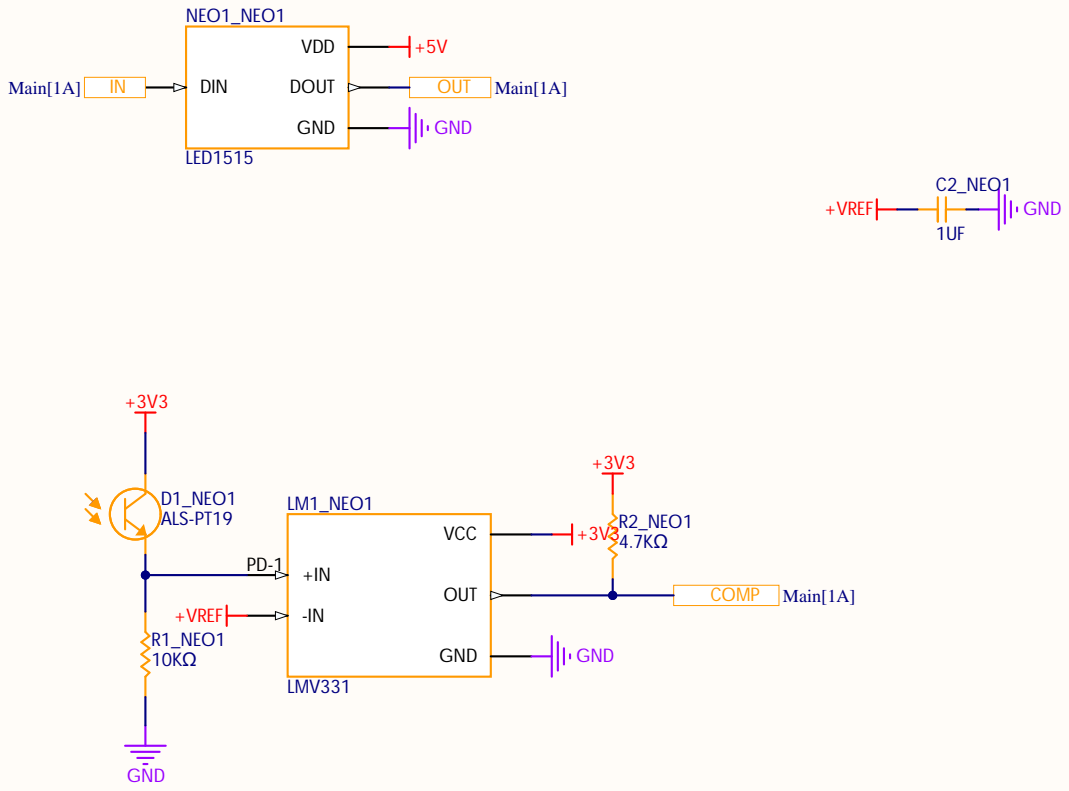
[picture p96: page 2]

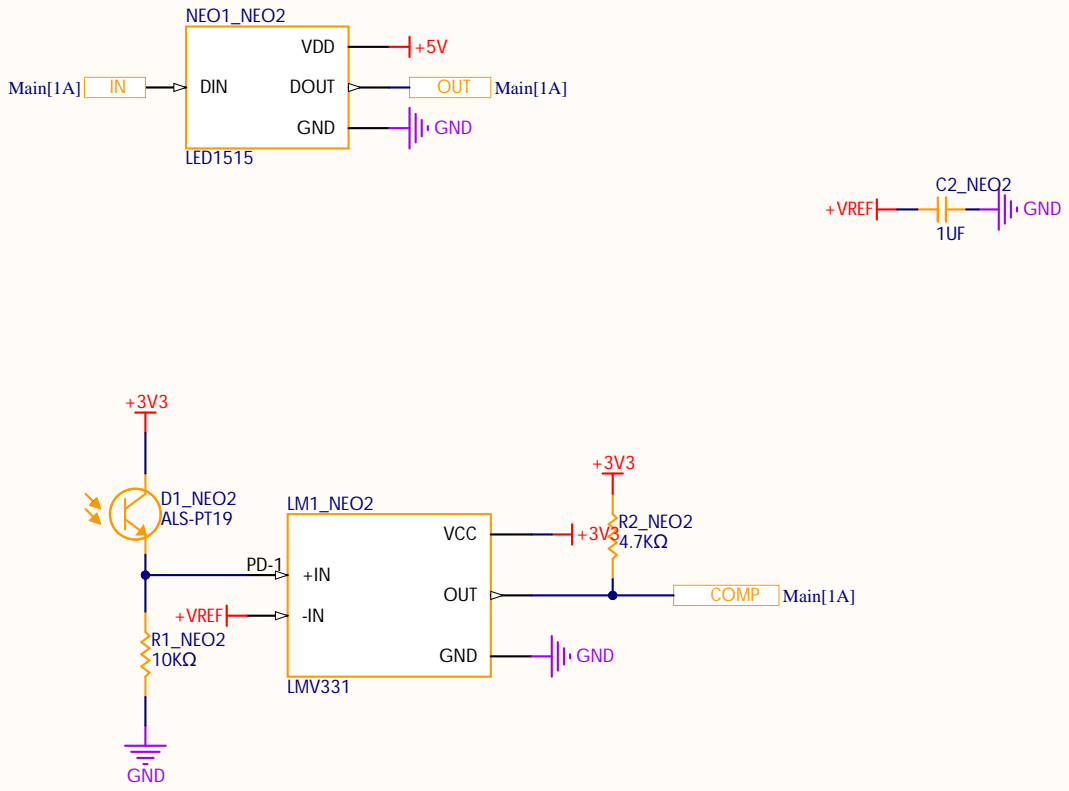
[picture p97: page 3]

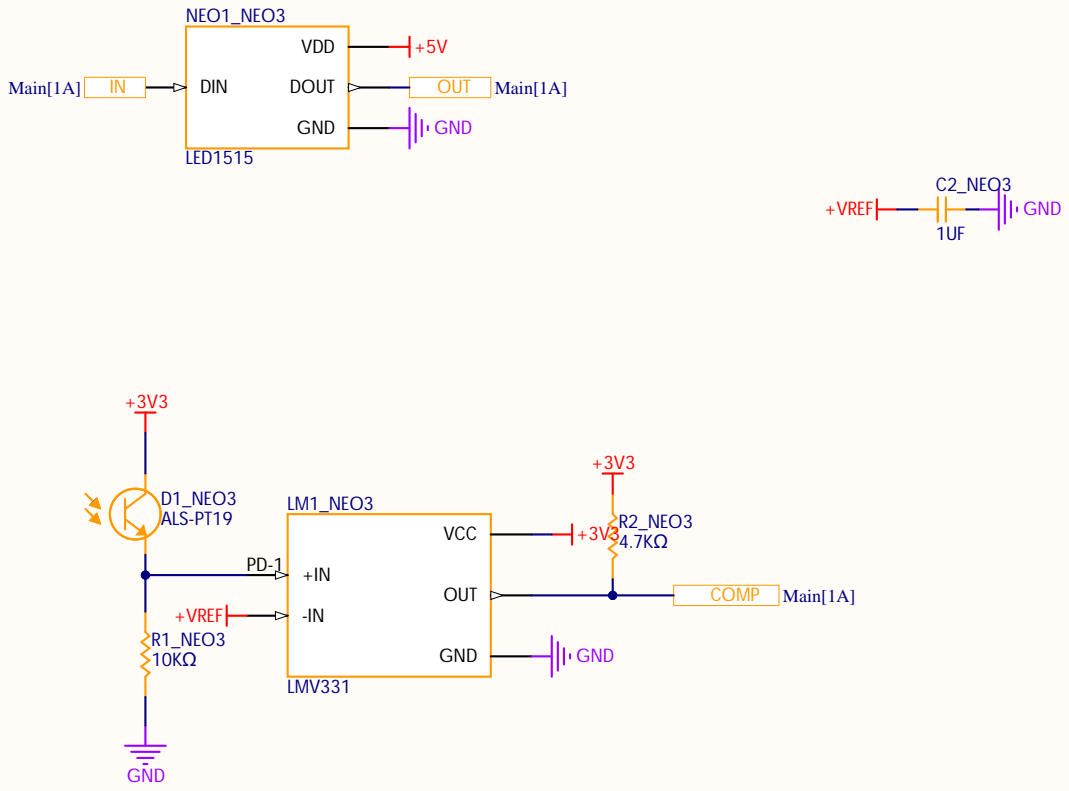
[picture p98: page 4]

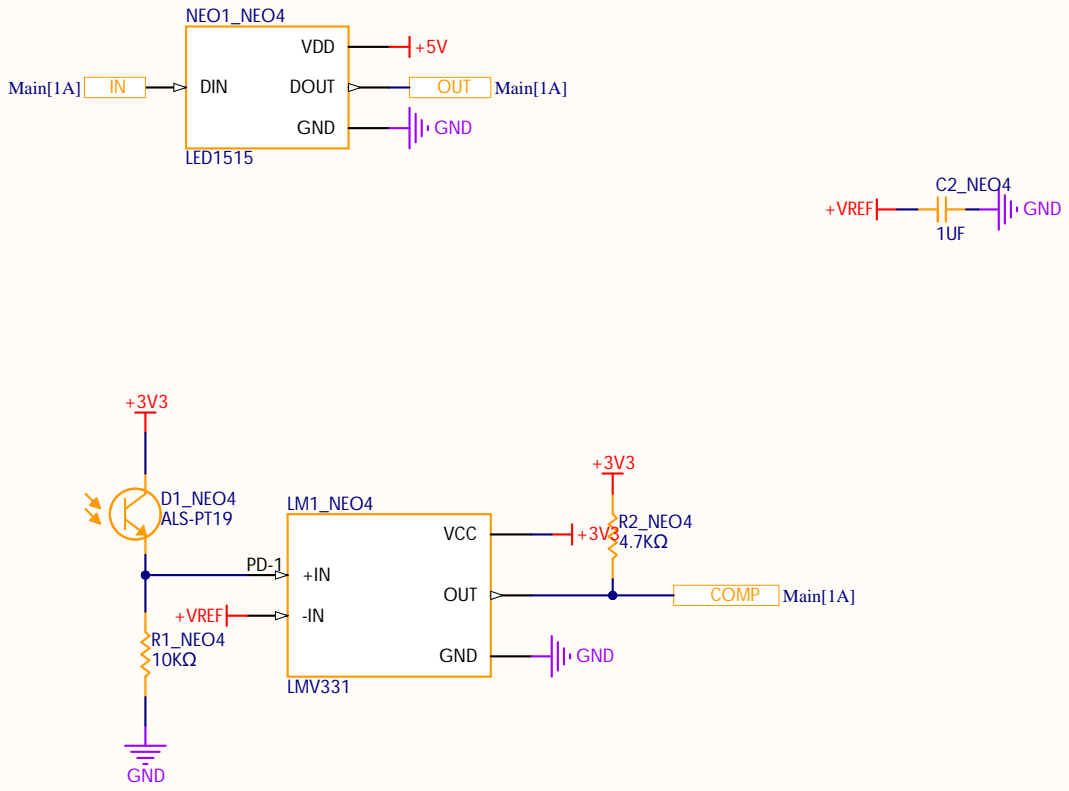
[picture p99: page 5]

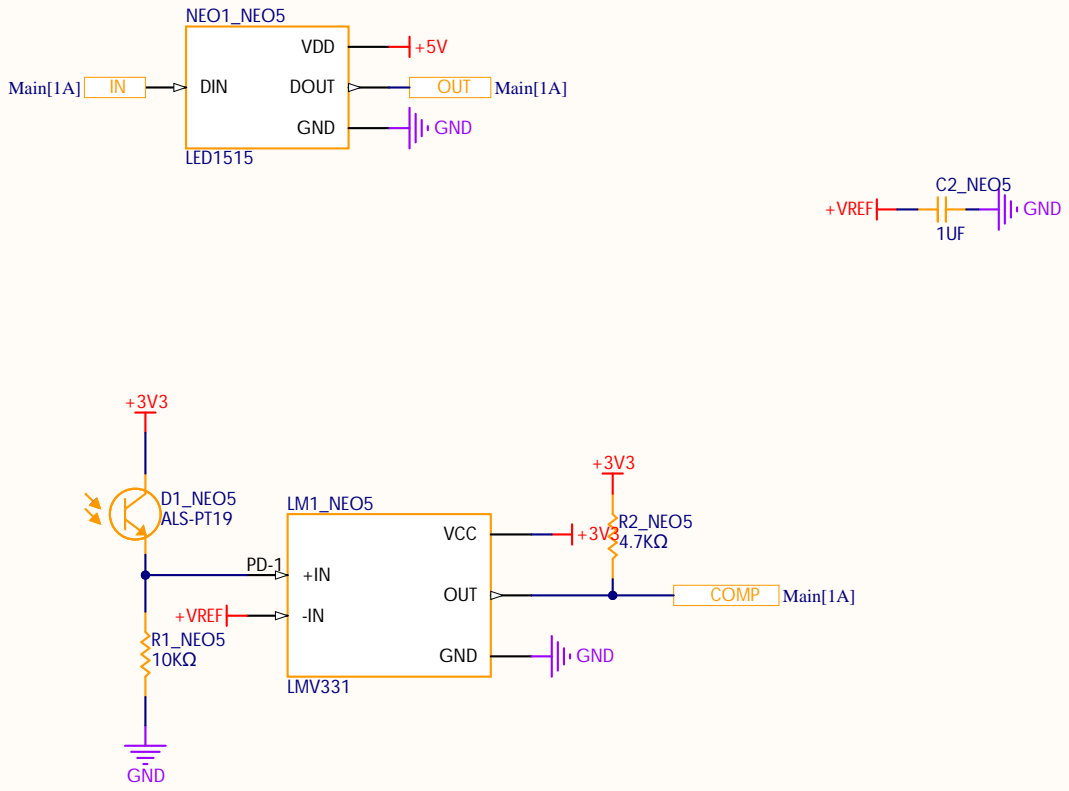
[picture p100: page 6]

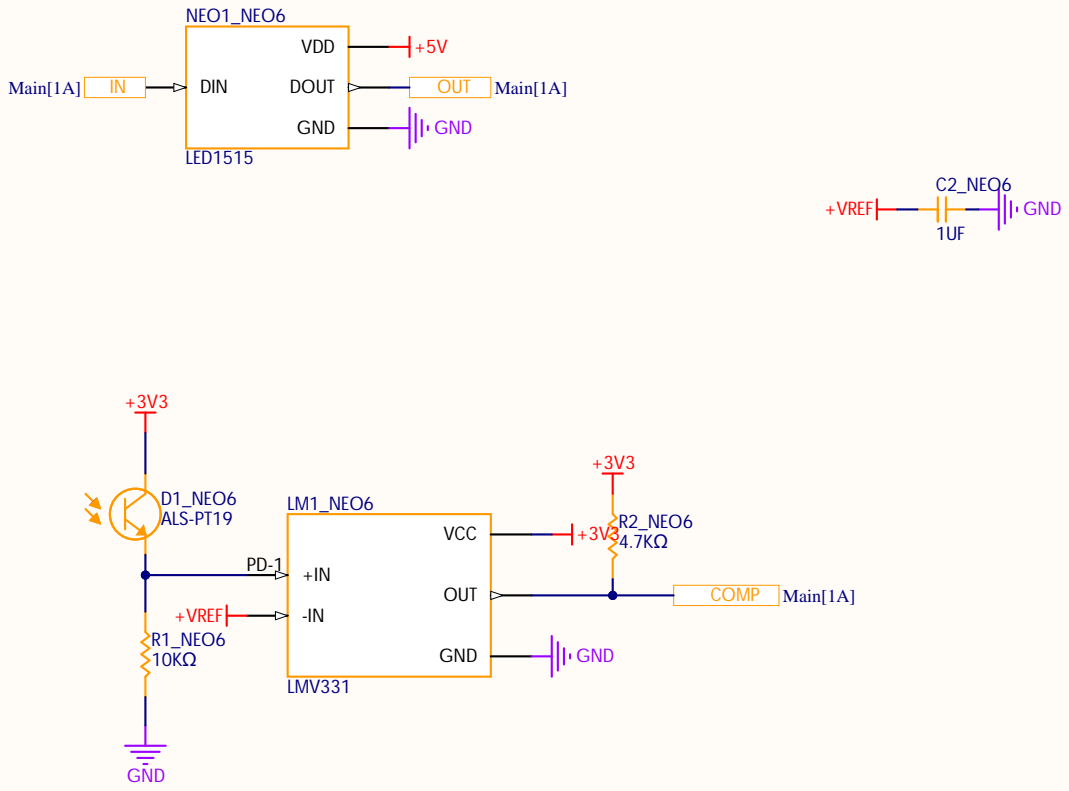
[picture p101: page 7]

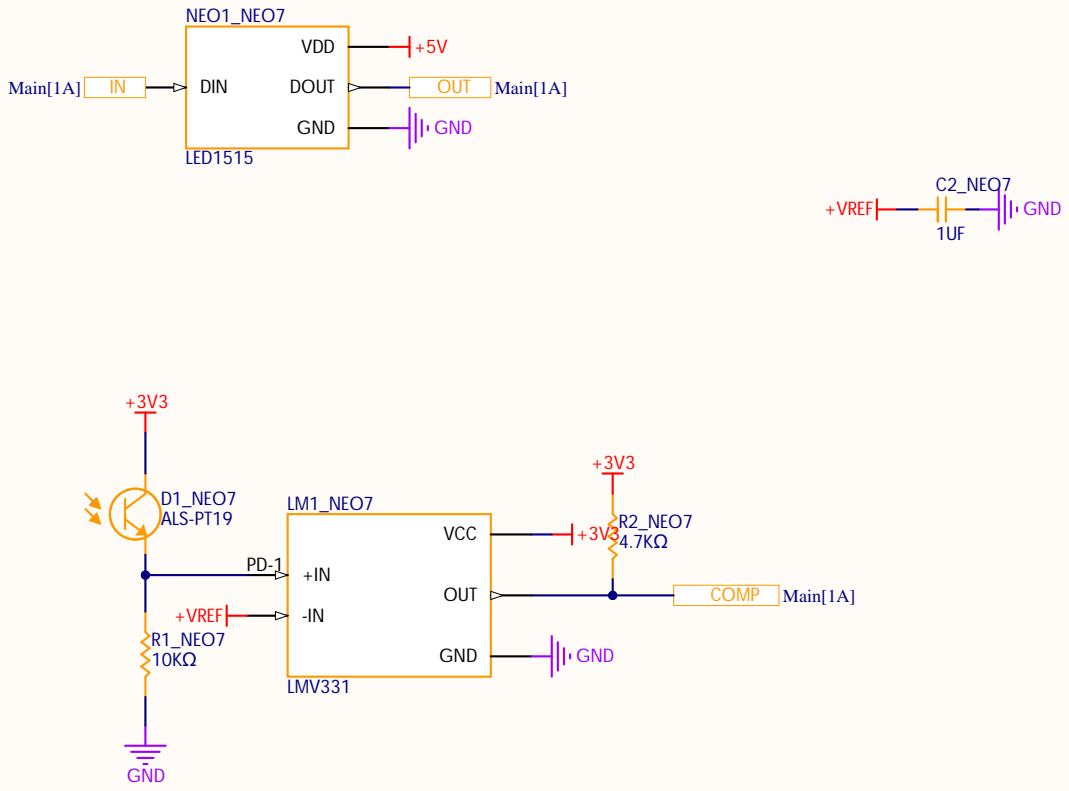
[picture p102: page 8]

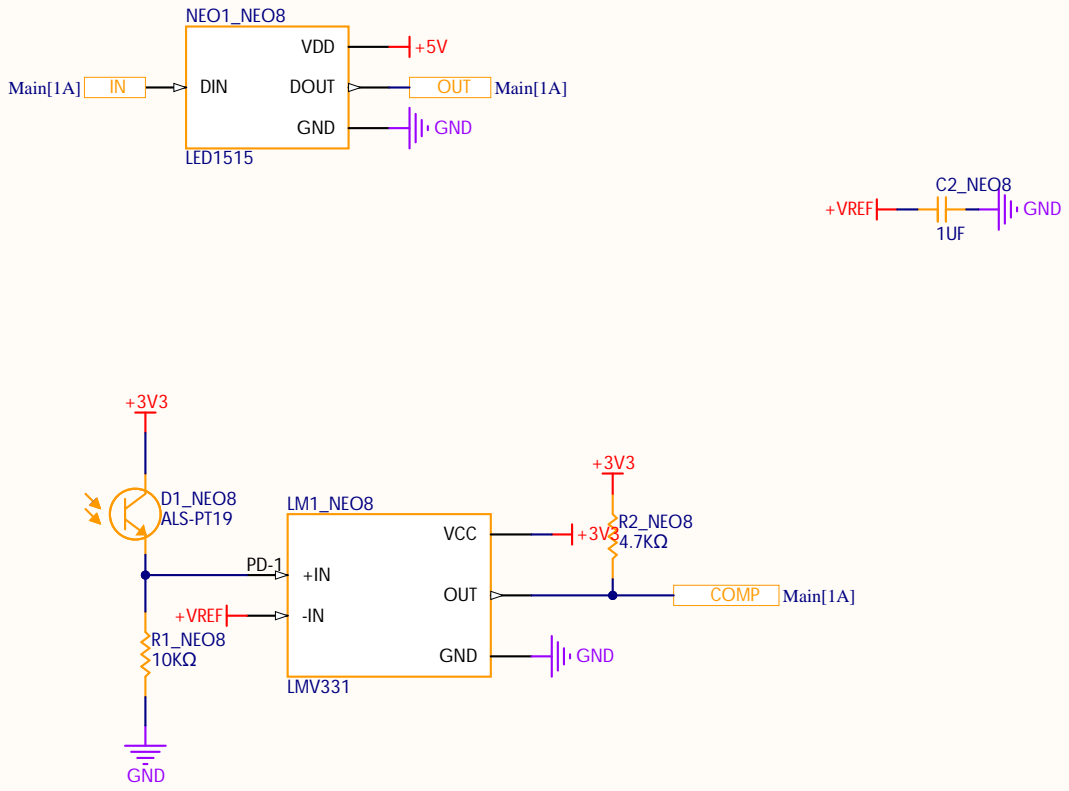
[picture p103: page 9]

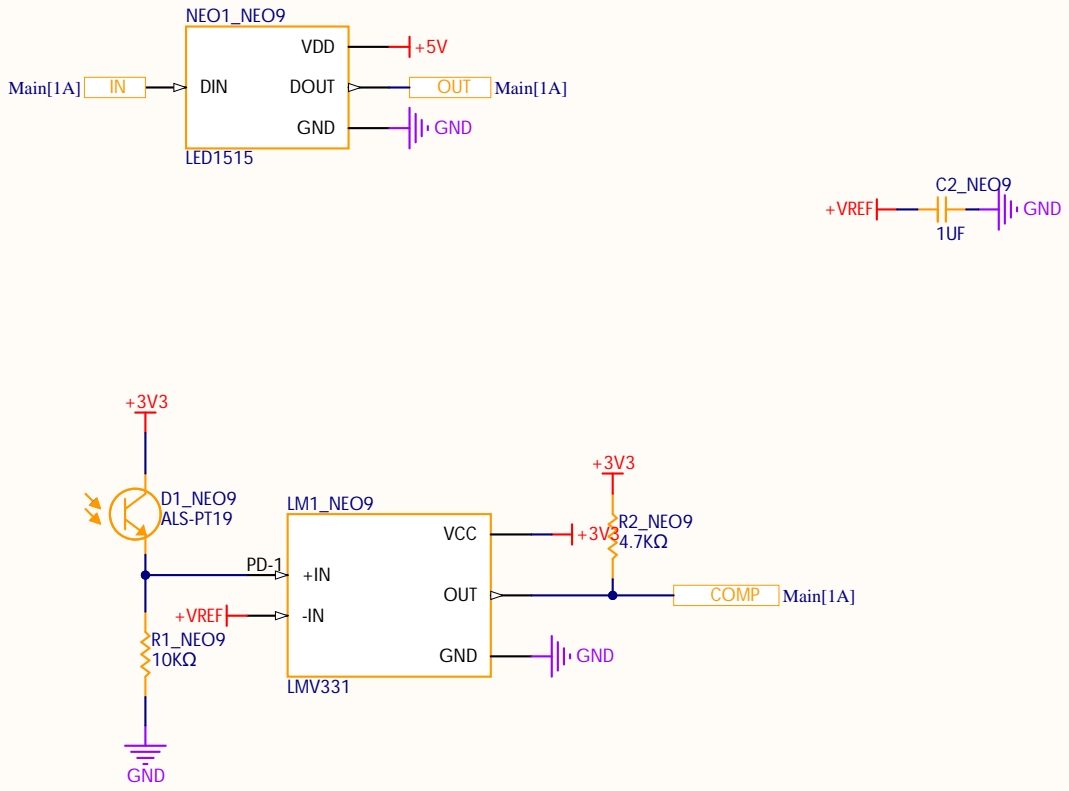
[picture p104: page 10]

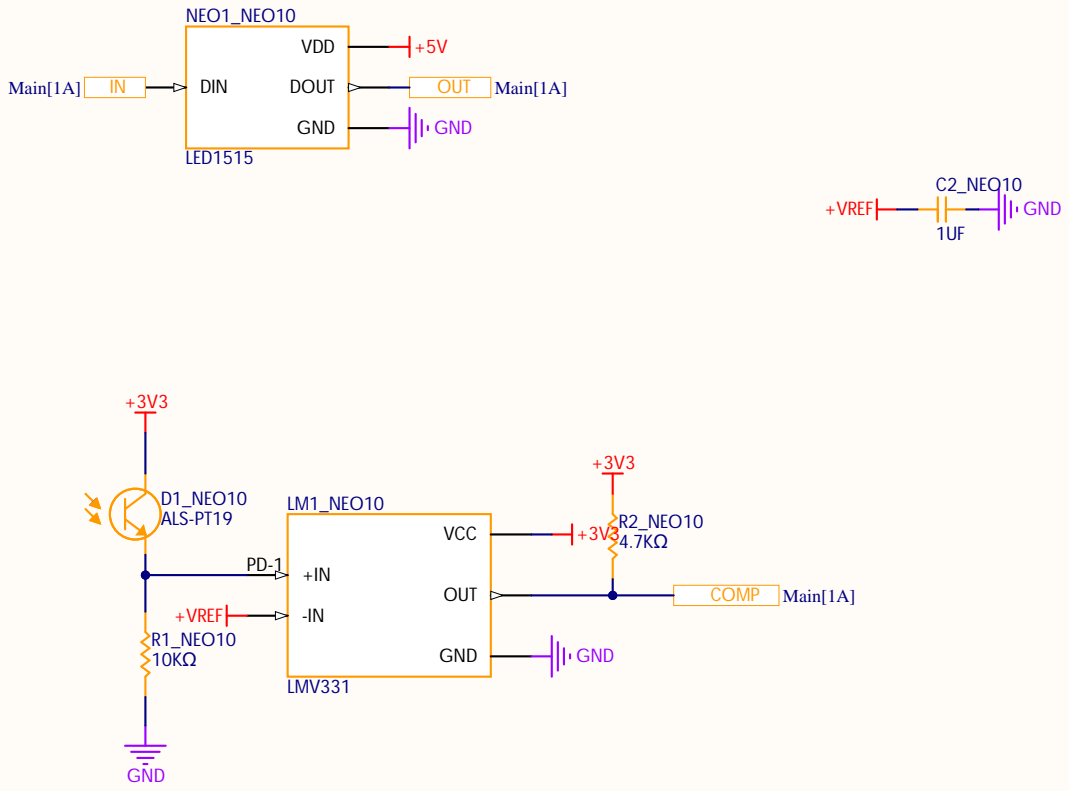
[picture p105: page 11]

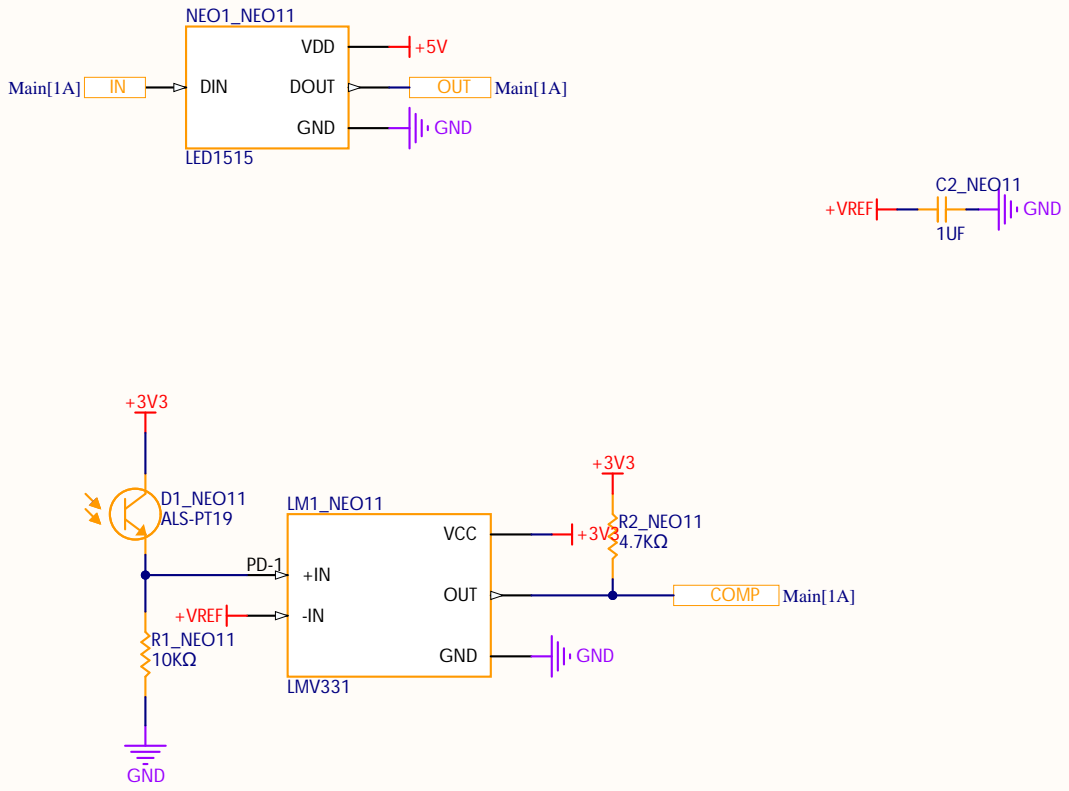
[picture p106: page 12]

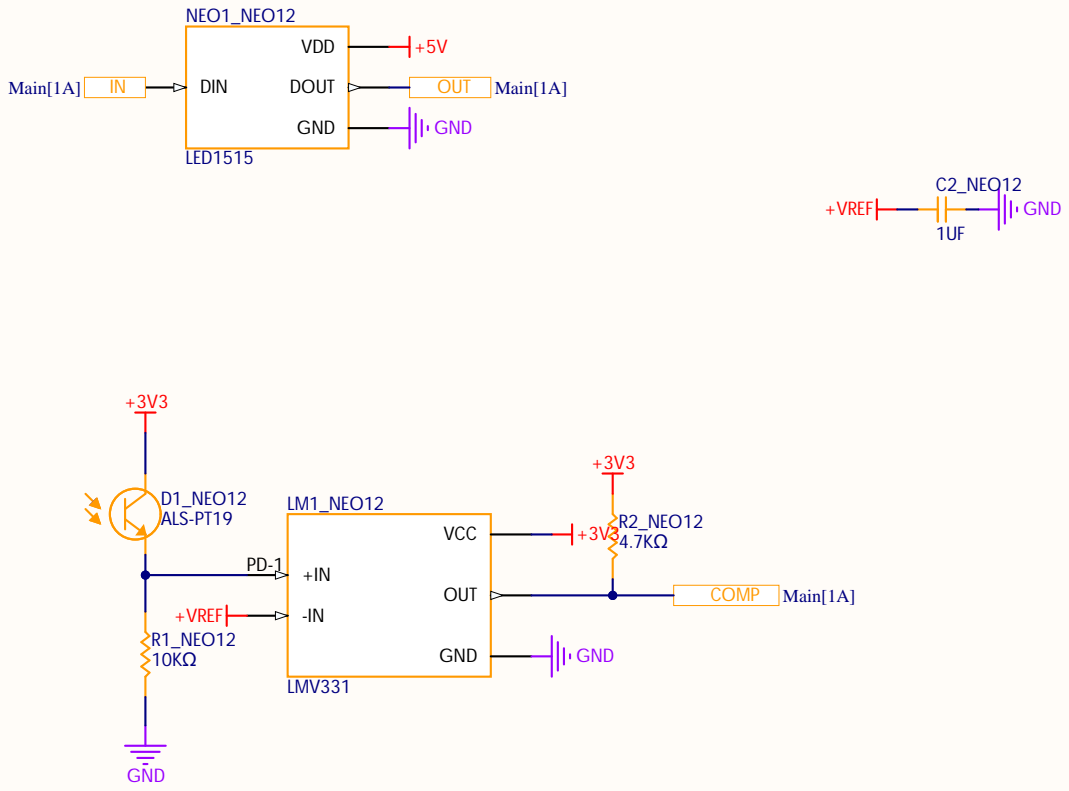
[picture p107: page 13]

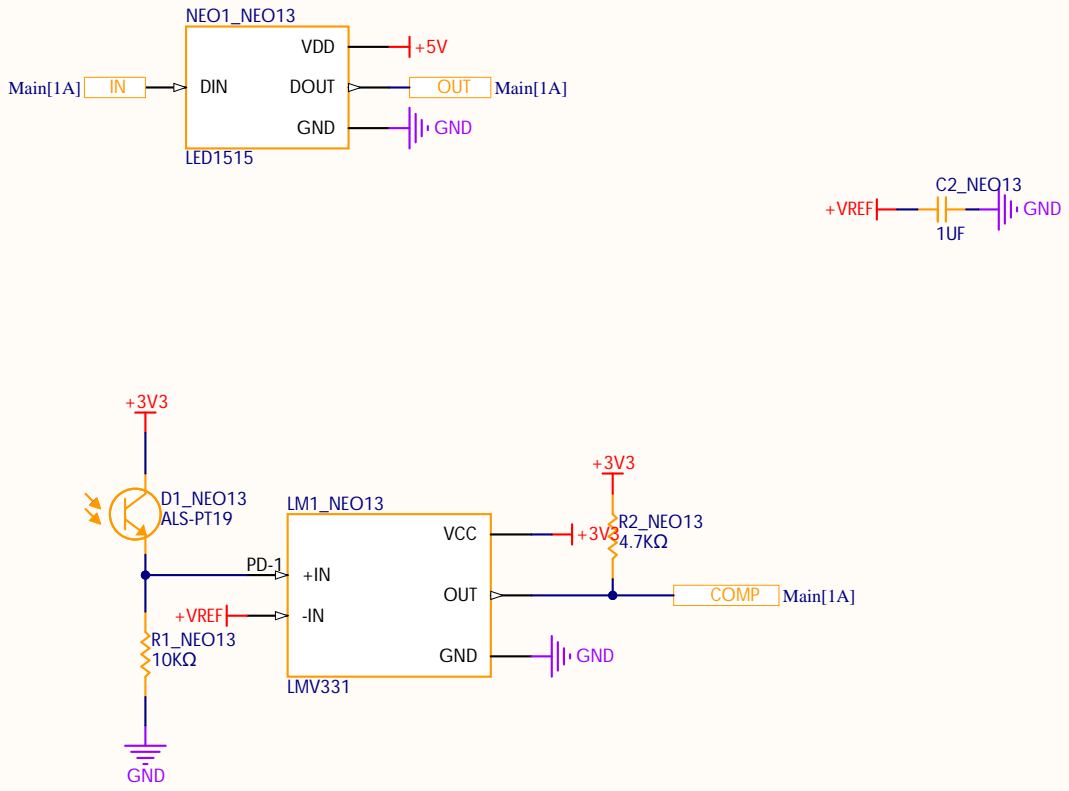
[picture p108: page 14]

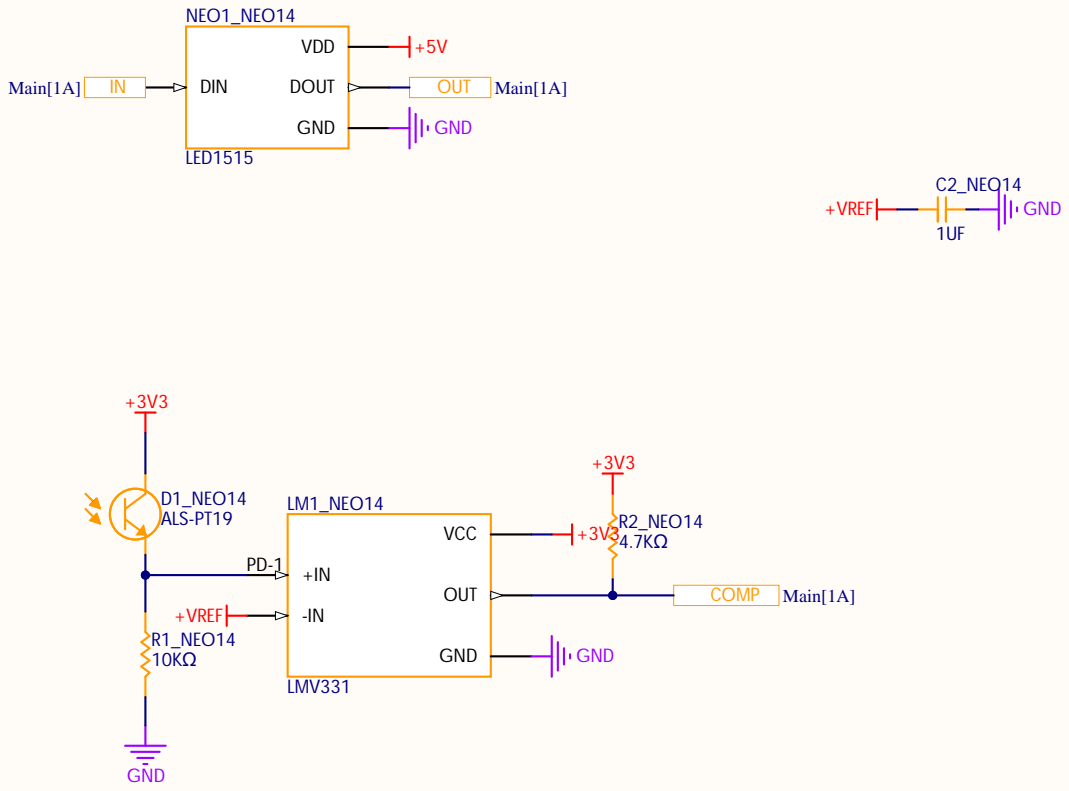
[picture p109: page 15]

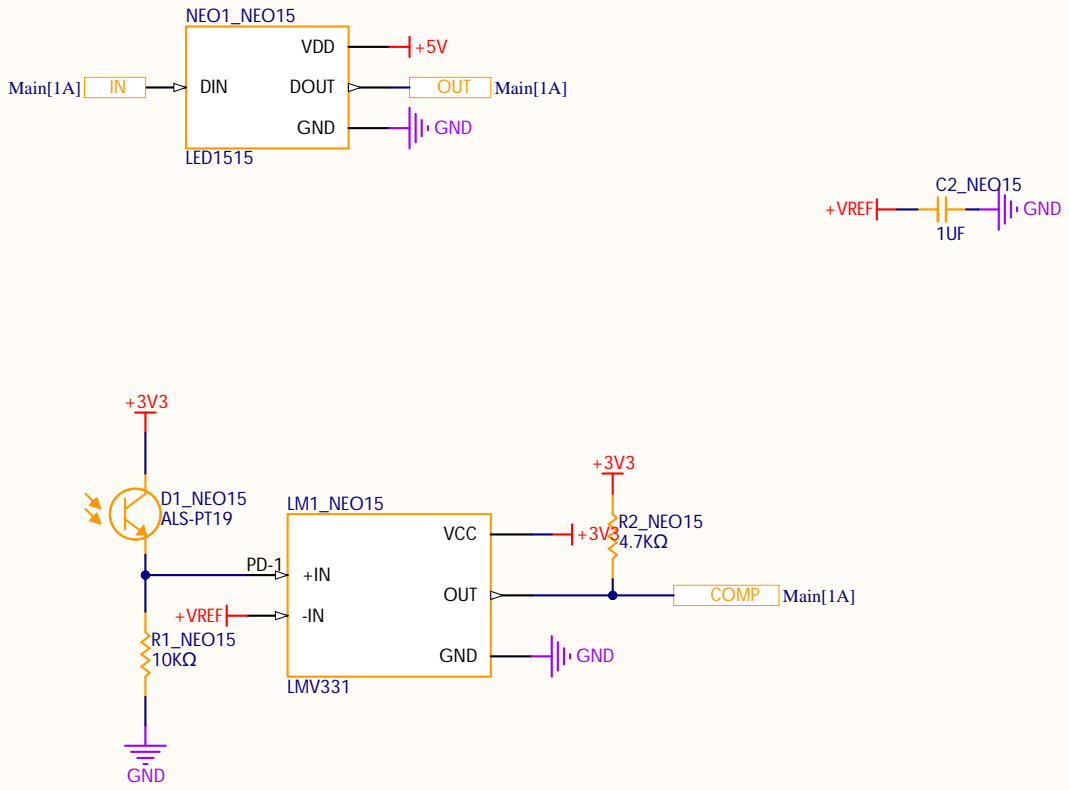
[picture p110: page 16]

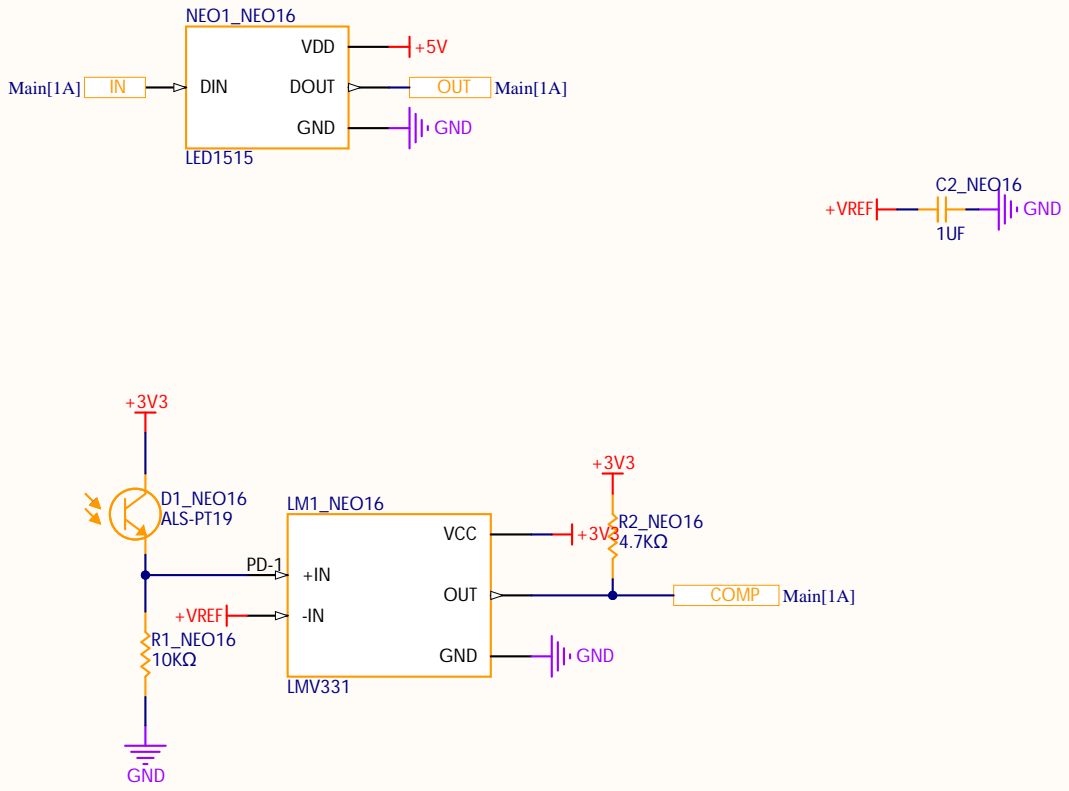
[picture p111: page 17]

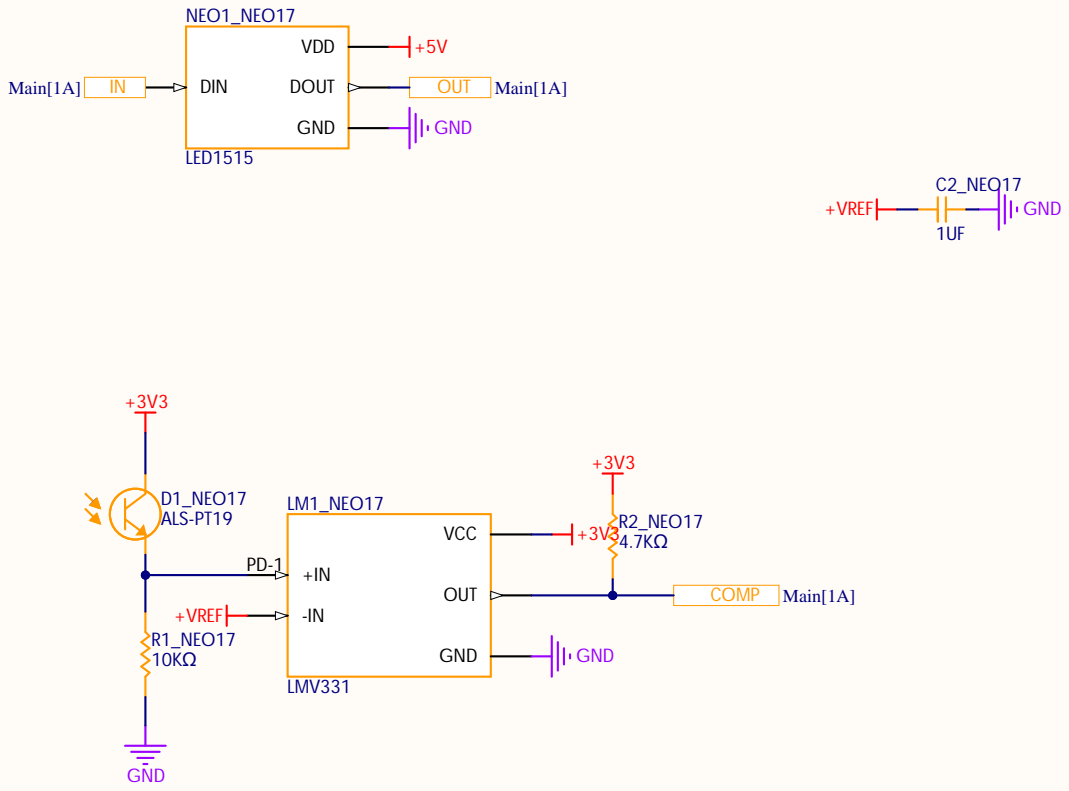
[picture p112: page 18]

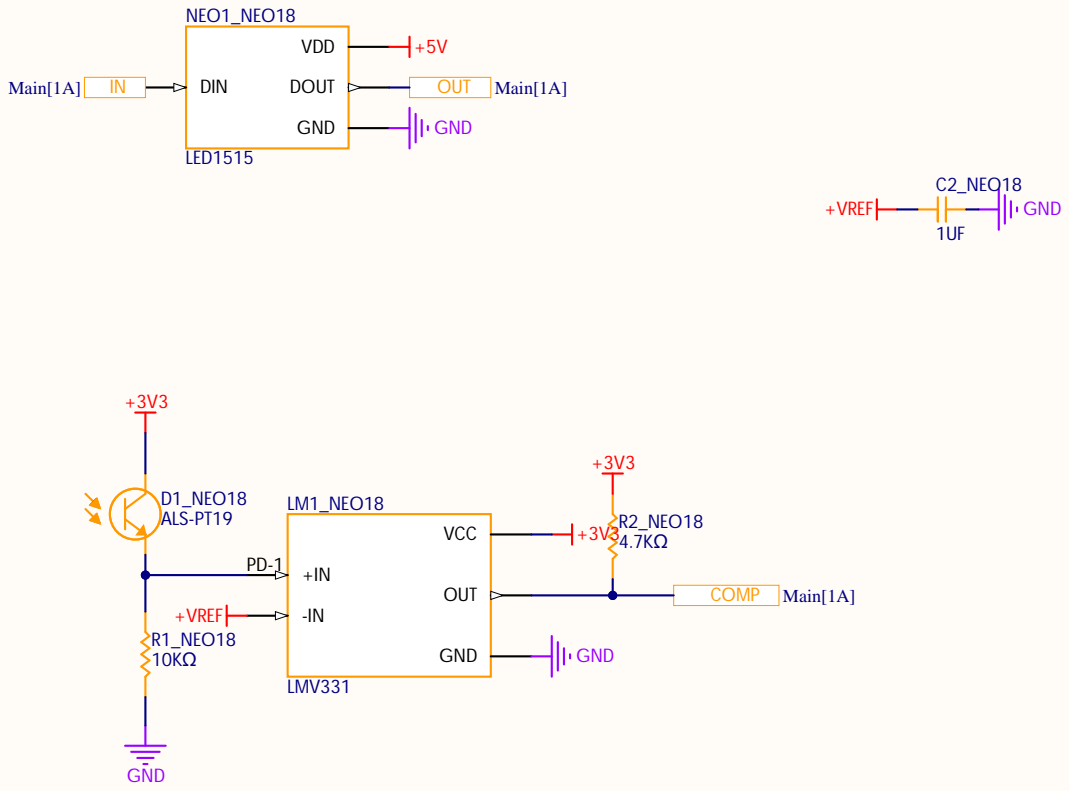
[picture p113: page 19]

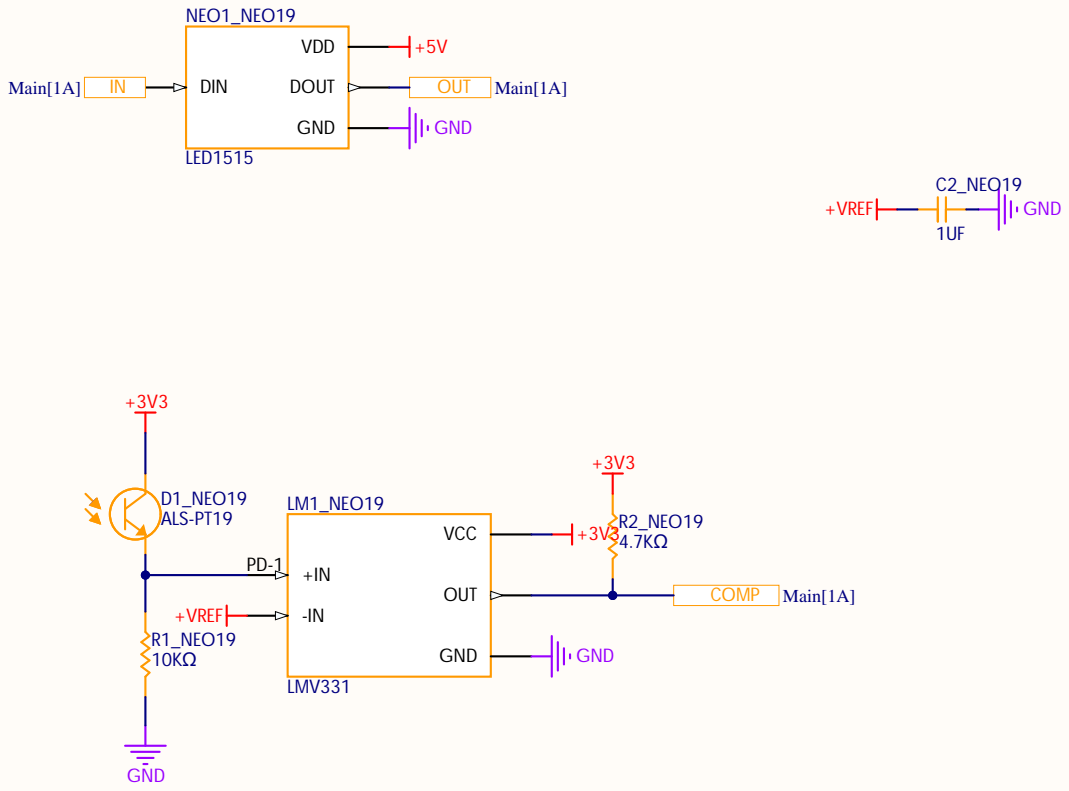
[picture p114: page 20]

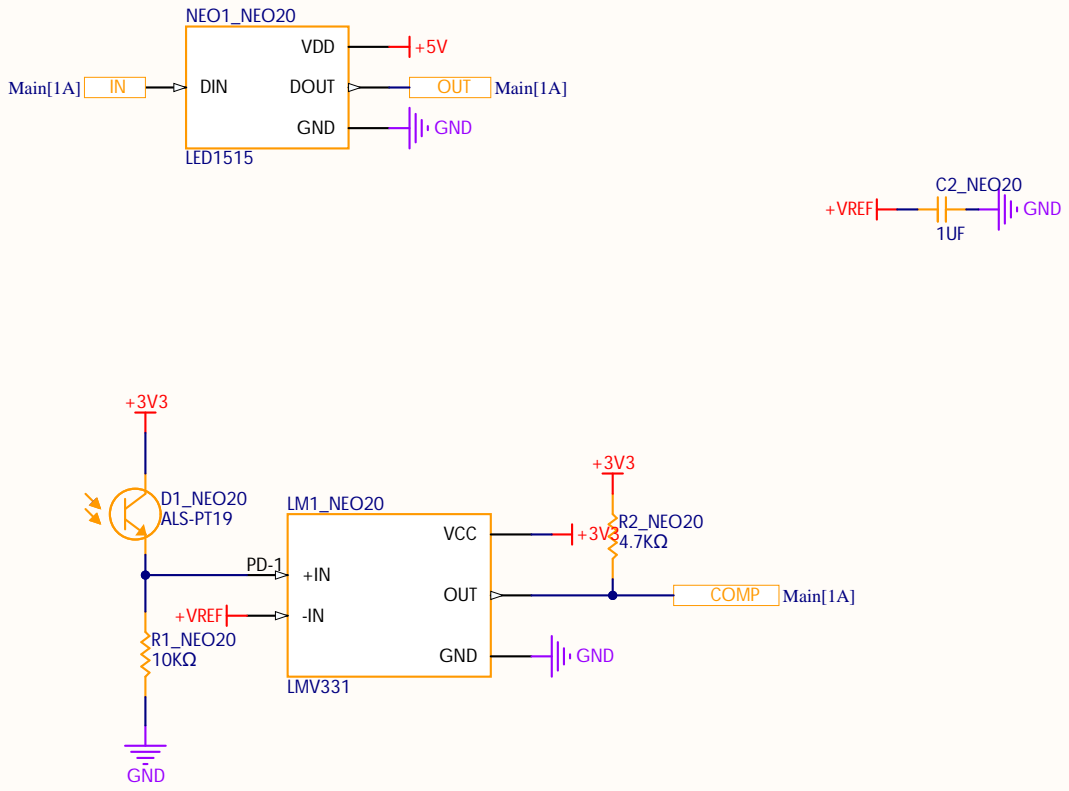
[picture p115: page 21]

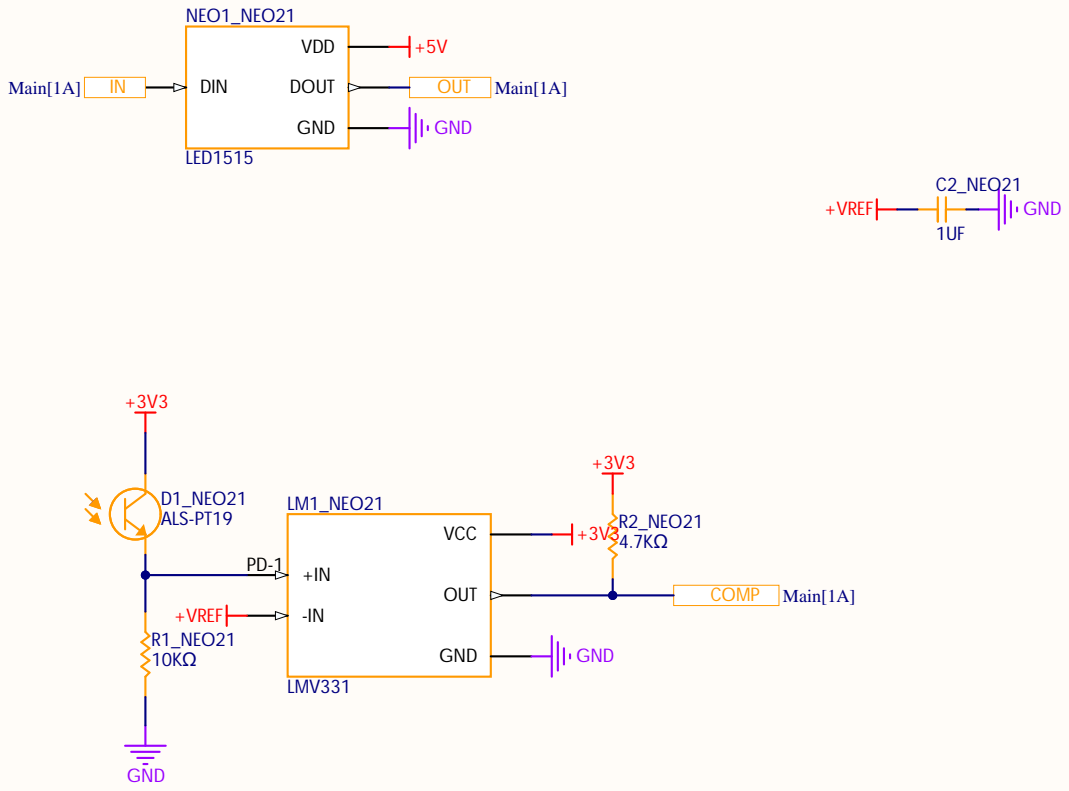
[picture p116: page 22]

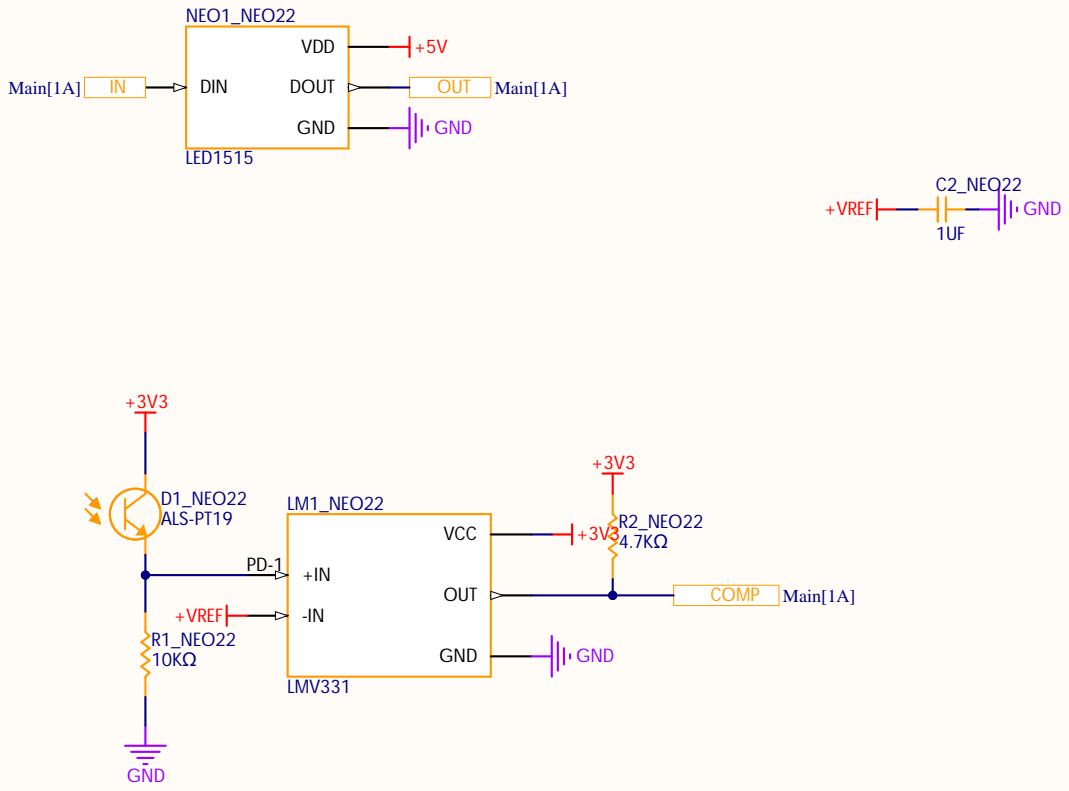
[picture p117: page 23]

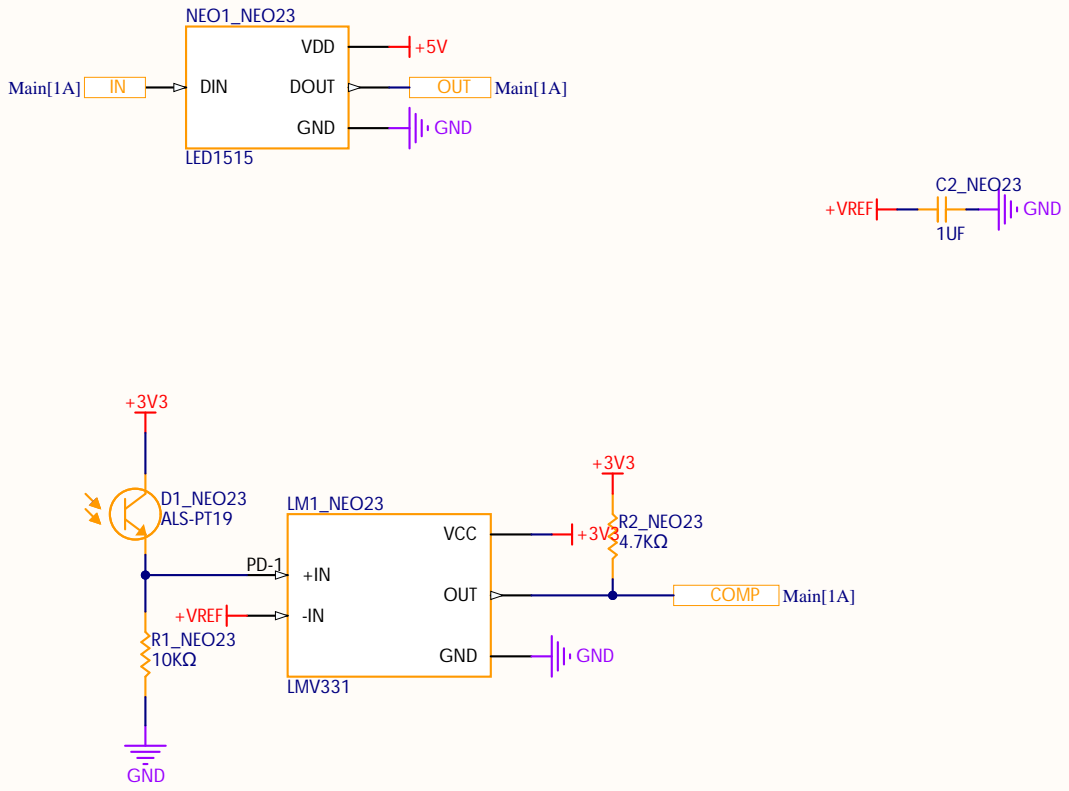
[picture p118: page 24]

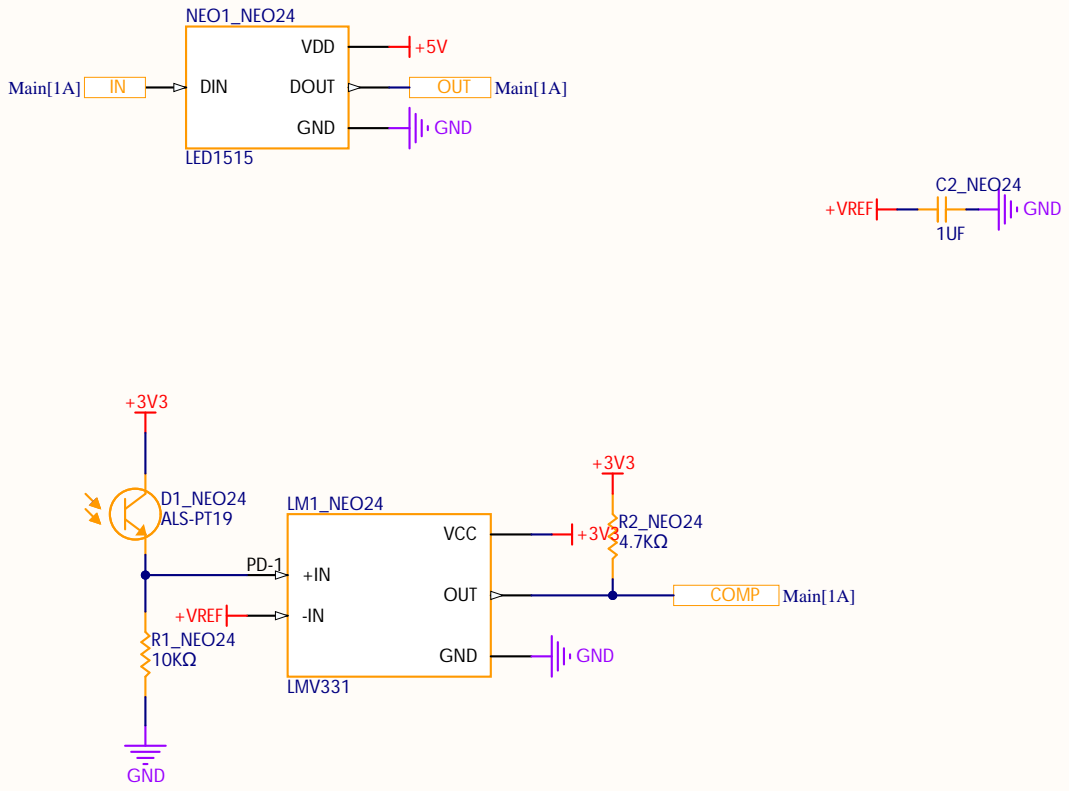
[picture p119: page 25]

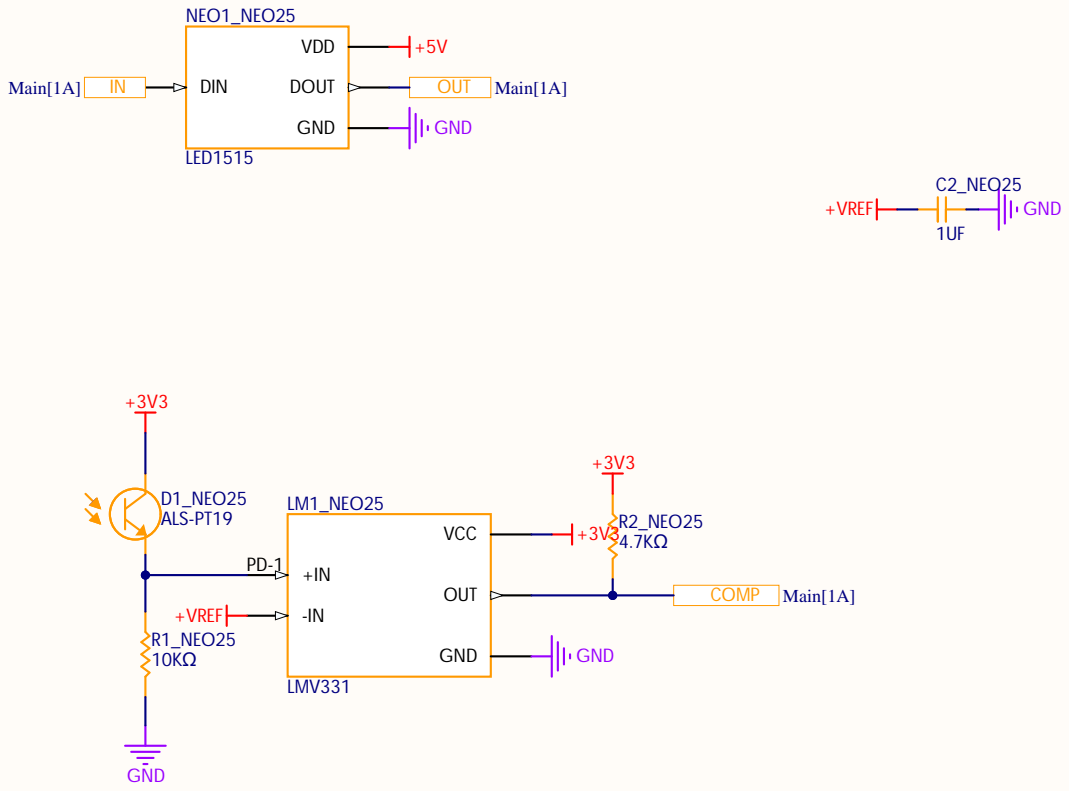
[picture p120: page 26]

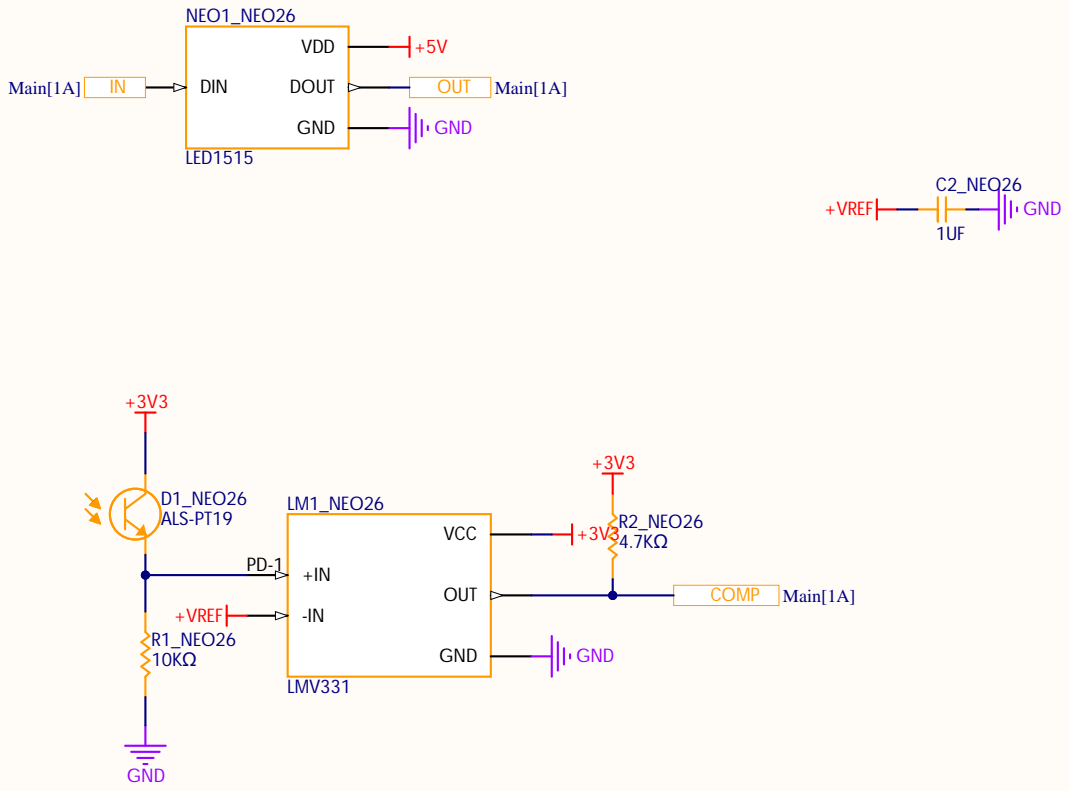
[picture p121: page 27]

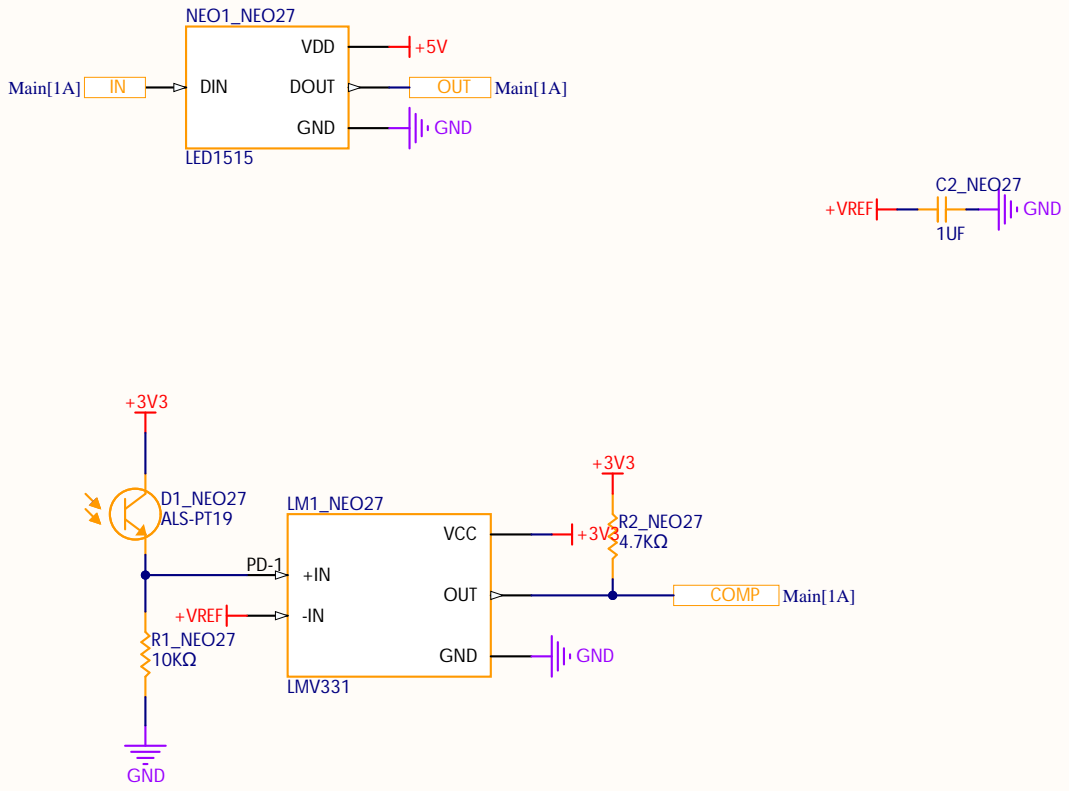
[picture p122: page 28]

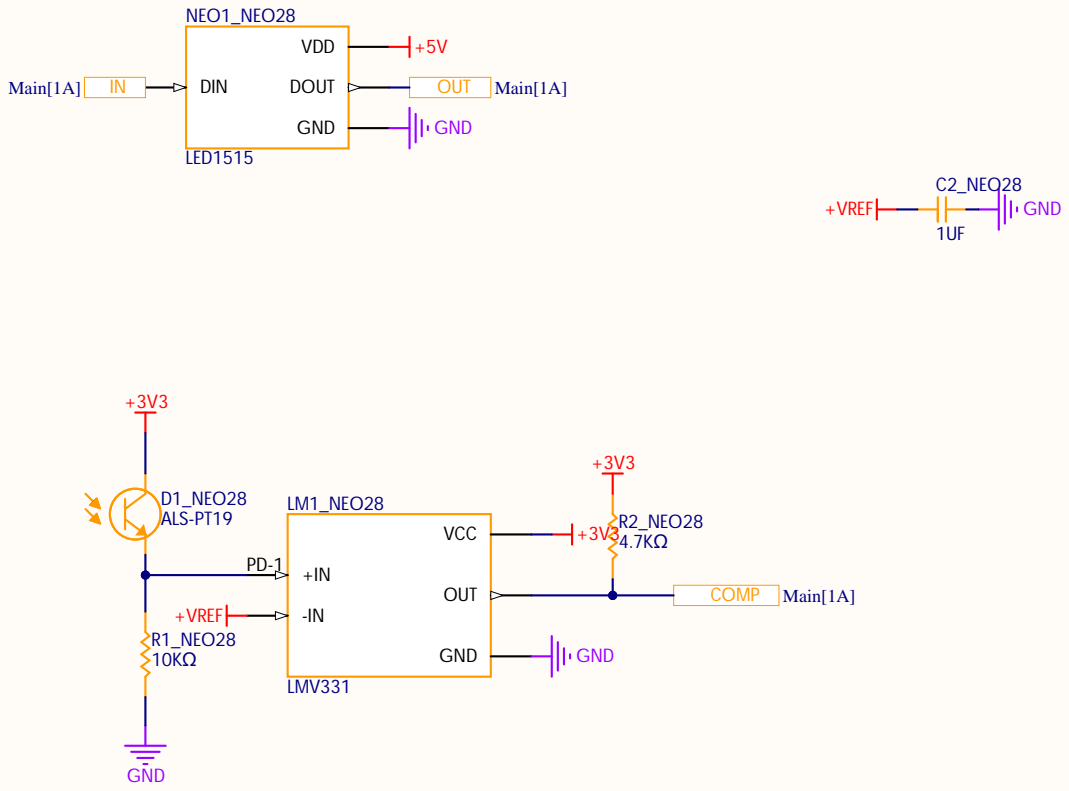
[picture p123: page 29]

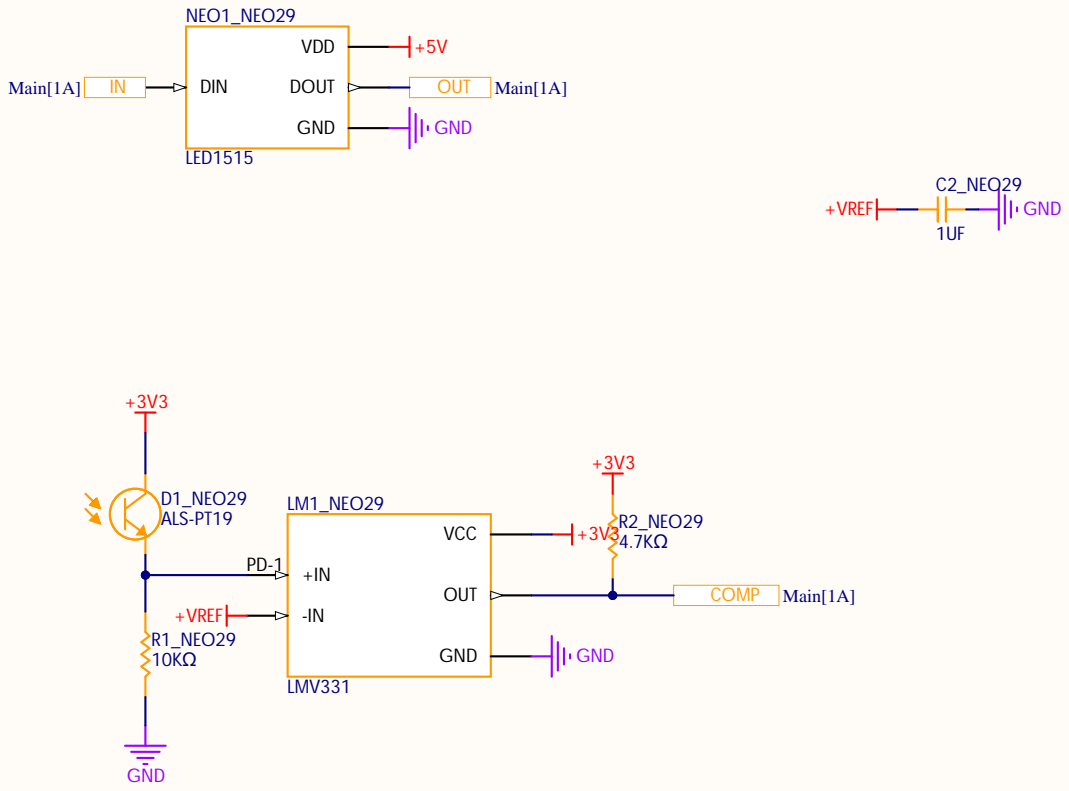
[picture p124: page 30]

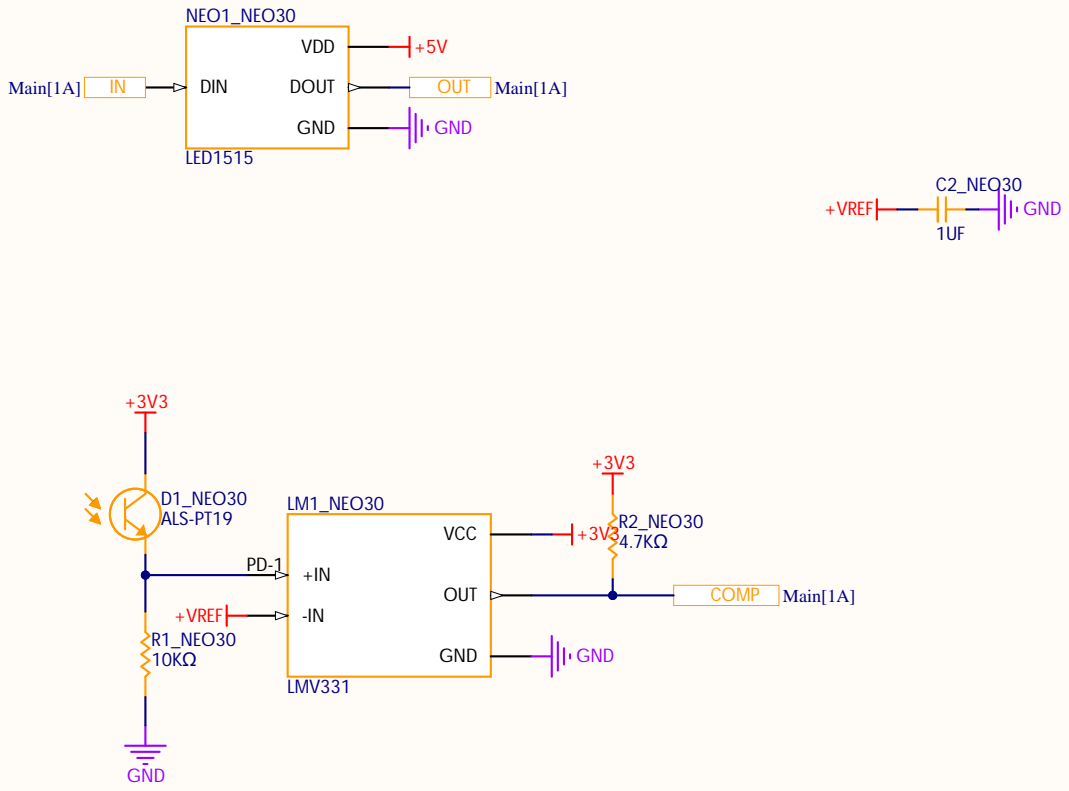
[picture p125: page 31]

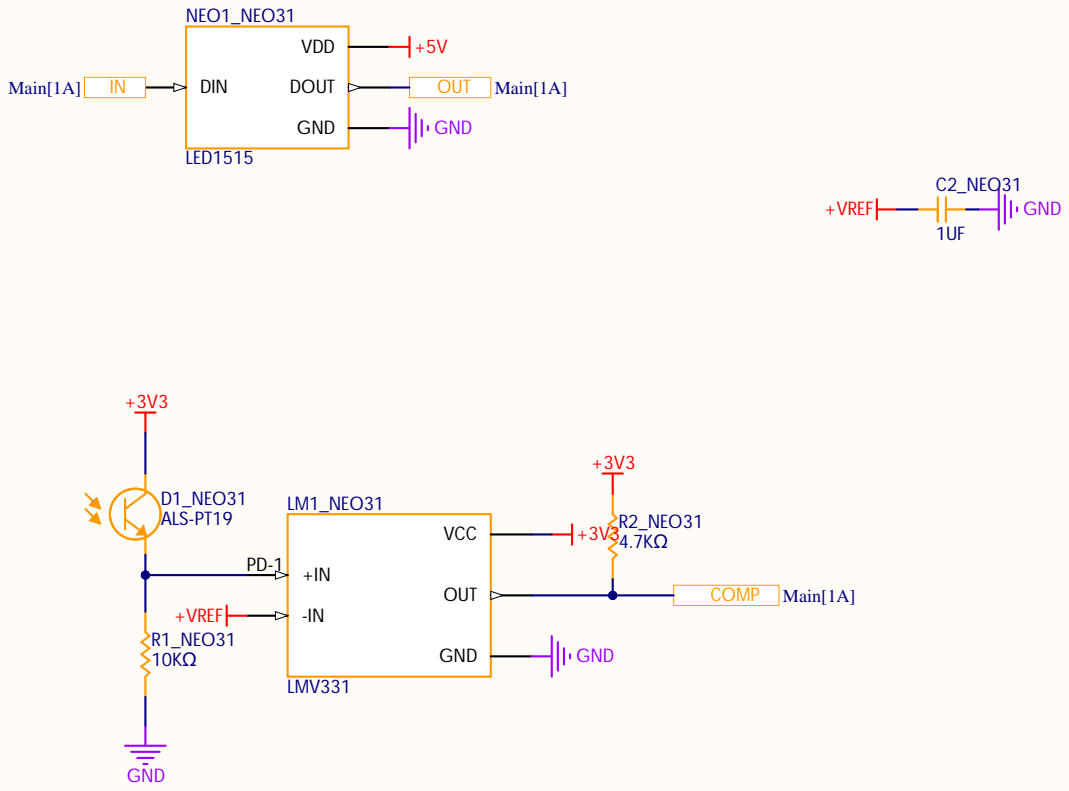
[picture p126: page 32]

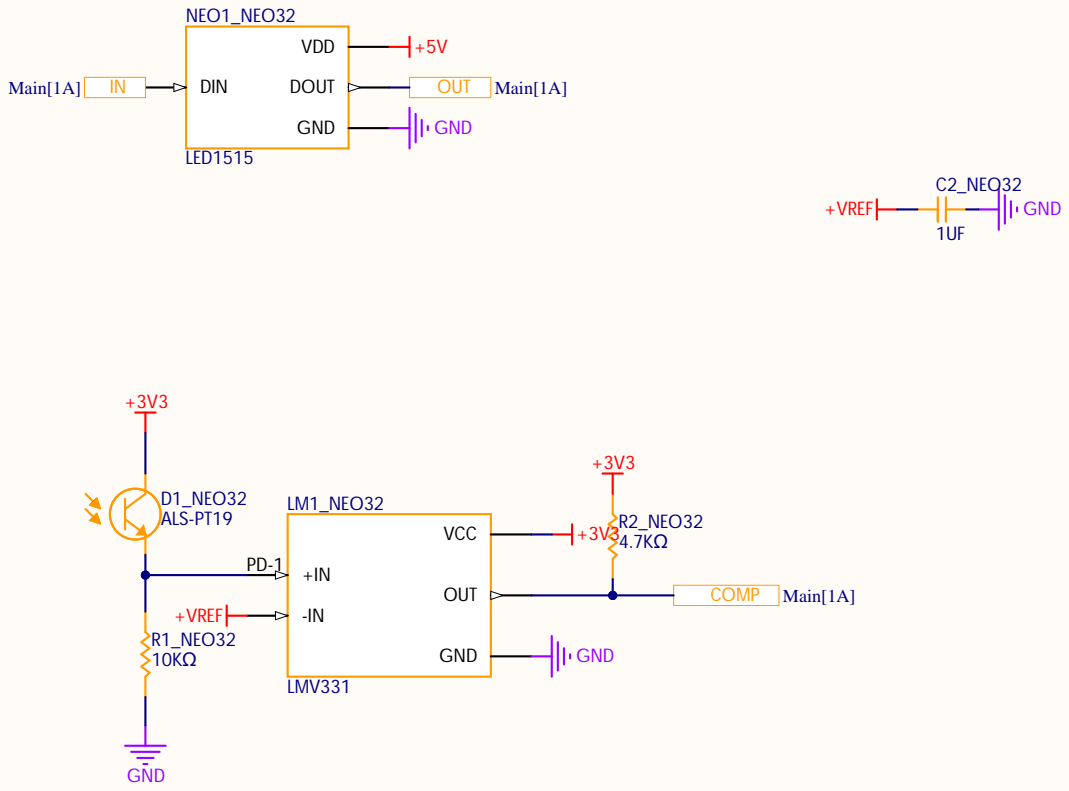
[picture p127: page 33]

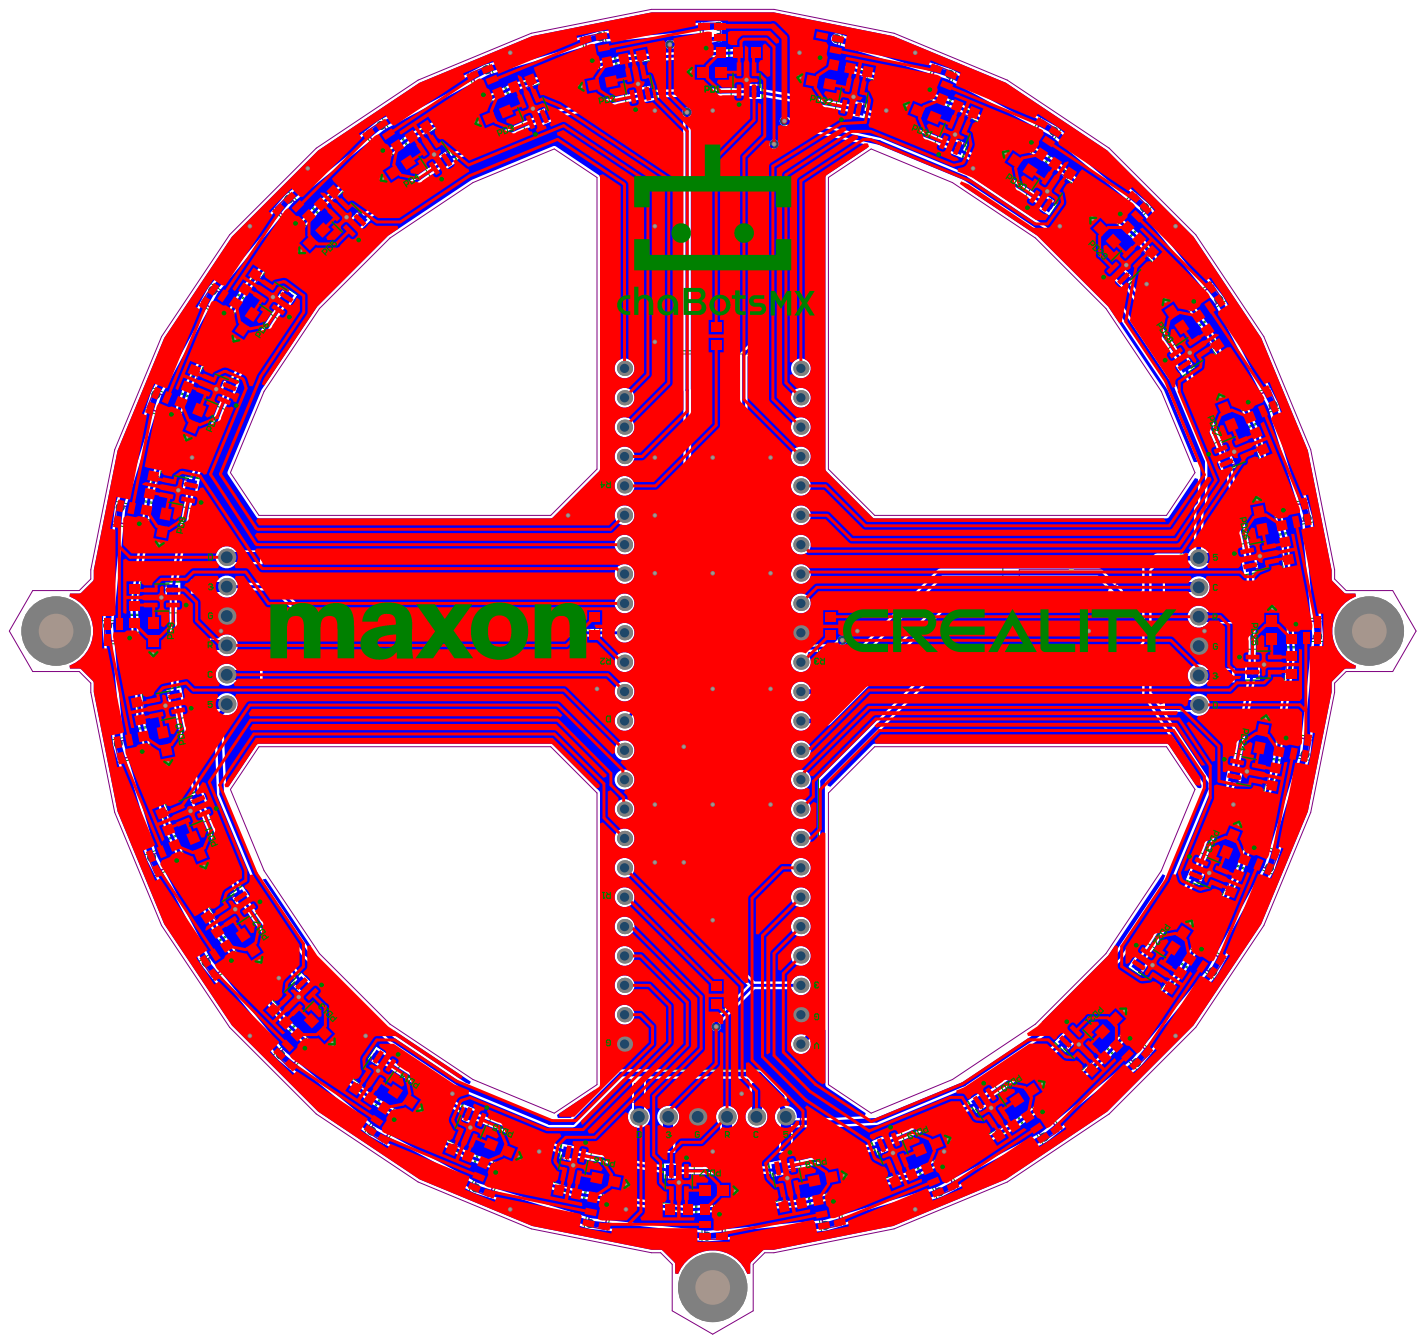
[picture p128: page 34]
