chaBotsMX/chaBots-RCJ-IR-2026/Electrical/Media/MainBoard-16PCB.pdf

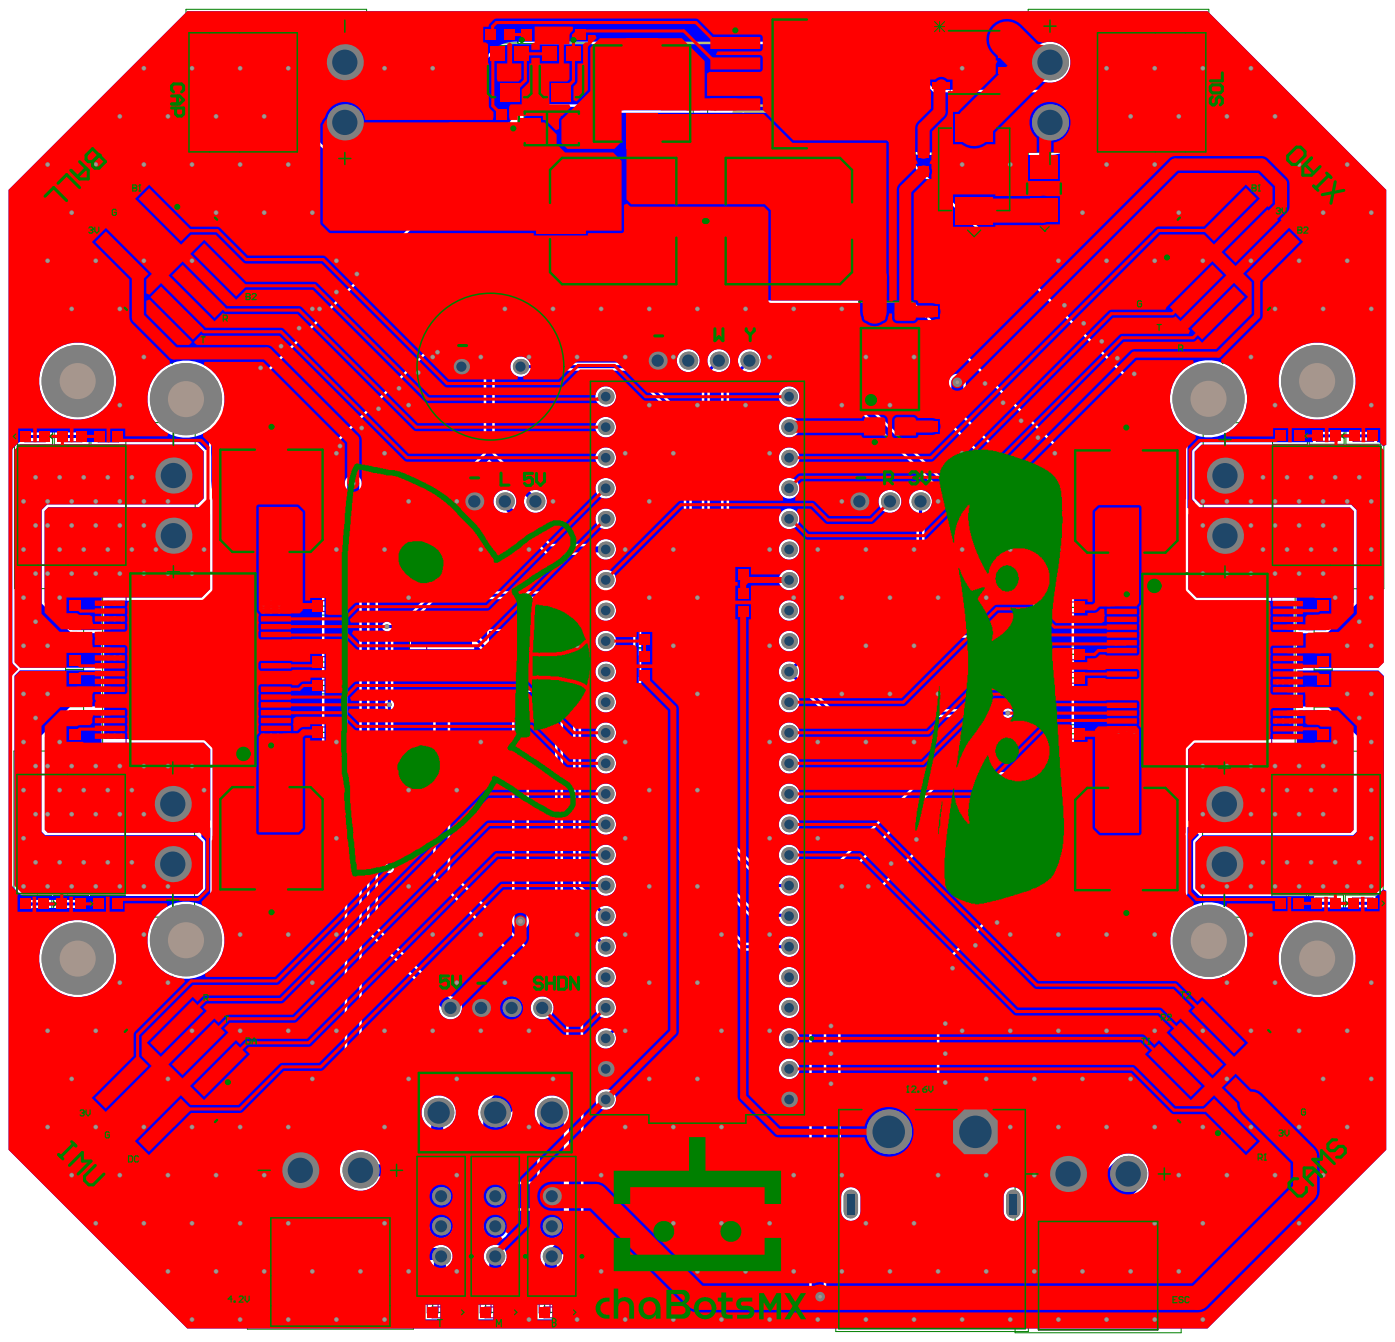
[picture p129: page 1]
