chaBotsMX/chaBots-RCJ-IR-2026/Electrical/Media/MainBoard-16SCH.pdf

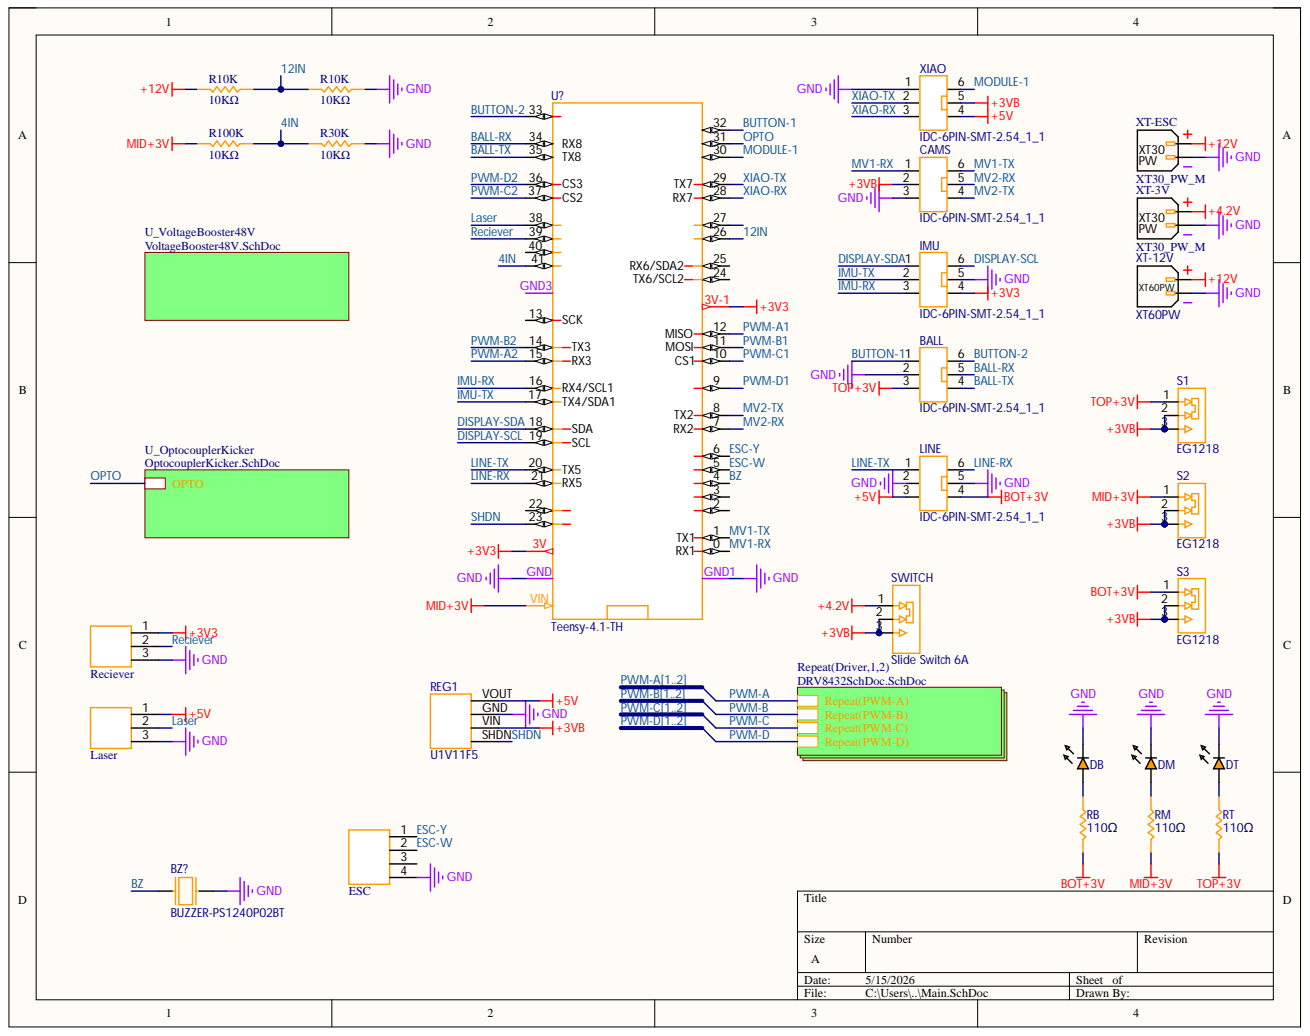
[picture p130: page 1]

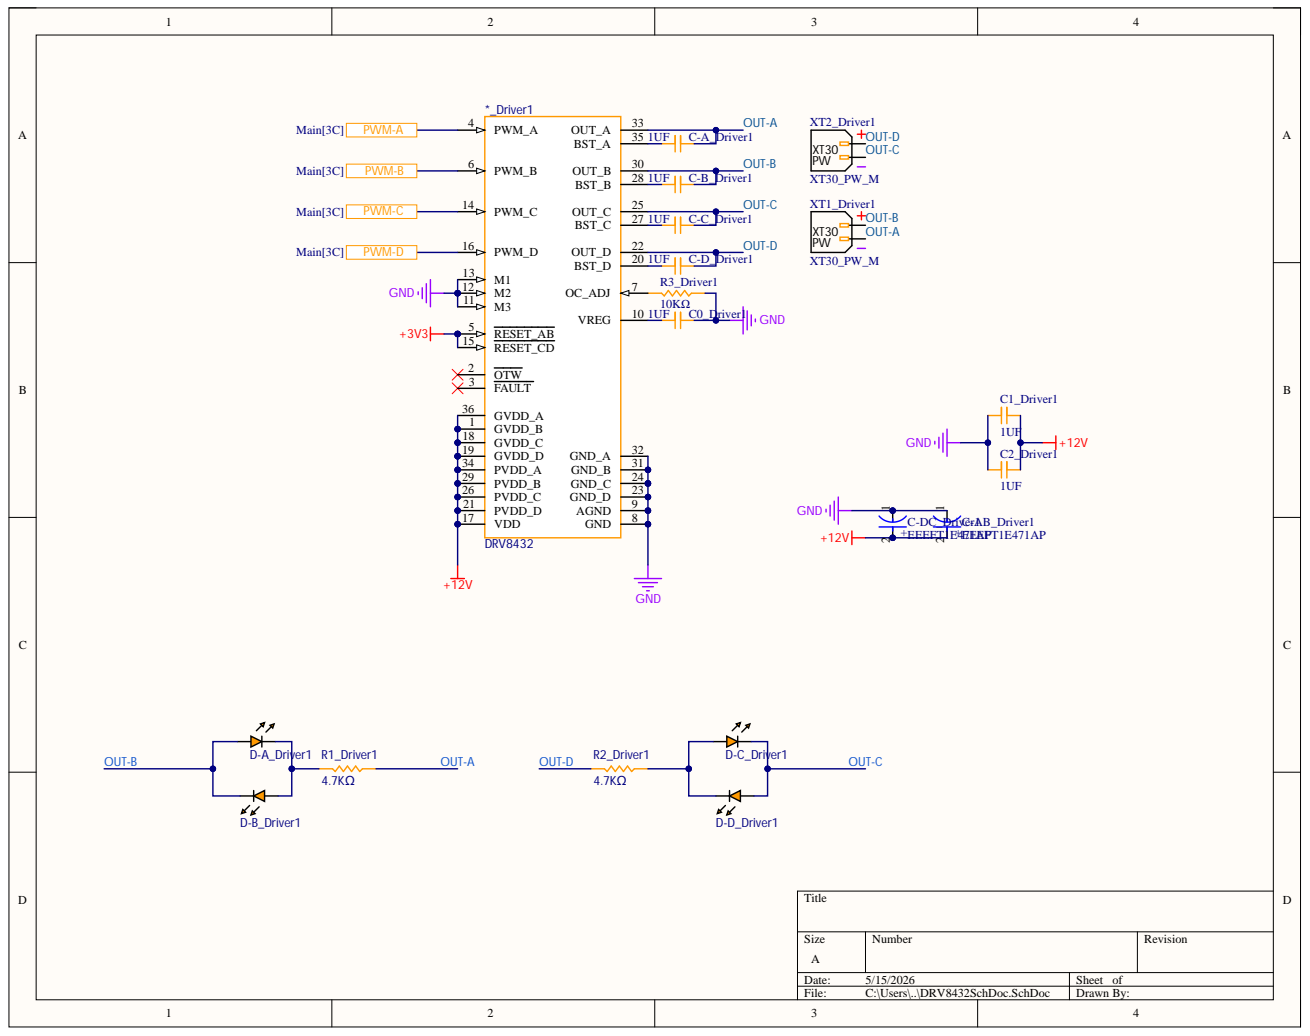
[picture p131: page 2]

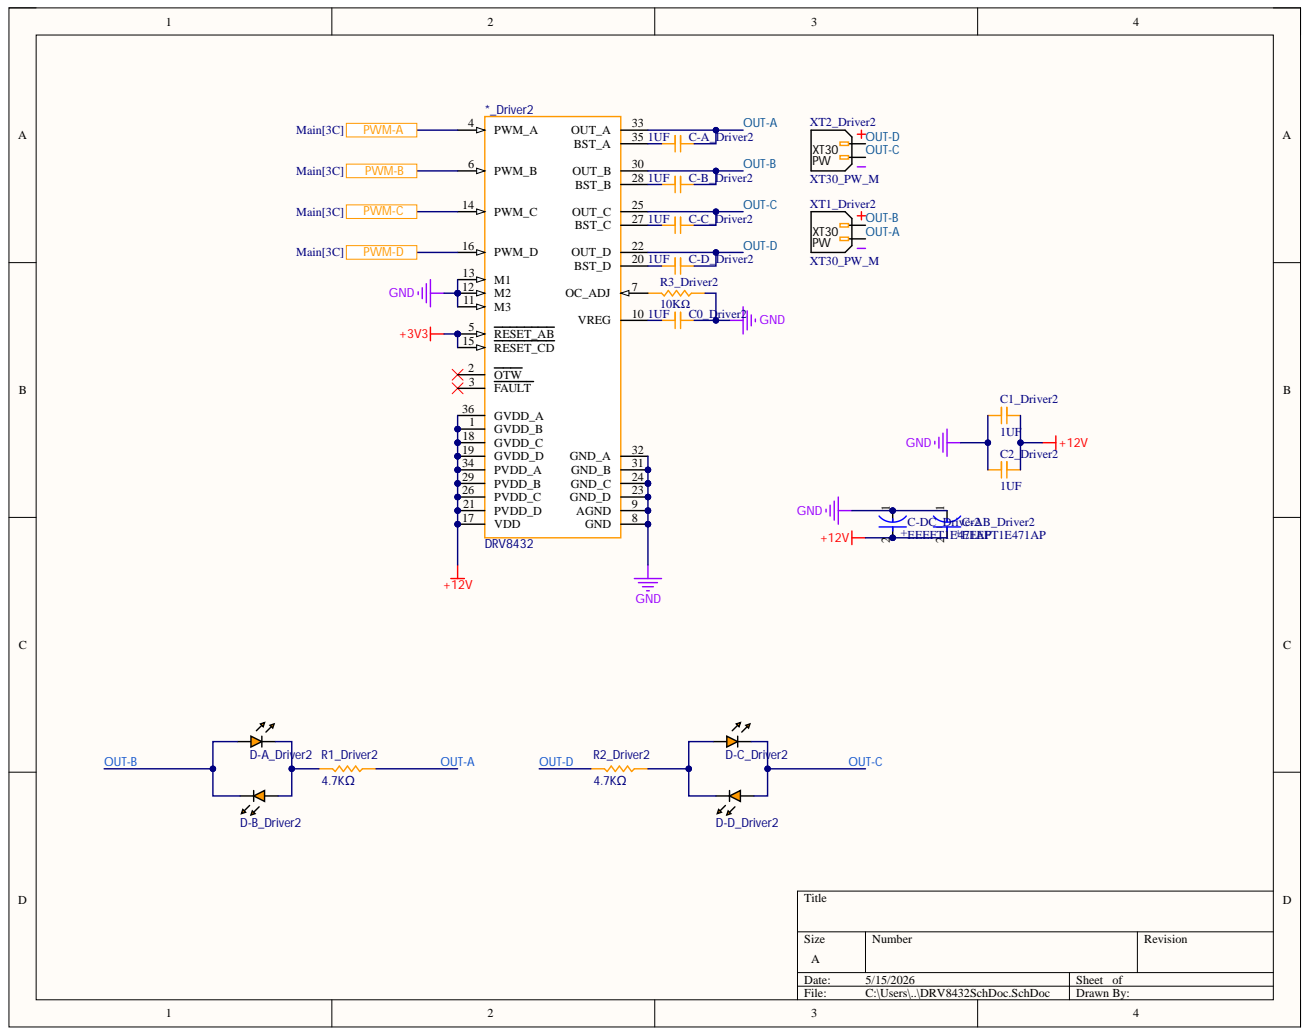
[picture p132: page 3]

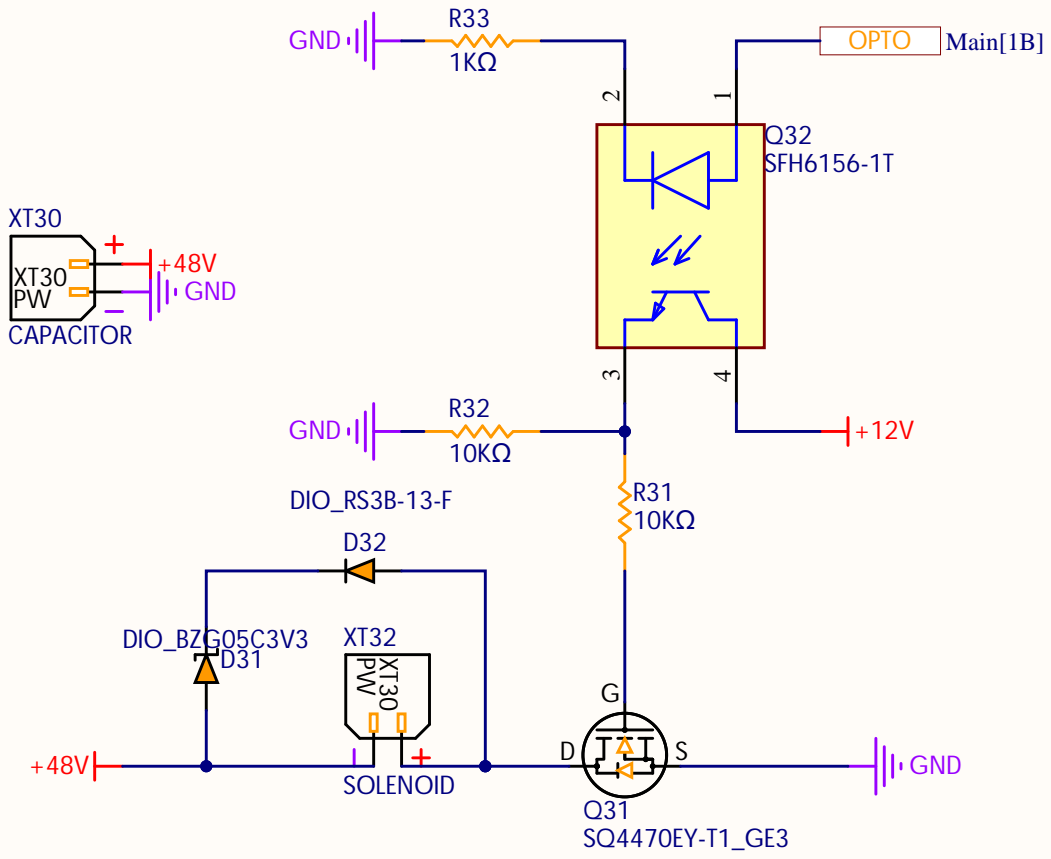
[picture p133: page 4]

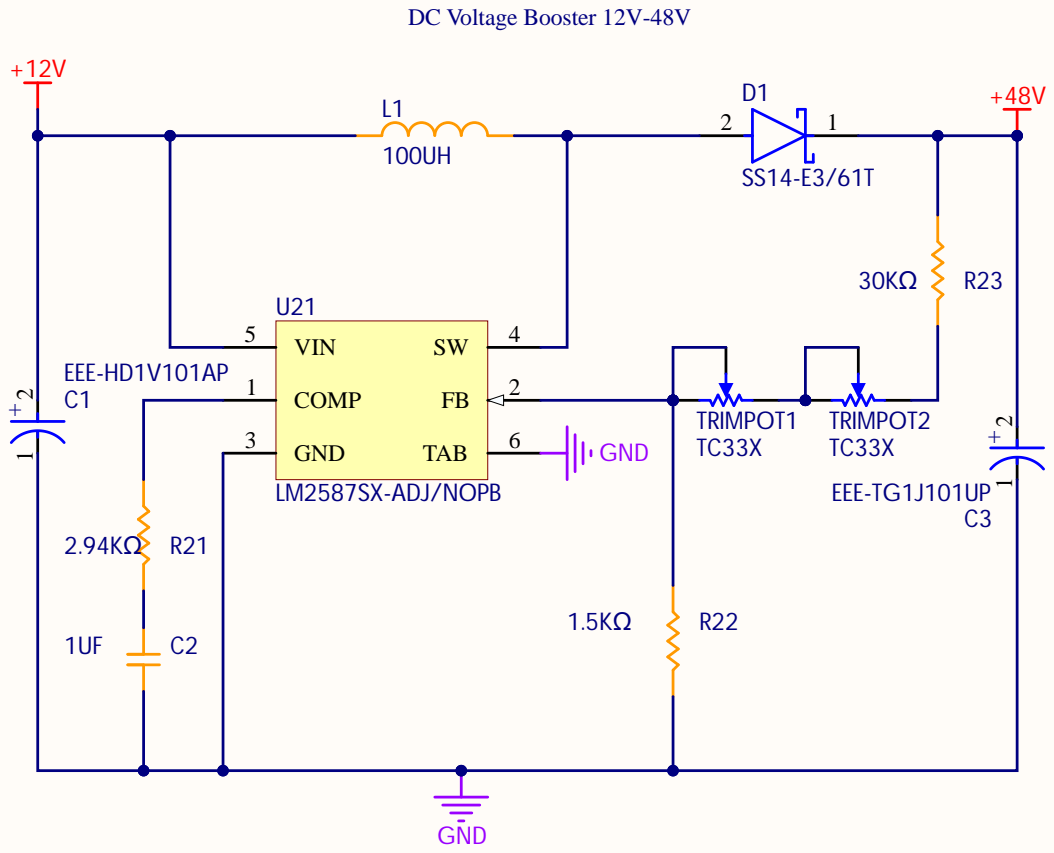
[picture p134: page 5]

EEE-HD1V101A P 1 | | 2
