chaBotsMX/chaBots-RCJ-IR-2026/Electrical/Media/OpenMVMountPCB.pdf

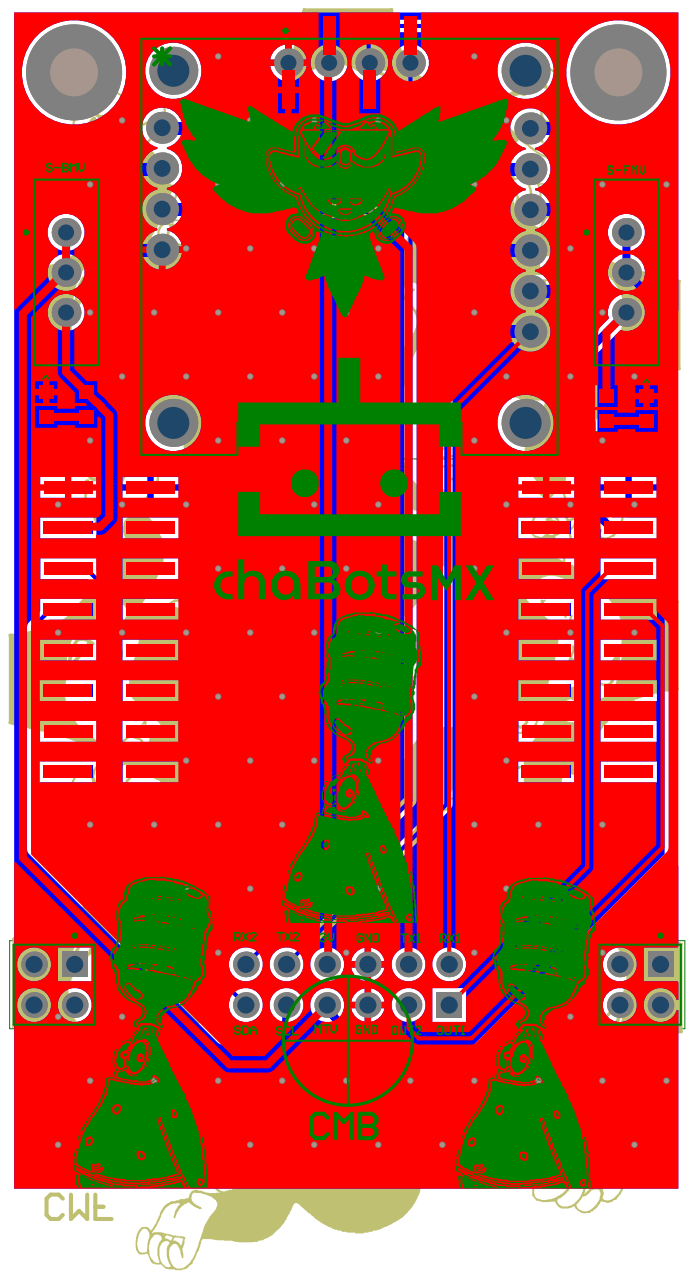
[picture p135: page 1]
