chaBotsMX/chaBots-RCJ-IR-2026/Electrical/Media/OpenMVMountSCH.pdf

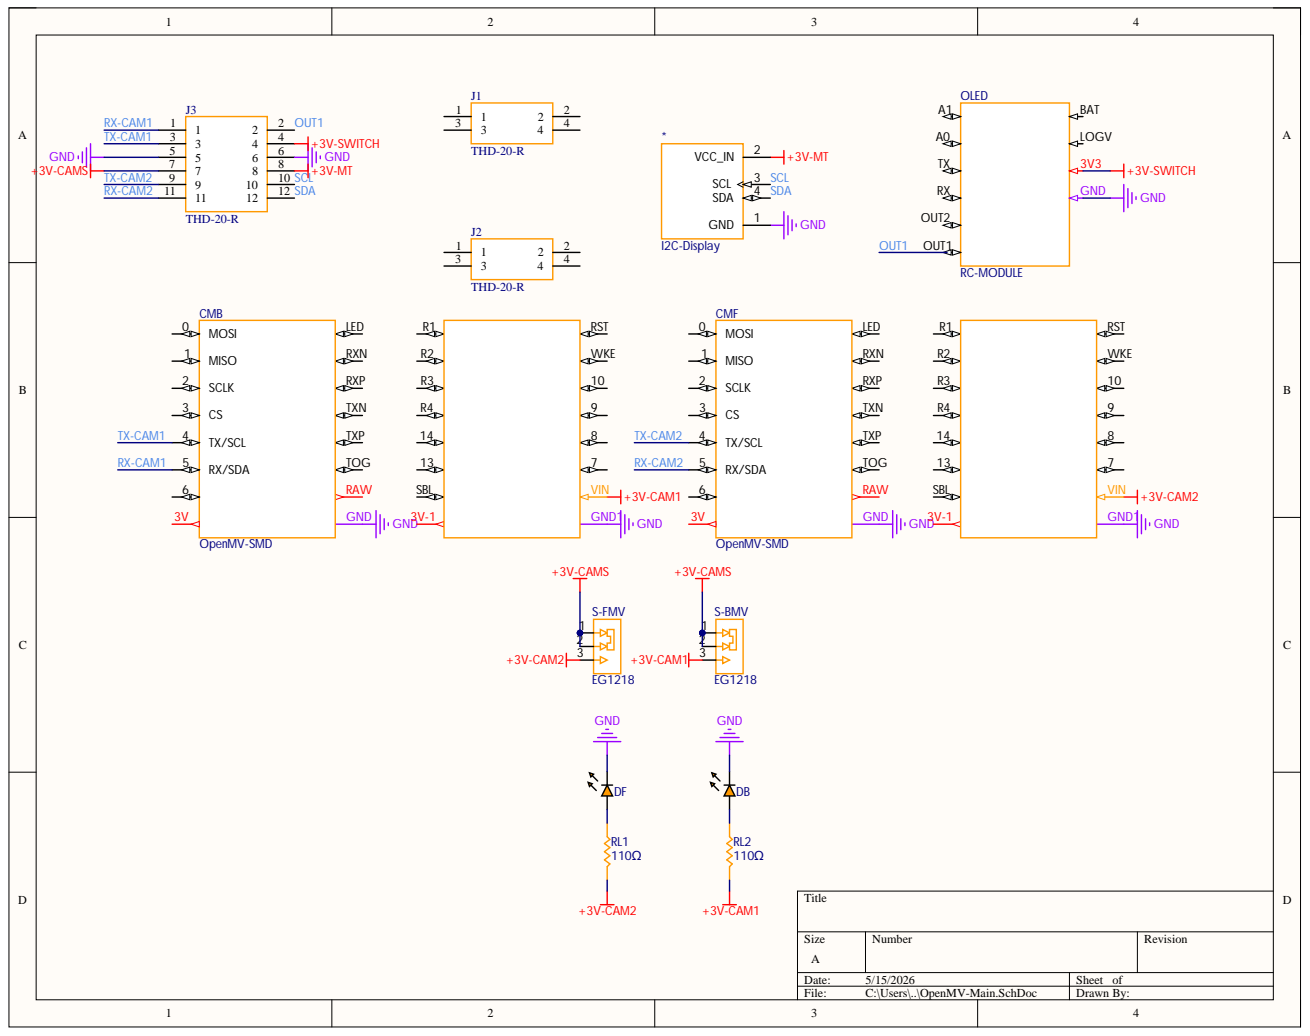
[picture p136: page 1]
