chaBotsMX/chaBots-RCJ-IR-2026/Electrical/Media/SideLinePCB.pdf

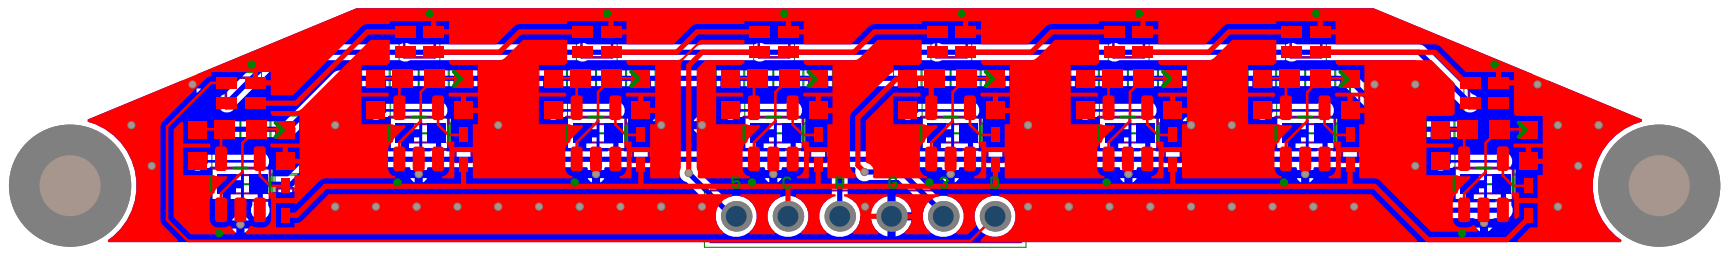
[picture p137: page 1]
