chaBotsMX/chaBots-RCJ-IR-2026/Electrical/Media/SideLineSCH.pdf

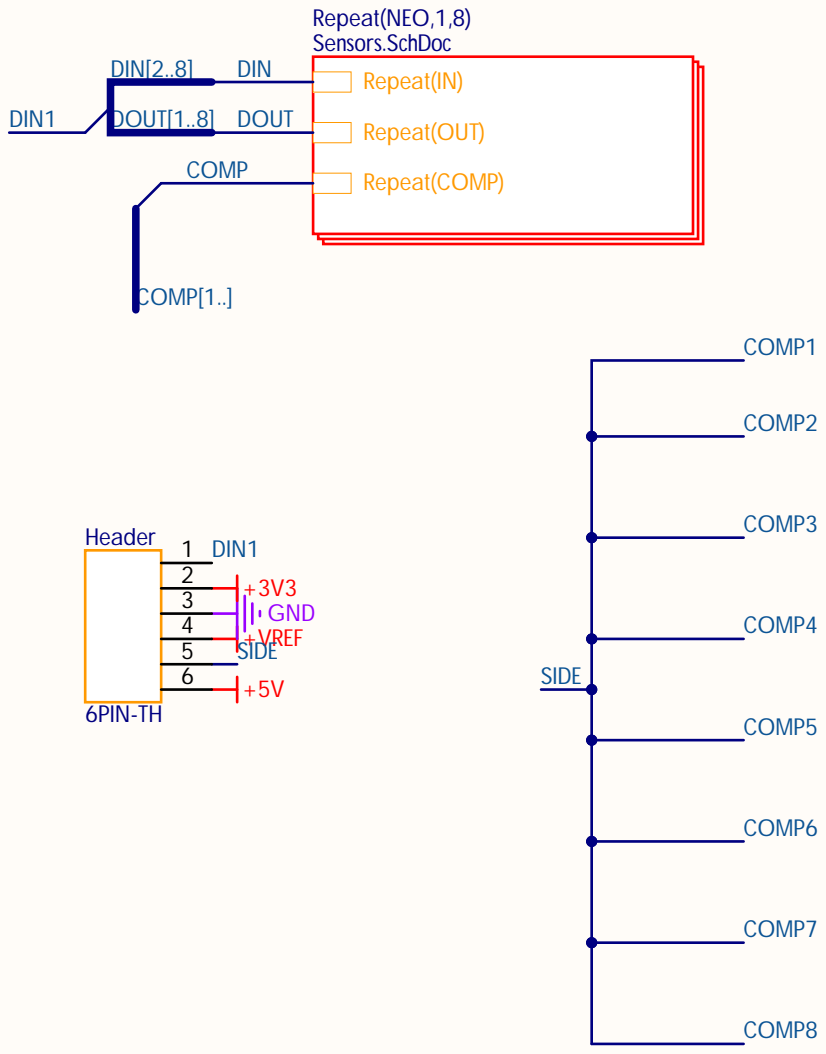
[picture p138: page 1]

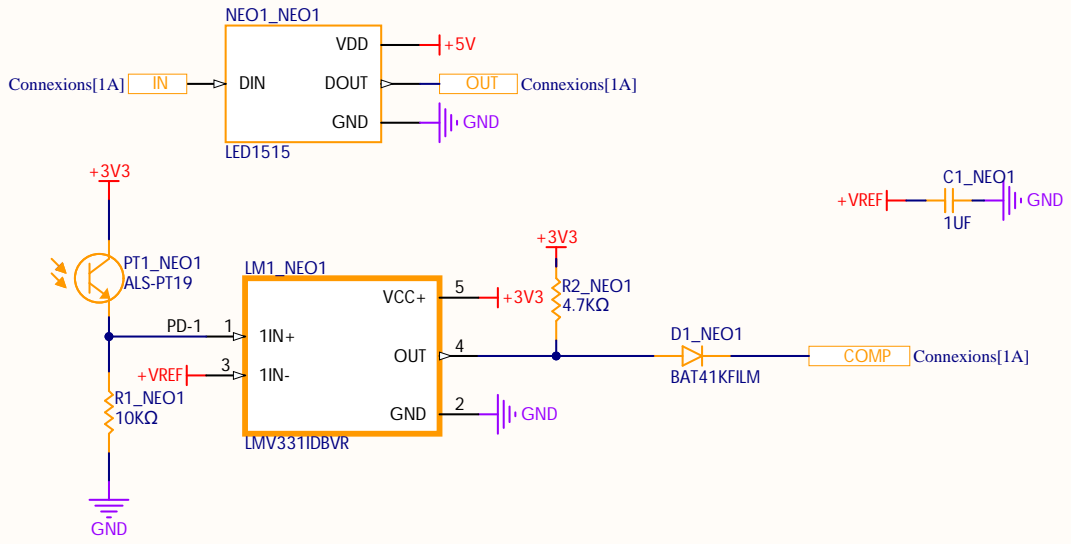
[picture p139: page 2]

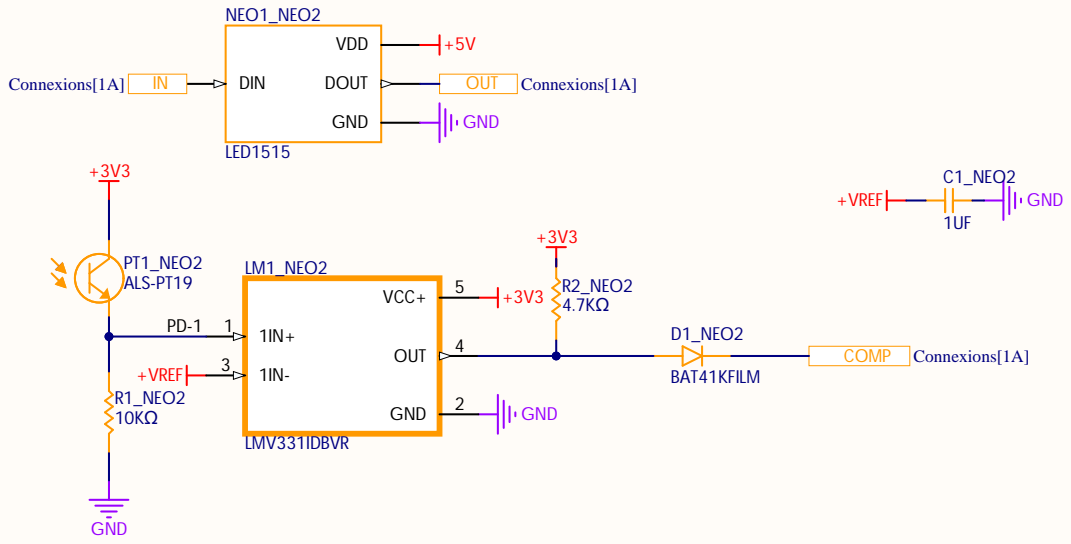
[picture p140: page 3]

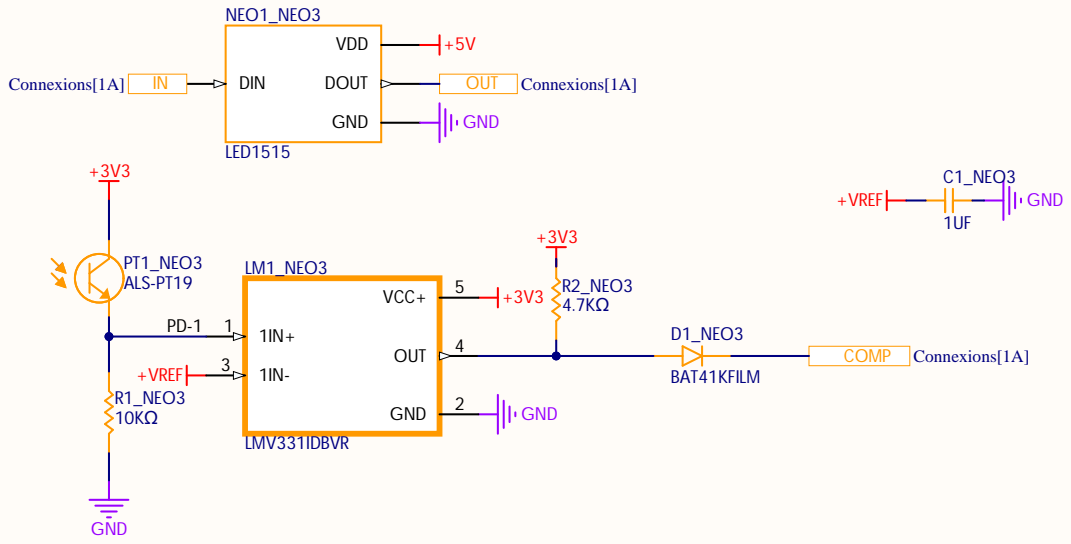
[picture p141: page 4]

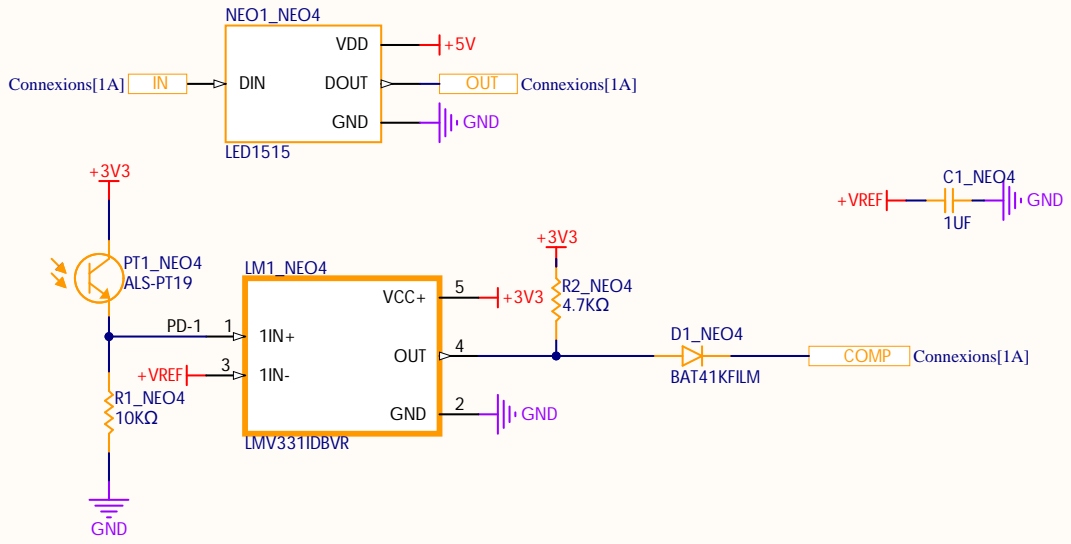
[picture p142: page 5]

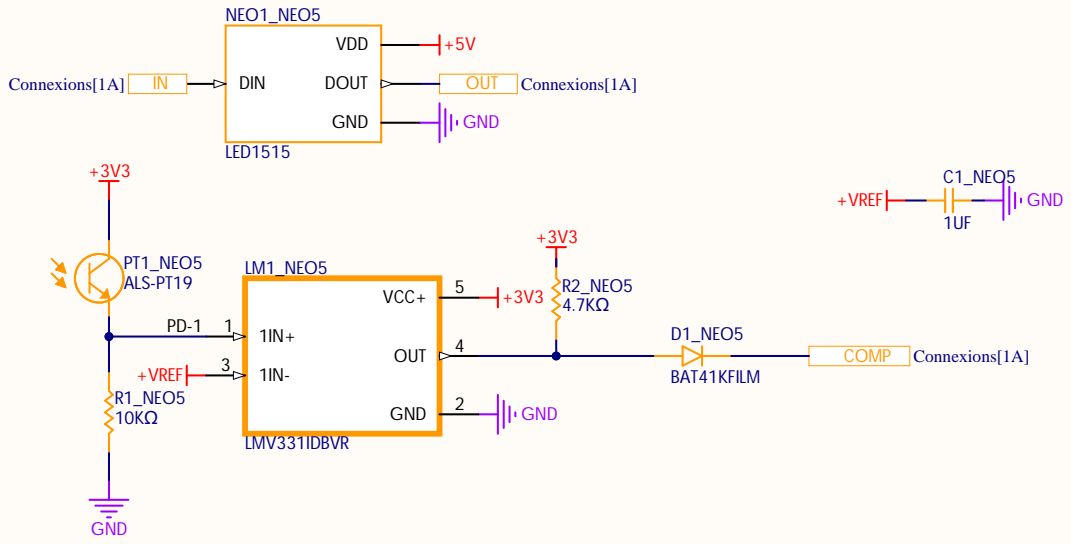
[picture p143: page 6]

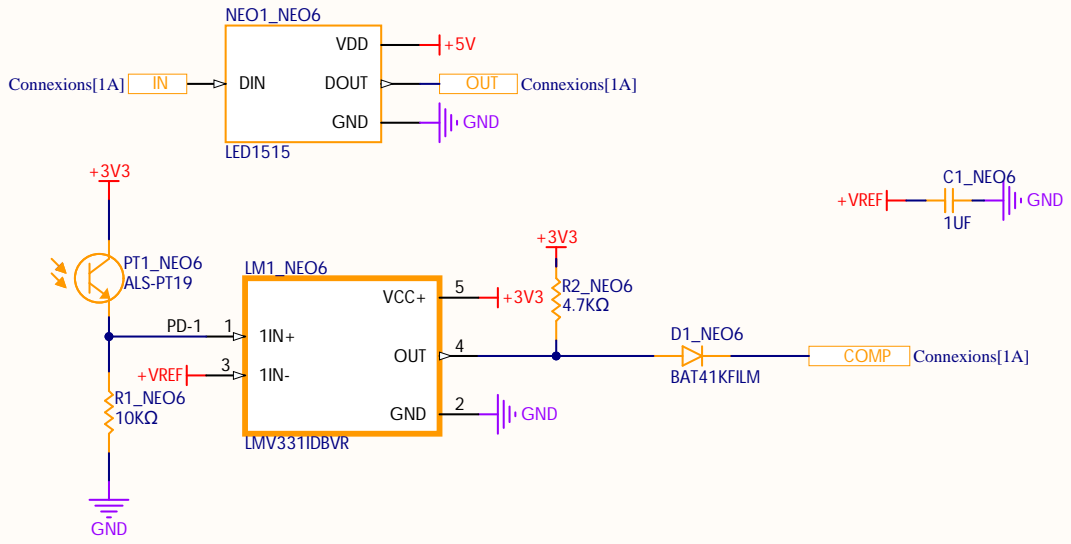
[picture p144: page 7]

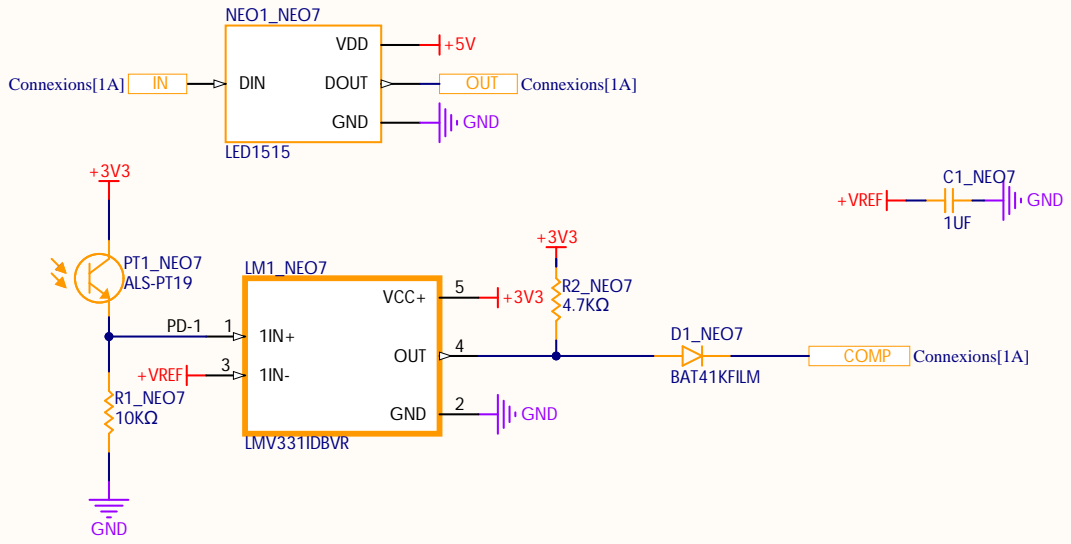
[picture p145: page 8]

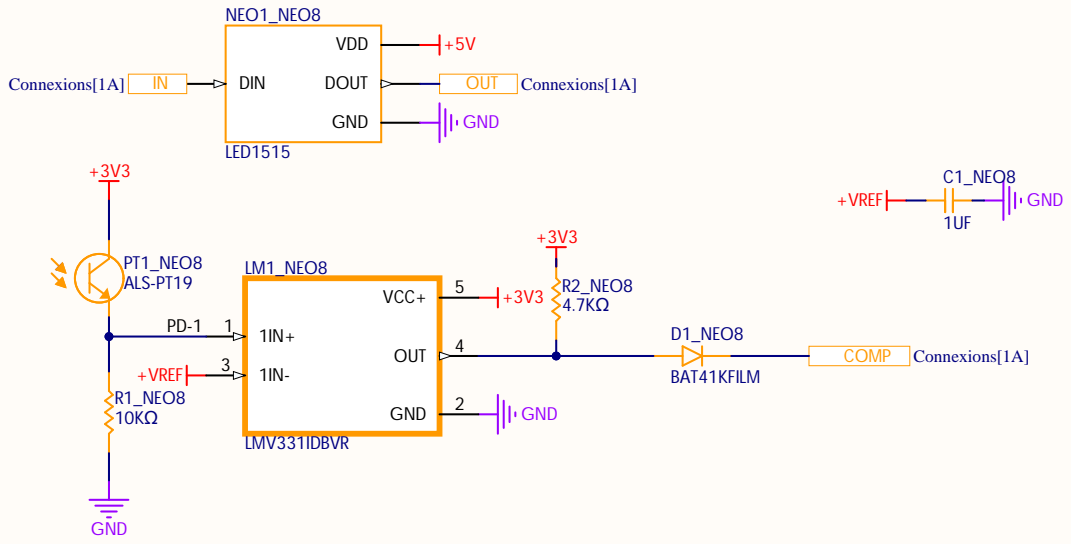
[picture p146: page 9]
