chaBotsMX/chaBots-RCJ-IR-2026/Mechanical/Media/GurtV1.pdf

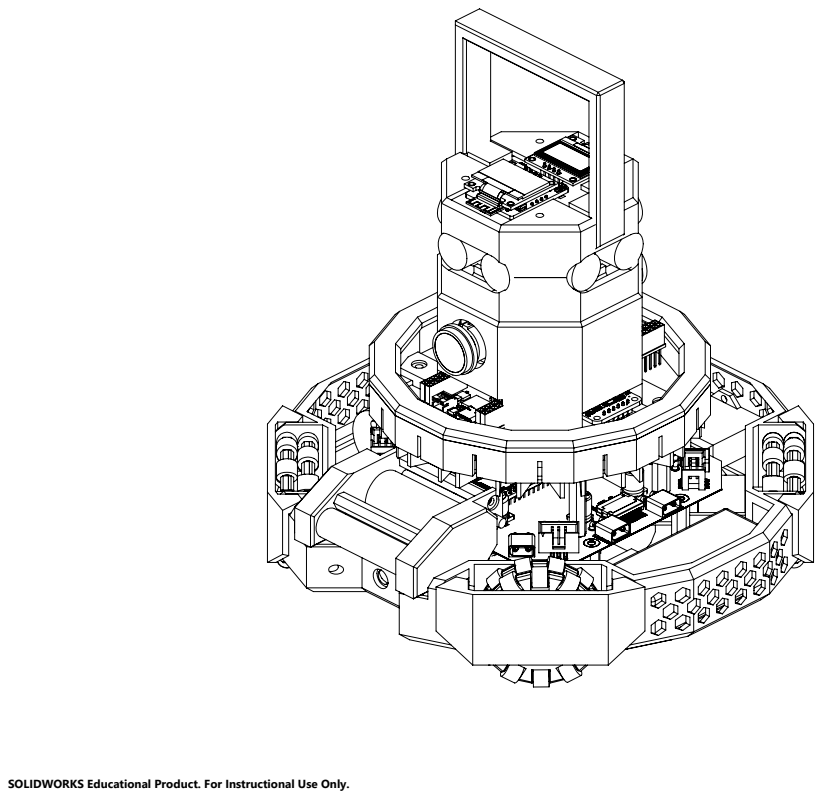
[picture p147: page 1]

SOLIDWORKS Educational Product. For Instructional Use Only.
