chaBotsMX/chaBots-RCJ-IR-2026/(list of files, drawings)

Other design files:
Electrical/BallSensor16/BallSensor16.PrjPcb
Electrical/BallSensor16/controllers.SchDoc
Electrical/BallSensor16/Sensors.SchDoc
Electrical/LightArray16/Array.PcbDoc
Electrical/LightArray16/Array.SchDoc
Electrical/LightArray16/LightArray16.PrjPcb
Electrical/LightArray16/NeoArray.SchDoc
Electrical/LightBarrier/LightBarrier.PcbDoc
Electrical/LightBarrier/LightBarrier.PrjPcb
Electrical/LightBarrier/LightBarrier.SchDoc
Electrical/LineConector/Headers.SchDoc
Electrical/LineConector/LineConector.PcbDoc
Electrical/LineConector/LineConector.PrjPcb
Electrical/LineSensor32/Comparator.SchDoc
Electrical/LineSensor32/LineSensor32.PcbDoc
Electrical/LineSensor32/LineSensor32.PrjPcb
Electrical/LineSensor32/Main.SchDoc
Electrical/LineSensor32/Neopixels.SchDoc
Electrical/Main-2026/DRV8432SchDoc.SchDoc
Electrical/Main-2026/Main-2026.PrjPcb
Electrical/Main-2026/Main.SchDoc
Electrical/Main-2026/MainBoard-16.PcbDoc
Electrical/Main-2026/OptocouplerKicker.SchDoc
Electrical/Main-2026/VoltageBooster48V.SchDoc
Electrical/OpenMVMount/OpenMV-Main.SchDoc
Electrical/OpenMVMount/OpenMVMount.PrjPcb
Electrical/SideLine/Connexions.SchDoc
Electrical/SideLine/Sensors.SchDoc
Electrical/SideLine/SideLine.PcbDoc
Electrical/SideLine/SideLine.PrjPcb
