chaBotsMX/chaBots-RCJ-IR-2026/src/code/src/main_attacker/main.cpp

#include <Arduino.h>
#include "Robot.h"
#include "UART.h"

Robot robot;
UART uart (Serial8, Serial5, Serial2, Serial7);
AttackerControl attacker;
MovementCommandAtk atkCmd;

unsigned long long updateTimer = 0;

int yawCorrection = 0;

int irAngle = 500;
int irDistance = 254;
int lineAngle = 500;
int pastLineAngle = 500;
int cameraAngle = 254;

float angularOffset = 0;

void setup() {
  Serial.begin(115200);
  uart.beginIR(2000000);
  uart.beginLine(2000000);
  uart.beginCamera(115200);

  robot.setLineNeo(true);
  robot.display.begin();

  if (!robot.imu.begin(Serial4)) {
    Serial.println("imu not found");
  }

  robot.displayVoltage();
}

void loop() {
  uart.receiveIR();
  uart.receiveLine();
  uart.receiveCamera();
  robot.kicker.update();

  irAngle = uart.irAngle*2;
  irDistance = uart.irDistance;
  lineAngle = uart.lineAngle*2;
  cameraAngle = uart.cameraAngle;

  if(millis() - updateTimer >= 10){
    updateTimer = millis();
    
    robot.updateButtons();
    robot.updateDisplay();
    
    Serial.print("IR Angle: ");Serial.println(irAngle);
    //Serial.print("IR Distance: ");Serial.println(irDistance);
    //Serial.print("Line Angle: ");Serial.println(lineAngle);
    //Serial.print("Camera Angle: ");Serial.println(cameraAngle);
    //Serial.print("Camera Distance: ");Serial.println(cameraDistance);
    //Serial.print("Camera Confidence: ");Serial.println(cameraConfidence);
    //Serial.print("Yaw: "); Serial.println(robot.imu.getYaw());
    //Serial.print("Camera Angle: ");Serial.println(cameraAngle);
    Serial.print("Distance Factor: ");Serial.println(attacker.debug_distanceFactor);
    Serial.print("Angle Factor: ");Serial.println(attacker.debug_angleFactor);
    Serial.print("Combined Factor: ");Serial.println(attacker.debug_combinedFactor);
  }

  if(robot.wasButton2Pressed()){
    atkCmd = attacker.calculateMovement(lineAngle, irAngle, irDistance, cameraAngle, robot.imu.getYaw());

    if(robot.imu.update()) yawCorrection = robot.getYawCorrection(atkCmd.rotation);

    robot.drive.driveToAngle(atkCmd.angle, atkCmd.power, yawCorrection);

    if(robot.hasBall(irAngle, irDistance)){
      robot.kicker.kick();
    }
  } else{
    robot.drive.writeAllMotorsOutput(0);
  }
}
