chaBotsMX/chaBots-RCJ-IR-2026/src/vision/back_camera.py

# back_camera.py

import sensor, time
from pyb import UART

sensor.set_contrast(0)
sensor.set_brightness(3)
sensor.set_saturation(0)

sensor.set_auto_gain(False, gain_db=30)  # Fixed gain
sensor.set_auto_rotation(False)

sensor.reset()
sensor.set_pixformat(sensor.RGB565)
sensor.set_framesize(sensor.QVGA)

sensor.skip_frames(time=2000)

clock = time.clock()

yellow_threshold = (50, 100, 11, 127, 39, 127)
#yellow_threshold = (41, 100, -7, 127, 30, 127) #hotel
blue_threshold = (0, 32, -2, 23, -128, 0)

goal_threshold = blue_threshold

roi = (0, 60, 320, 80)

FOV = 140

approximate_angle = 200

uart = UART(3, 115200, timeout_char=0)

sensor.set_windowing(roi)

while True:
    clock.tick()
    img = sensor.snapshot()

    for blob in img.find_blobs([yellow_threshold], pixels_threshold=5, area_threshold=2000):
        if blob is not None:
            approximate_angle = int((blob.cx() * FOV) / 320)

            img.draw_rectangle(blob.rect())
            img.draw_cross(blob.cx(), blob.cy())
        else:
            approximate_angle = 200

    print(approximate_angle, clock.fps())
    uart.write(bytes([255]))
    uart.write(bytes([approximate_angle]))
