chaBotsMX/chaBots-RCJ-IR-2026/(commit log)

2026-03-02 working ball detection, needs filtering
    idk, its so noisy
2026-03-04 silly fix
    still need to implement filter
    hardware fault
    [main.cpp]
2026-03-17 filtering didnt work lol
2026-03-19 new ir sensors detection
2026-03-20 updated ir and added uart
    lol i forgot to switch branches but im lazy to do it now so I'll leave the uart thingy here
2026-03-22 updated line, corrected motors
    small fix
    [main.cpp]
2026-03-28 fixed ball following logic
    [main.cpp]
2026-03-29 added filters to ir
2026-04-08 fixed and cleaned ir code
    [main.cpp]
2026-04-11 refactored main teensy code
2026-04-11 updated line avoiding logic
    [main.cpp]
2026-04-12 adapted goalie logic to current robot
2026-04-14 fixed ball detection, game logic
    [main.cpp]
2026-04-16 added button logic
2026-04-16 camera and game logic
2026-04-16 checkpoint
    adjusted attacker and cameras
2026-05-15 Electrical
    .git was the problem
    [5PIN_5PIN.x_t, 6PIN-SMD_6PIN-SMD.x_t, ALS-PT19_ALS-PT19.x_t, Array.PcbDoc, Array.SchDoc, BOUR-TC33X-2_V_CMP-2100-03695-1.x_t, BallSensor16.PrjPcb, CAP_0603_CAP_0603.x_t]
2026-05-15 Dribbler/Wheel
    Files
    [2040.SLDPRT, 45mm Wheel.SLDASM, 45mm Wheel.SLDPRT, DowelPin9mm-1.5mm.SLDPRT, Dribbler.SLDASM, SiliconeRoller8mm.SLDPRT, Sleeve-.4.STL, Sleeve.SLDPRT]
2026-05-19 optimized uart i think
2026-05-21 configure project for esp32c6
2026-05-23 working distance sensor code
2026-05-23 working uart, overall fix
    [main.cpp]
2026-05-30 localization class using distance sensors
2026-06-03 back camera
2026-06-04 Revert "Merge feat/vision-based-localization"
    This reverts commit 2c180a879356e3ac3b1db91c7d2659a4e8a1e07a, reversing
    changes made to 4b43460b1e1f110ecc557f17a66a8ea0e311734b.
    [back_camera.py, front_camera.py]
2026-06-04 Revert "Merge feat/ultrasonic-sensor-lib"
    This reverts commit 4b43460b1e1f110ecc557f17a66a8ea0e311734b, reversing
    changes made to d63b9887cb5b500b02f2009c9072426faf967fd1.
    [main.cpp]
2026-06-15 updated camera code for N6
2026-06-21 display and camera
2026-07-09 distance sensor implementation
2026-07-09 bro thinks he knows where he at
    coordinate system using ultrasonic sensors
2026-08-02 openmv new api fix
    [front_camera.py]
